evolutek/carte-actionneurs/Carte Stepper V1/Mapping STM32.PNG

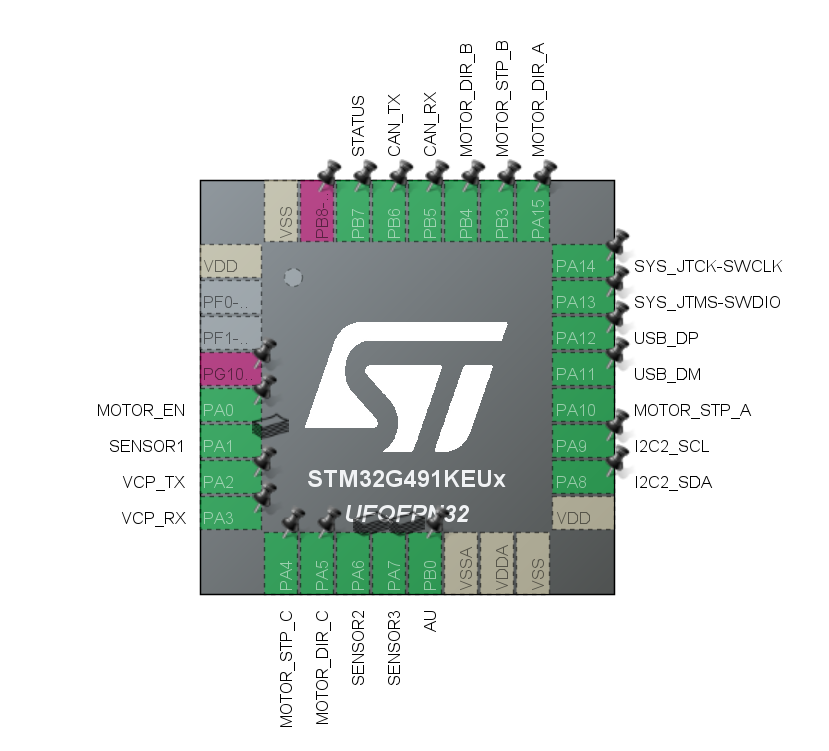
Carte Stepper V1/Mapping STM32.PNG
