evolutek/carte-actionneurs/Carte ADC/Output/carte-adc.step

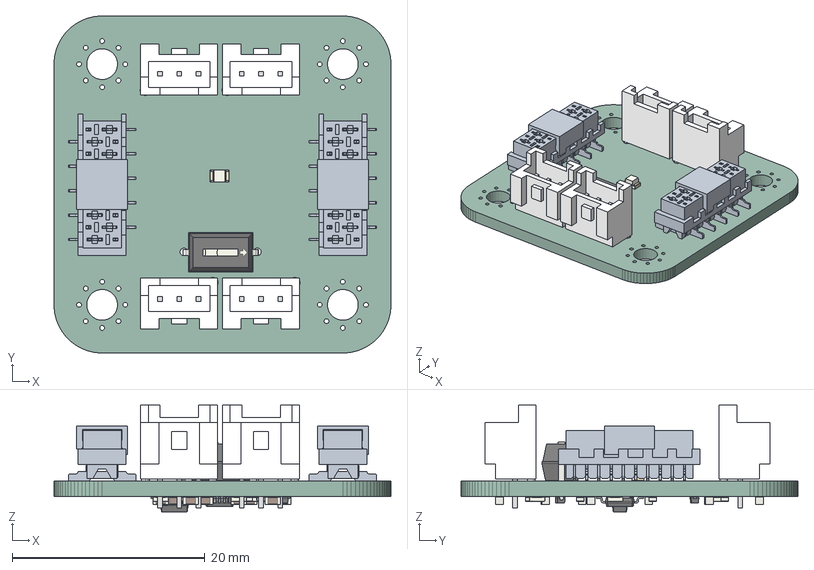
[picture p2: CAD file, 2025-06-11]
Carte ADC/Output/carte-adc.step
35.0 x 35.0 x 11.1 mm
Assem1 x 2
LED_0805_2012Metric
B03B-PASK-1 x 4
SW_DIP_SPSTx01_Slide_67x41mm_W762mm_P254mm_LowProfile
R_0603_1608Metric x 12
TSSOP_10_3x3mm_P05mm
C_0603_1608Metric x 11
D_SOD_523 x 4
SOT_23_5
carte-adc PCB
