evolutek/carte-actionneurs/Cartes PAL 2026/Carte Fixe/Output/carte-fixe V1.0.step

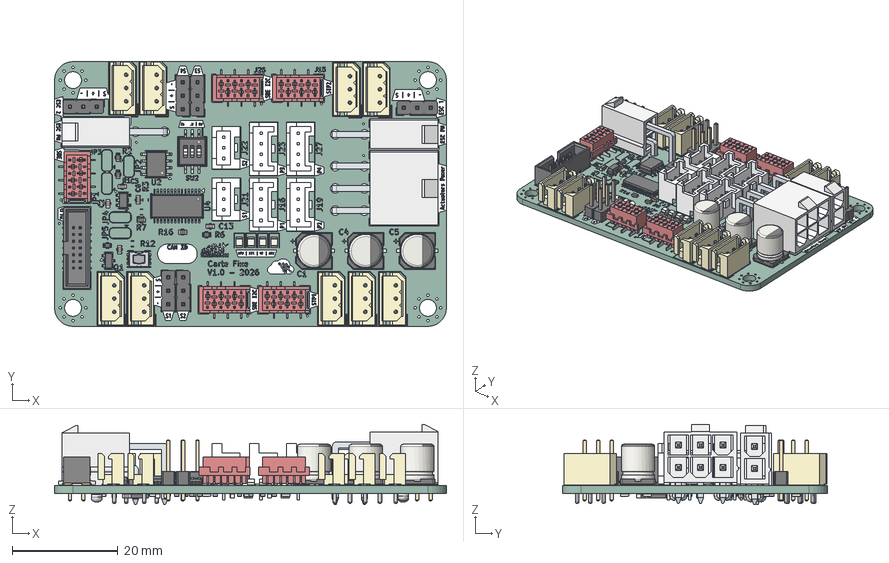
[picture p3: CAD file, 2026-10-21]
Cartes PAL 2026/Carte Fixe/Output/carte-fixe V1.0.step
74.0 x 50.0 x 15.2 mm
R_0603_1608Metric x 30
PinHeader_1x03_P2.54mm_Vertical x 6
SOIC-8_3.9x4.9mm_P1.27mm
B04B-PASK-1 x 4
6490xx227222_PIN x 5
6490xx227222_PIN_BIS x 5
CP_Elec_6.3x7.7 x 3
C_0603_1608Metric x 15
69036728xx76_PIN x 30
B03B-PASK-1 x 2
TSSOP-28_4.4x9.7mm_P0.65mm
QFN-32-1EP_5x5mm_P0.5mm_EP3.45x3.45mm
SOT-23-5
SW_DIP_SPSTx03_Slide_KingTek_DSHP03TS_W7.62mm_P1.27mm
Frame
Cover
Terminal
Button
SOT-23
6270xx20621_PIN x 14
LED_0805_2012Metric x 4
carte-fixe_silkscreen x 2
carte-fixe_PCB
