evolutek/carte-actionneurs/Cartes PAL 2026/Carte Mobile/Output/carte-mobile V1.0.step

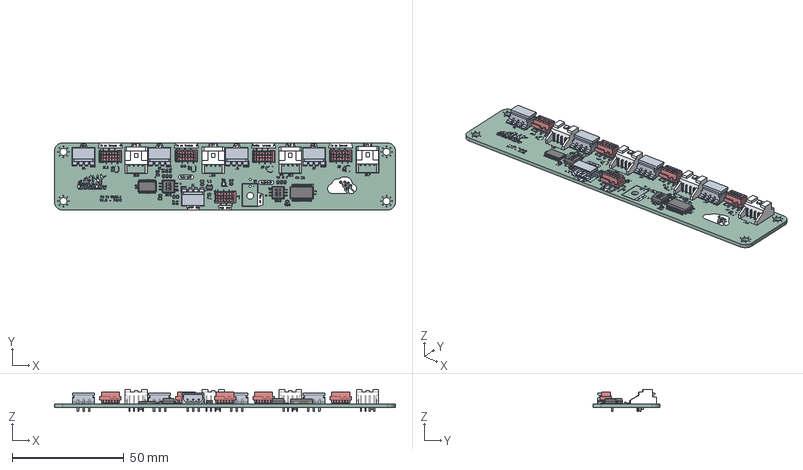
[picture p4: CAD file, 2026-10-21]
Cartes PAL 2026/Carte Mobile/Output/carte-mobile V1.0.step
152.5 x 30.0 x 9.95 mm
R_0603_1608Metric x 11
69036728xx76_PIN x 30
SOT-23-5
C_0603_1608Metric x 8
SSOP-28_5.3x10.2mm_P0.65mm
S04B-PASK-2 x 4
SW_DIP_SPSTx03_Slide_KingTek_DSHP03TS_W7.62mm_P1.27mm x 2
LED_0805_2012Metric
TSSOP-24_4.4x7.8mm_P0.65mm
carte-mobile_silkscreen x 2
carte-mobile_PCB
