evolutek/carte-actionneurs/Constellations actionneurs/Hololutek 2026 - Doigts/Output/Doigts 1.0.step

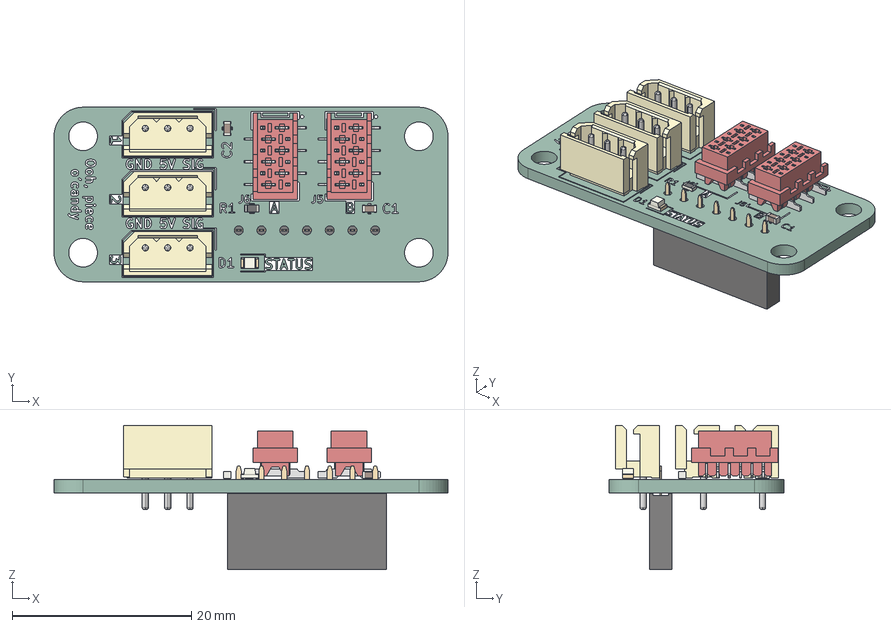
[picture p5: CAD file, 2026-05-03]
Constellations actionneurs/Hololutek 2026 - Doigts/Output/Doigts 1.0.step
44.0 x 19.5 x 16.1 mm
C_0603_1608Metric x 2
LED_0805_2012Metric
69036728xx76_PIN x 12
R_0603_1608Metric
PinSocket_1x07_P2.54mm_Vertical
Doigts_silkscreen x 2
Doigts_PCB
