evolutek/carte-actionneurs/Constellations actionneurs/Hololutek 2026 - Repartiteur/Output/Repartiteur 1.0.step

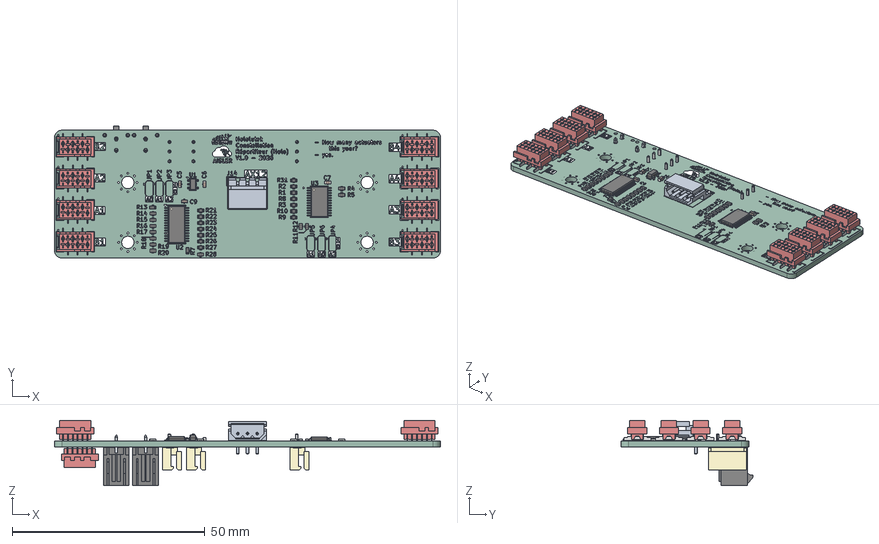
[picture p6: CAD file, 2026-05-03]
Constellations actionneurs/Hololutek 2026 - Repartiteur/Output/Repartiteur 1.0.step
100.0 x 34.2 x 16.9 mm
TSSOP-28_4.4x9.7mm_P0.65mm
R_0603_1608Metric x 28
69036728xx76_PIN x 54
TSSOP-24_4.4x7.8mm_P0.65mm
C_0603_1608Metric x 4
SOT-23-5
6620xx21122_PIN x 4
Repartiteur_silkscreen x 2
Repartiteur_PCB
