evolutek/carte-actionneurs/Cartes PAL 2026/Carte Fixe/Output/carte-fixe.pdf

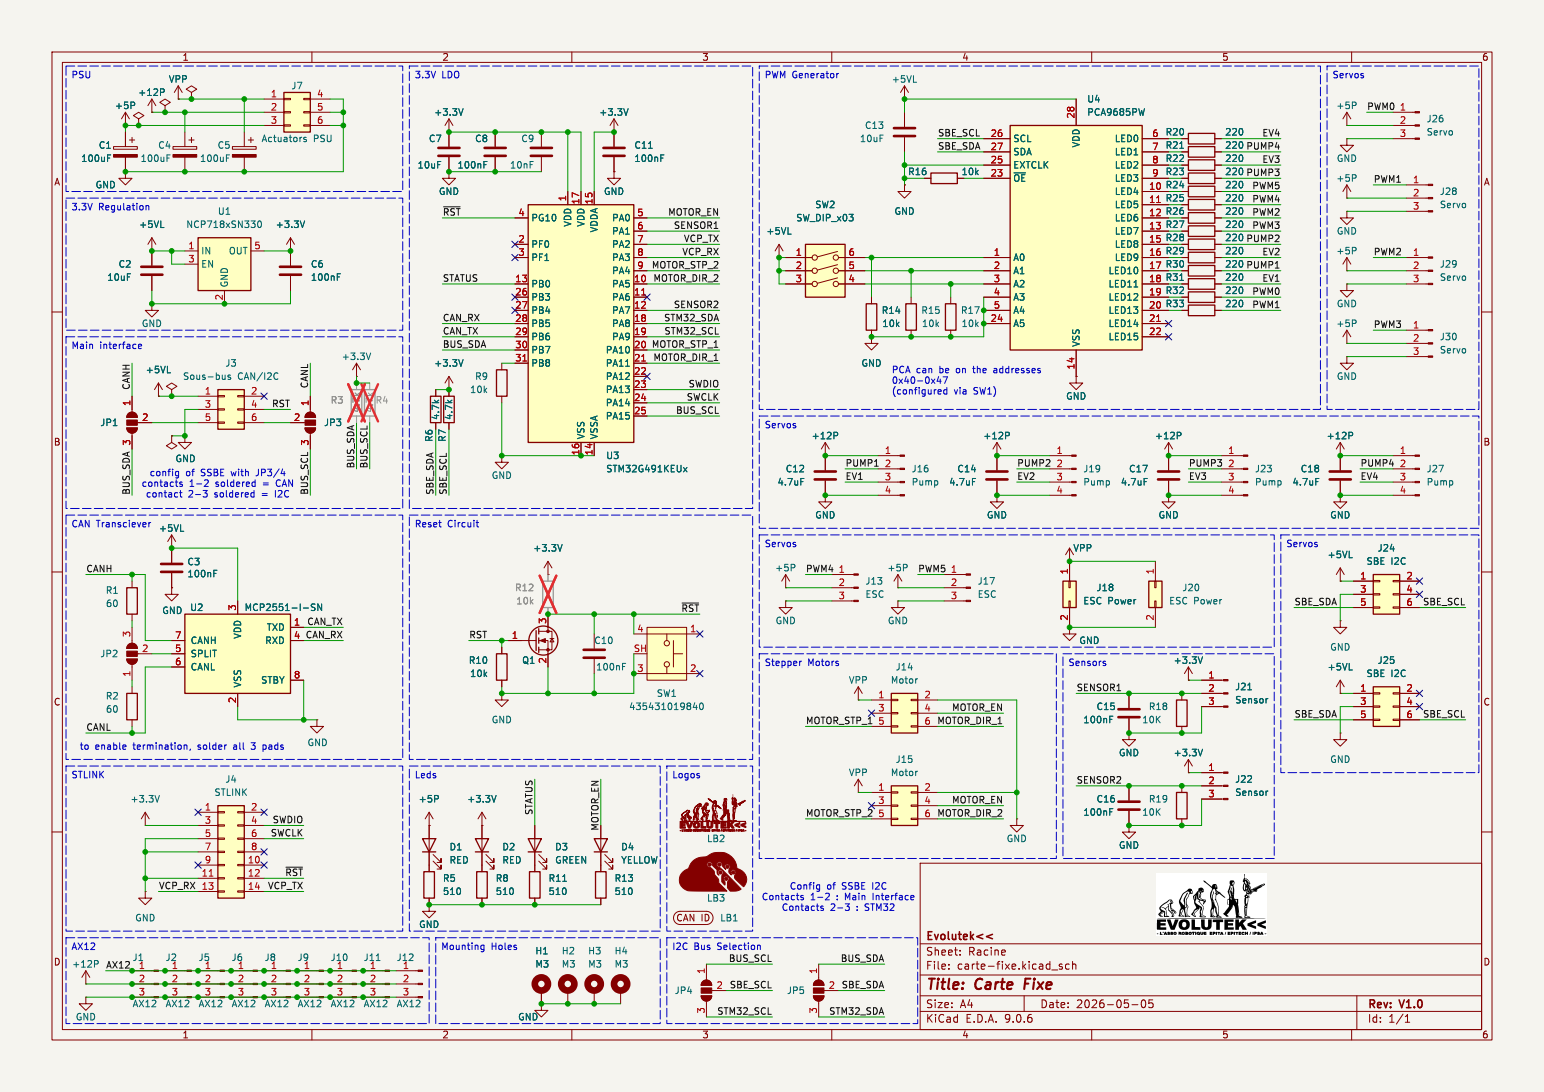
[picture p7: page 1]

1 VDD 17 VSS 16 VDDA 15 VSSA 14 PA0 5 PA1 6 PA2 7 PA3 8 PA4 9 PA5 10 PA6 11 PA7 12 PA8 18 PA9 19 PA10 20 PA11 21 PA12 22 PA13 23 PA14 24 PA15 25 +3.3V GND

1 VDD 17 VSS 16 VDDA 15 VSSA 14 PA0 5 PA1 6 PA2 7 PA3 8 PA4 9 PA5 10 PA6 11 PA7 12 PA8 18 PA9 19 PA10 20 PA11 21 PA12 22 PA13 23 PA14 24 PA15 25 U3STM32G491KEUx +5VL R6 4.7k

GND
PCA can be on the addresses 0x40-0x47

config of SSBE with JP3/4

J18 ESC Power TXD 1 RXD 4 STBY 8 VDD

2 CANH 7 SPLIT 5 CANL 6 U2 MCP2551-I-SN

3 VSS
TXD 1 RXD 4 STBY 8 VDD

File: carte-fixe.kicad_sch Sheet: Racine Evolutek<<

Id: 1/1 Title: Carte Fixe
