evolutek/carte-actionneurs/Cartes PAL 2026/Carte Mobile/Output/carte-mobile.pdf

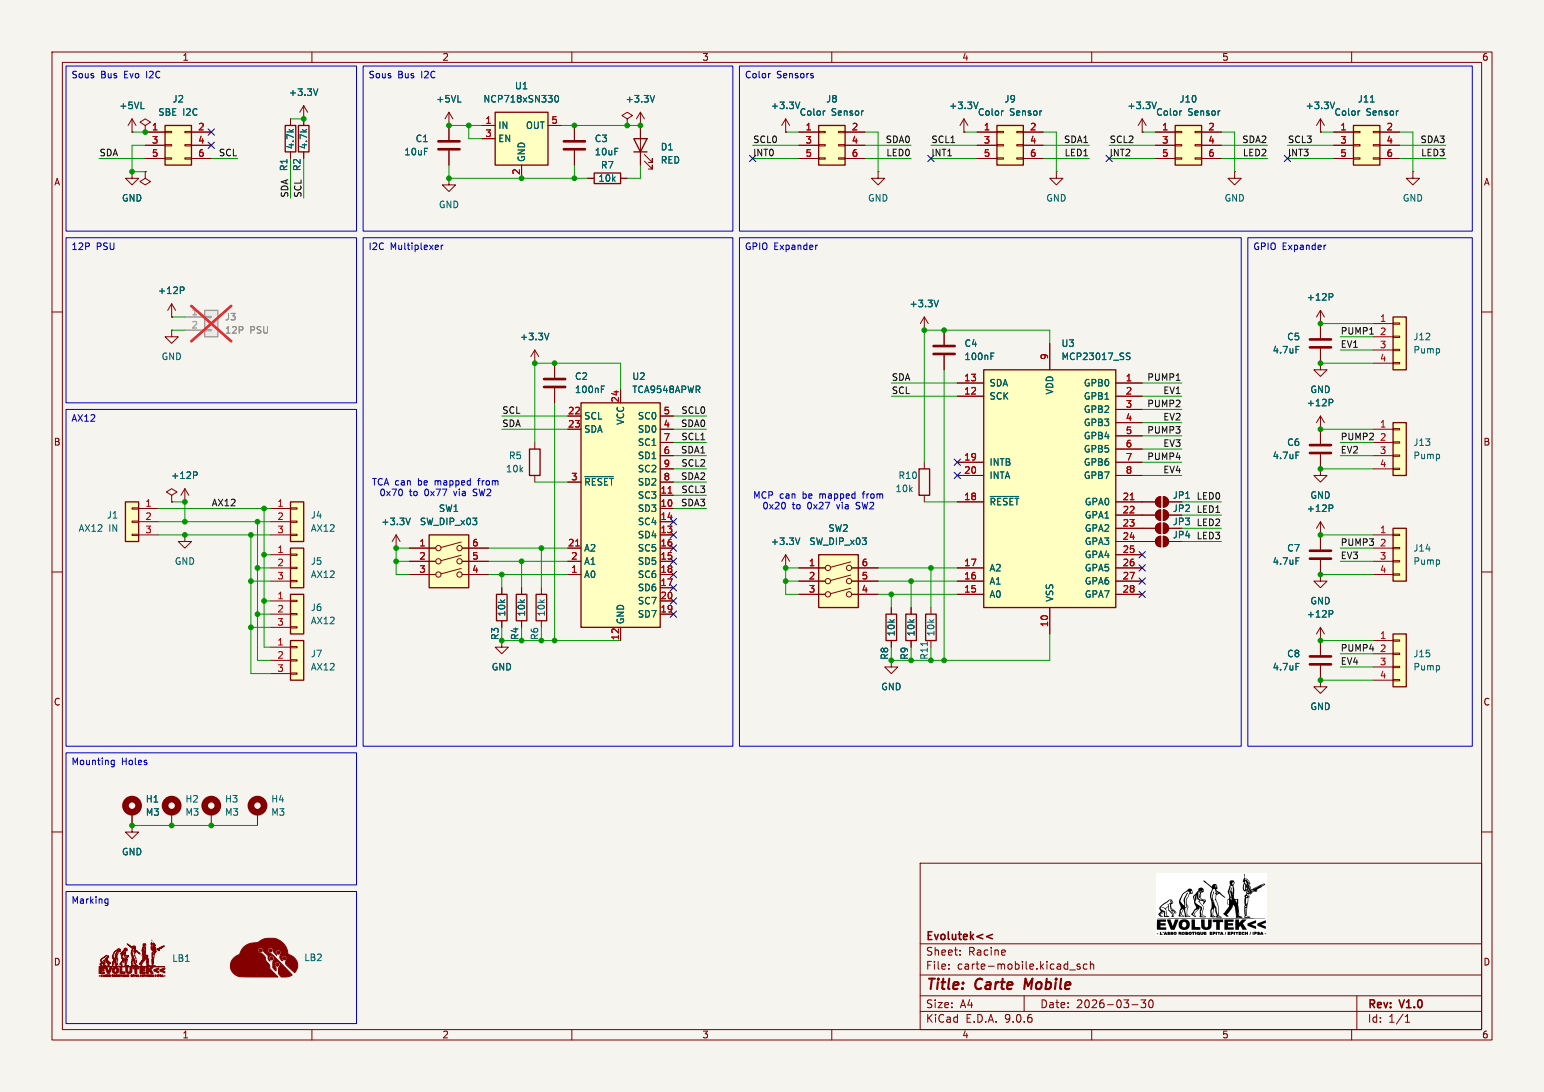
[picture p8: page 1]

Color Sensors Mounting Holes

2 OUT 5 U1 NCP718xSN330 +3.3V +3.3V R7
J11 Color Sensor GND GND

0x20 to 0x27 via SW2 TCA can be mapped from
0x70 to 0x77 via SW2

File: carte-mobile.kicad_sch Sheet: Racine Evolutek<<

Id: 1/1 Title: Carte Mobile
