evolutek/carte-actionneurs/Constellations actionneurs/Hololutek 2026 - Repartiteur/Output/Repartiteur.pdf

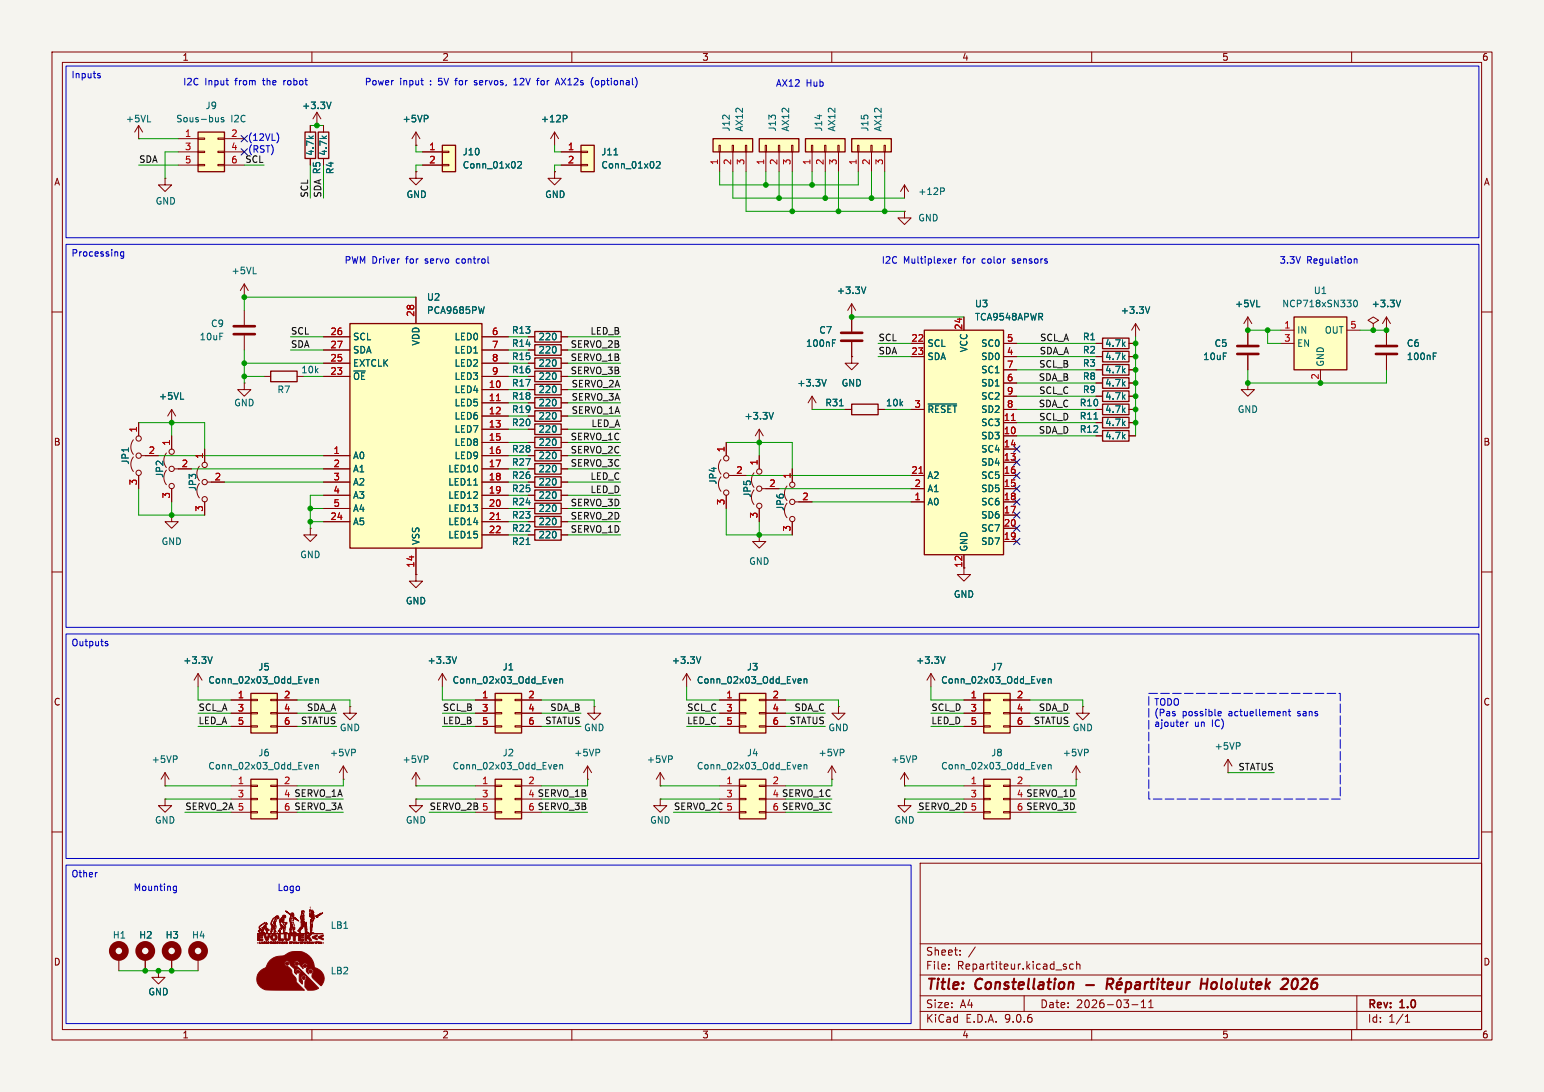
[picture p9: page 1]

3 J14 AX12 SCL 22 SDA 23 ~{RESET} 3 A2 21 A1 2 A0 1 VCC 24 GND 12 SC0 5 SD0 4 SC1 7 SD1 6 SC2 9 SD2 8 SC3 11 SD3 10 SC4 14 SD4 13 SC5 16 SD5 15 SC6 18 SD6 17 SC7 20 SD7 19 U3 TCA9548APWR
