evolutek/carte-actionneurs/Carte ADC/Output/Schematics.pdf

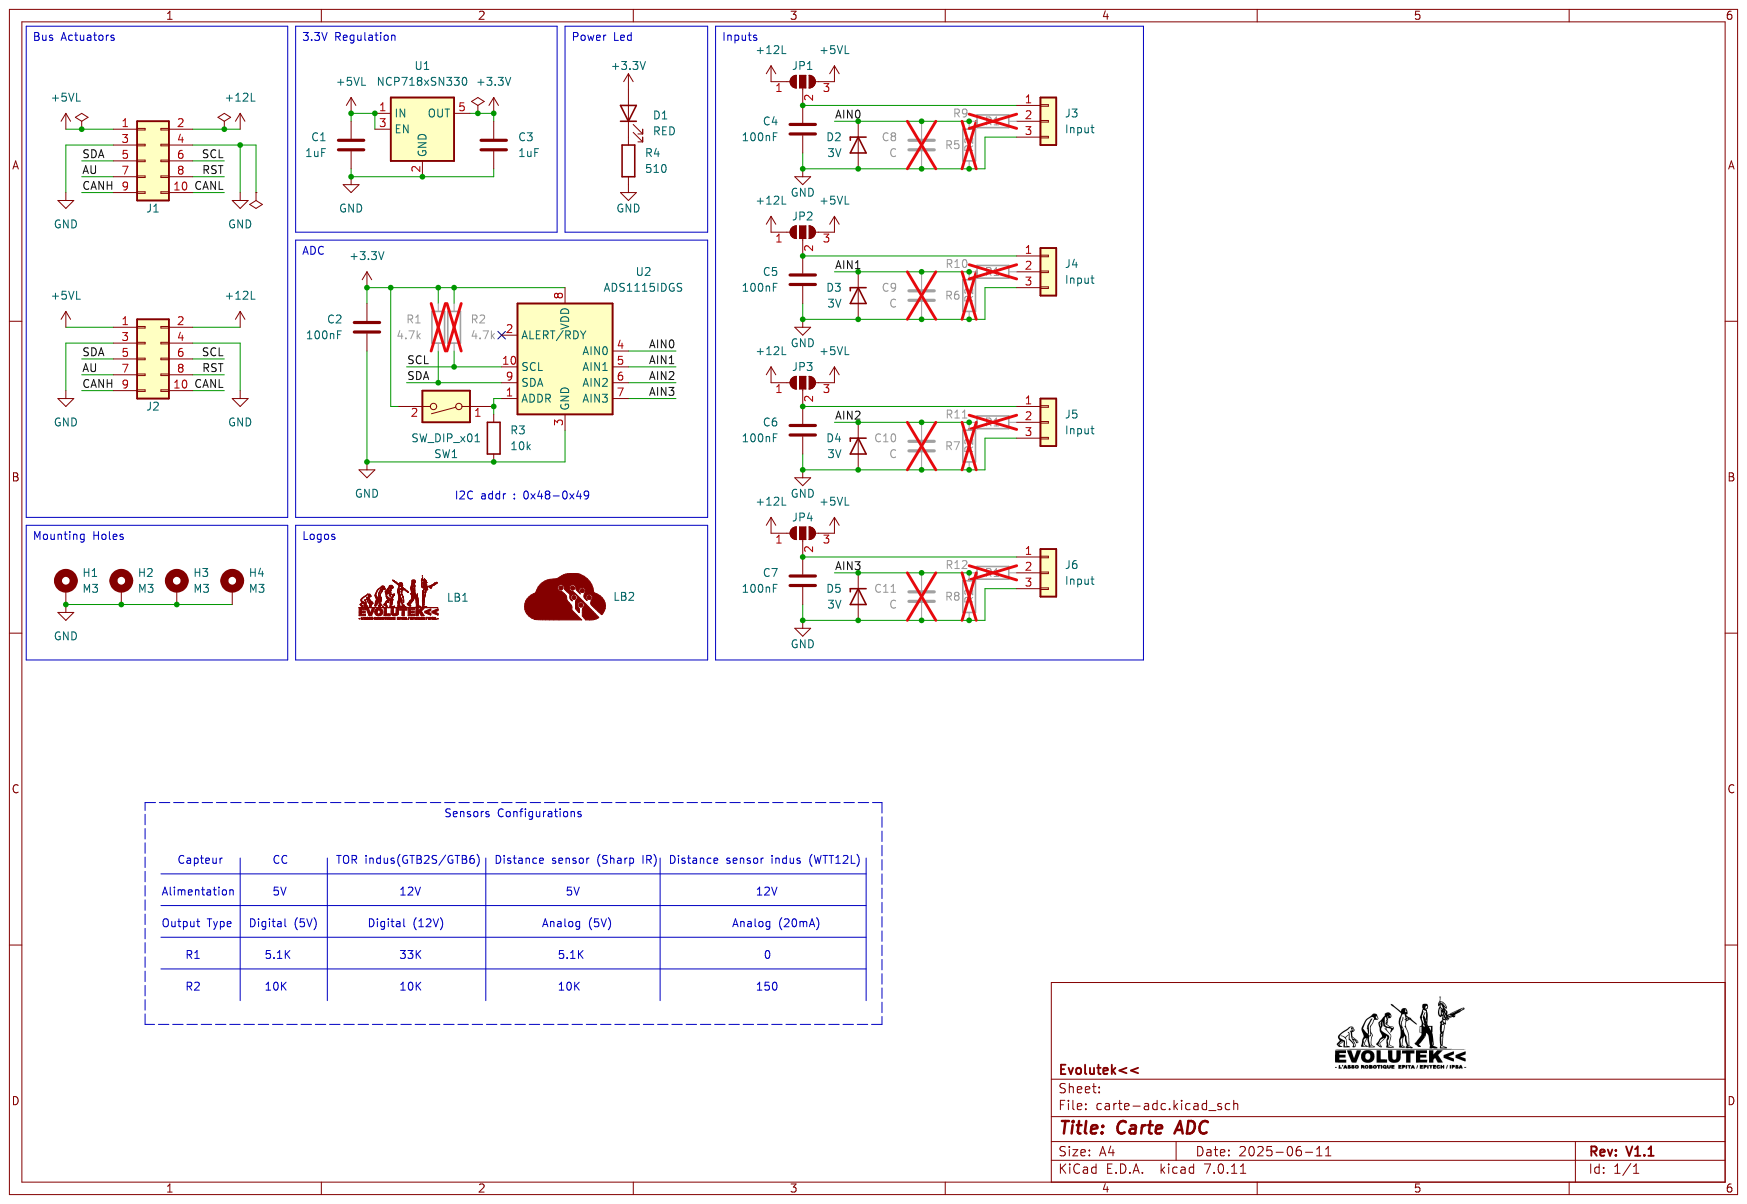
[picture p10: page 1]
