evolutek/carte-actionneurs/Carte Test Pont en H/Output/Schematics.pdf

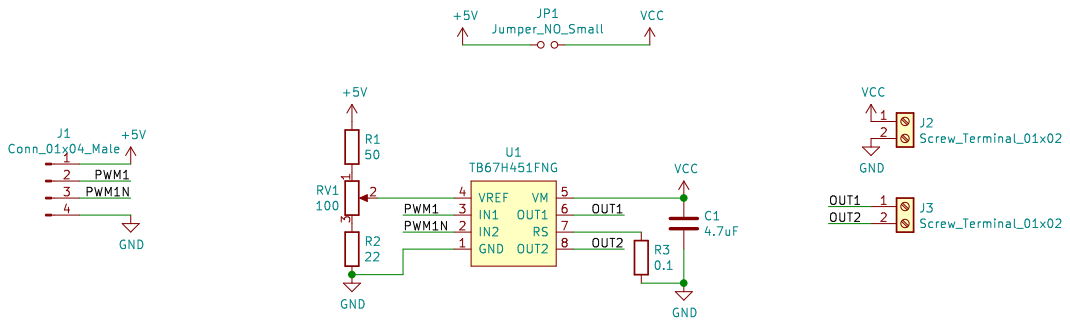
[picture p11: page 1]
