evolutek/carte-actionneurs/Carte ADC/Output/Board-Back.pdf

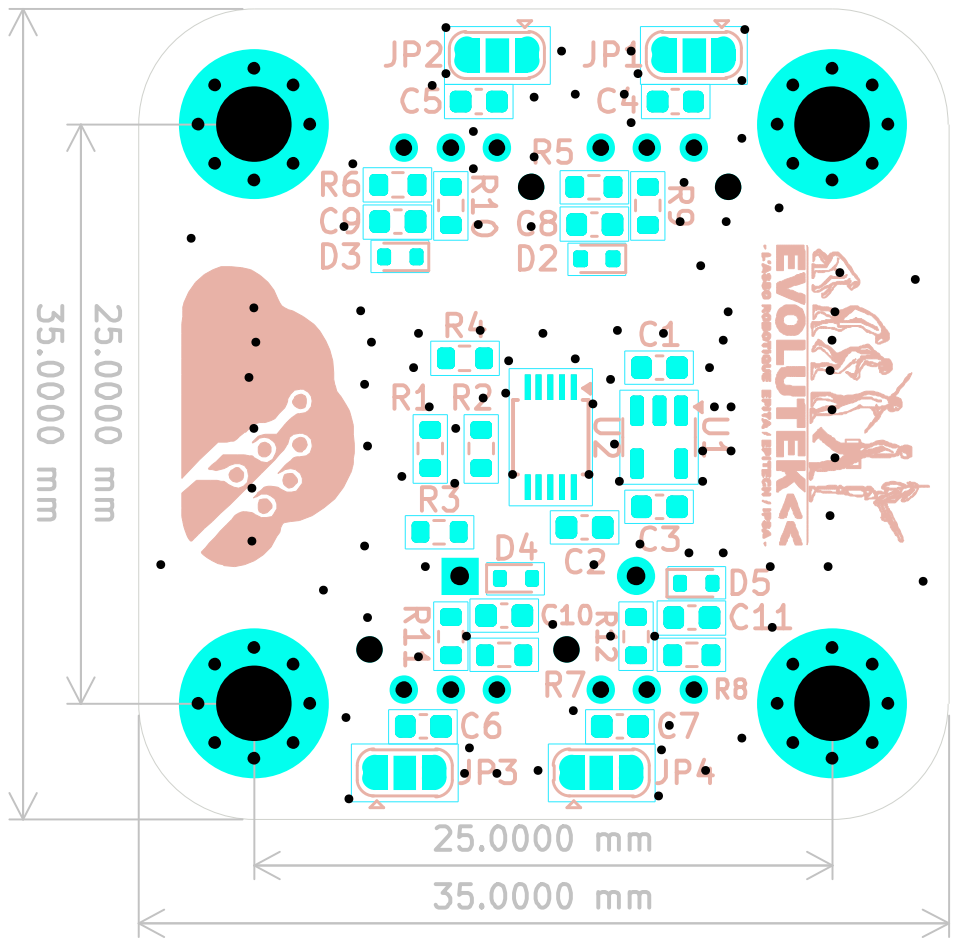
[picture p12: page 1]
