evolutek/carte-actionneurs/Carte ADC/Output/Board-Front.pdf

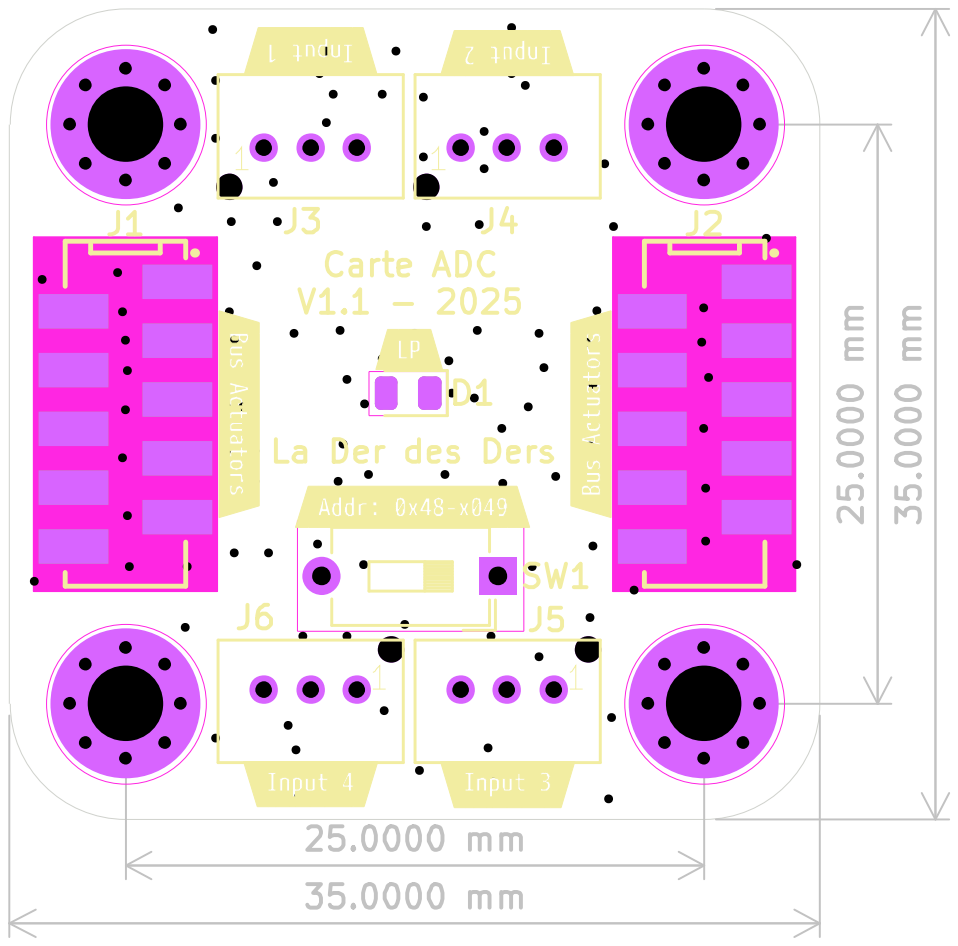
[picture p13: page 1]
