evolutek/carte-actionneurs/Constellations actionneurs/Hololutek 2026 - Doigts/Output/Doigts.pdf

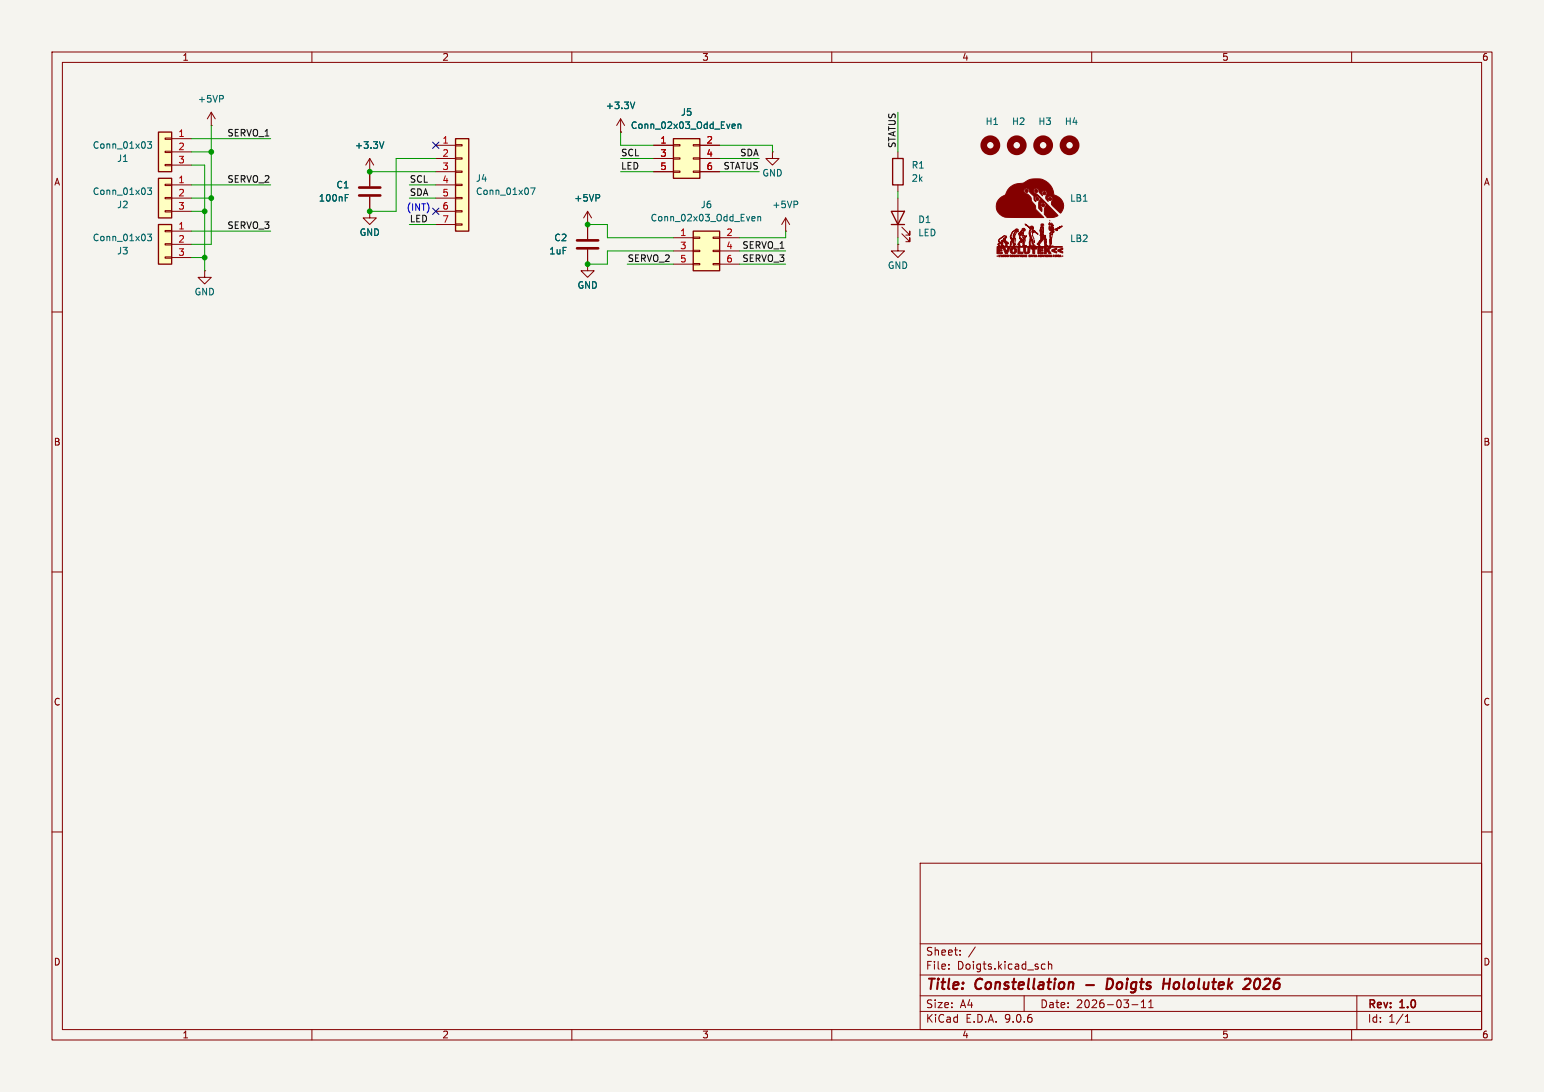
[picture p14: page 1]
