evolutek/carte-actionneurs/Carte Stepper V1/Output/Schematics.pdf

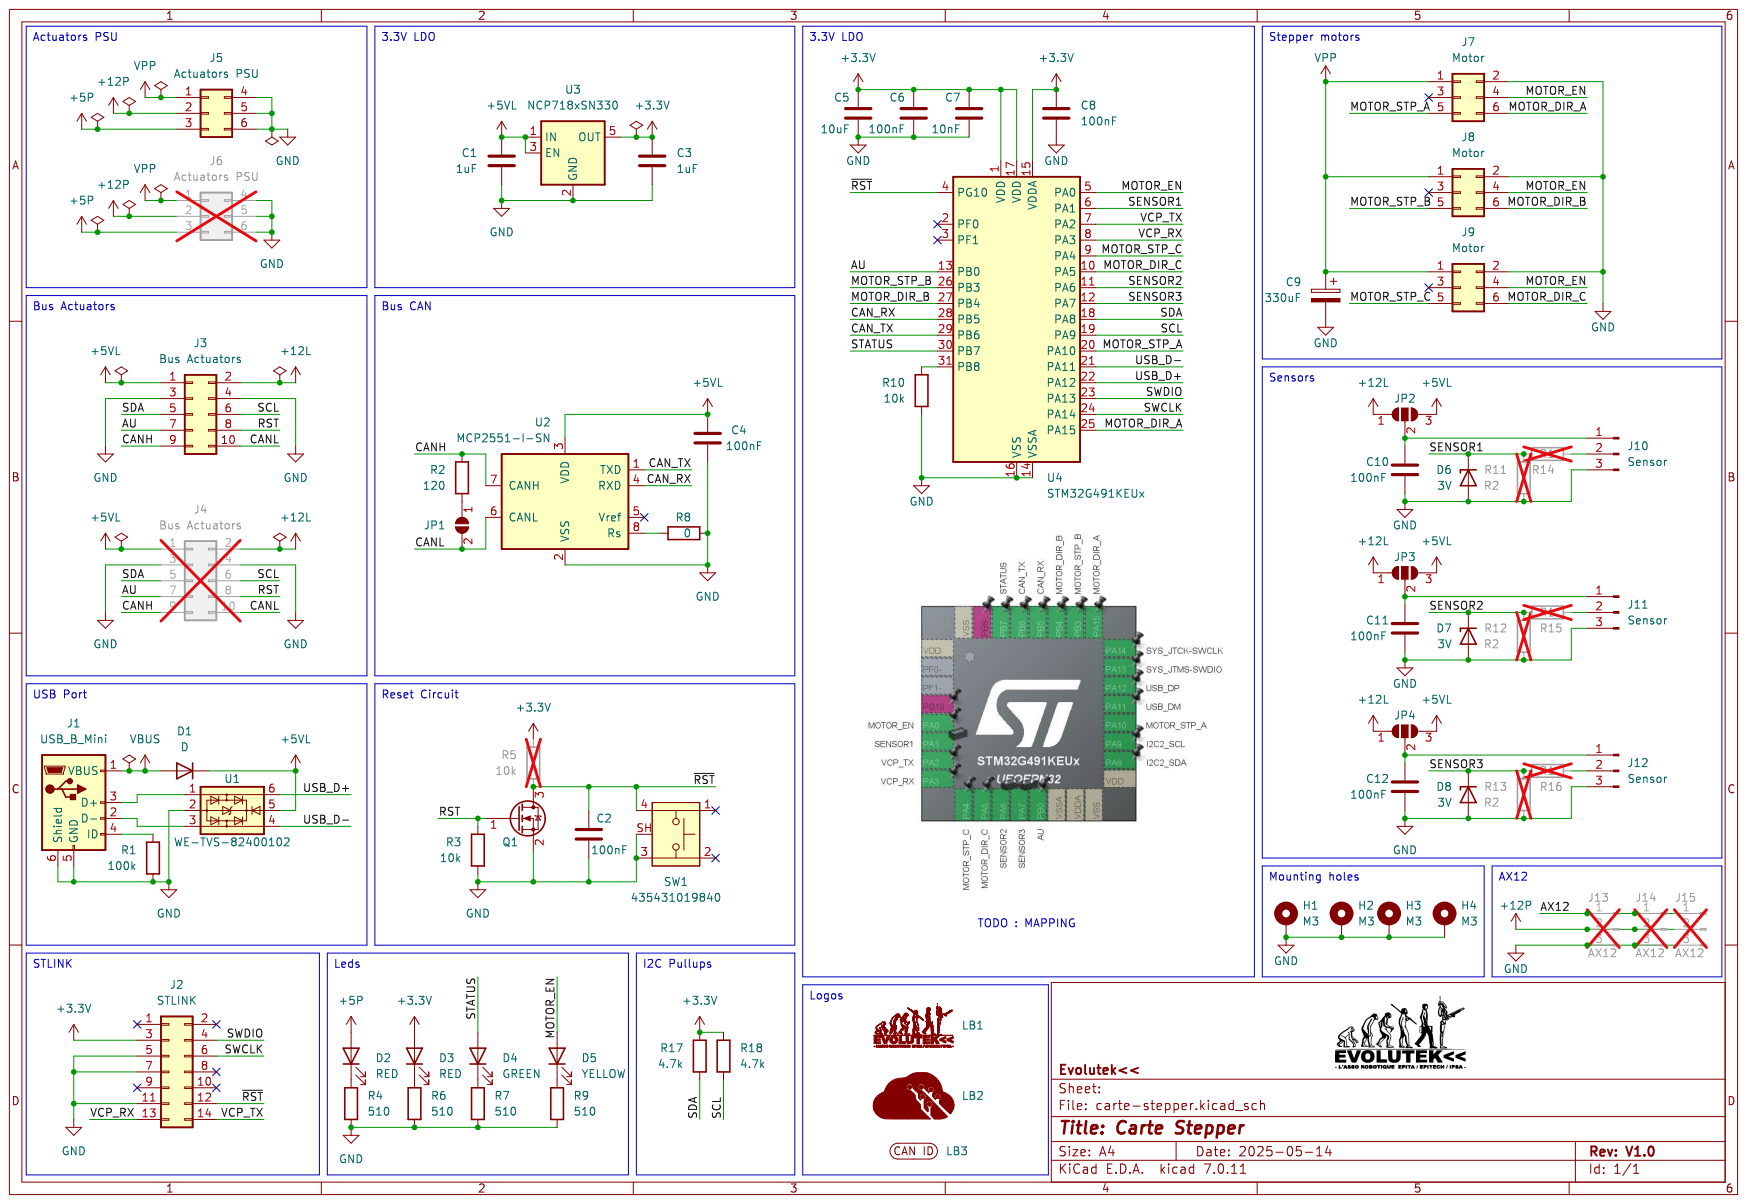
[picture p19: page 1]
