evolutek/carte-actionneurs/Hub Bus Actuators/Output/Schematics.pdf

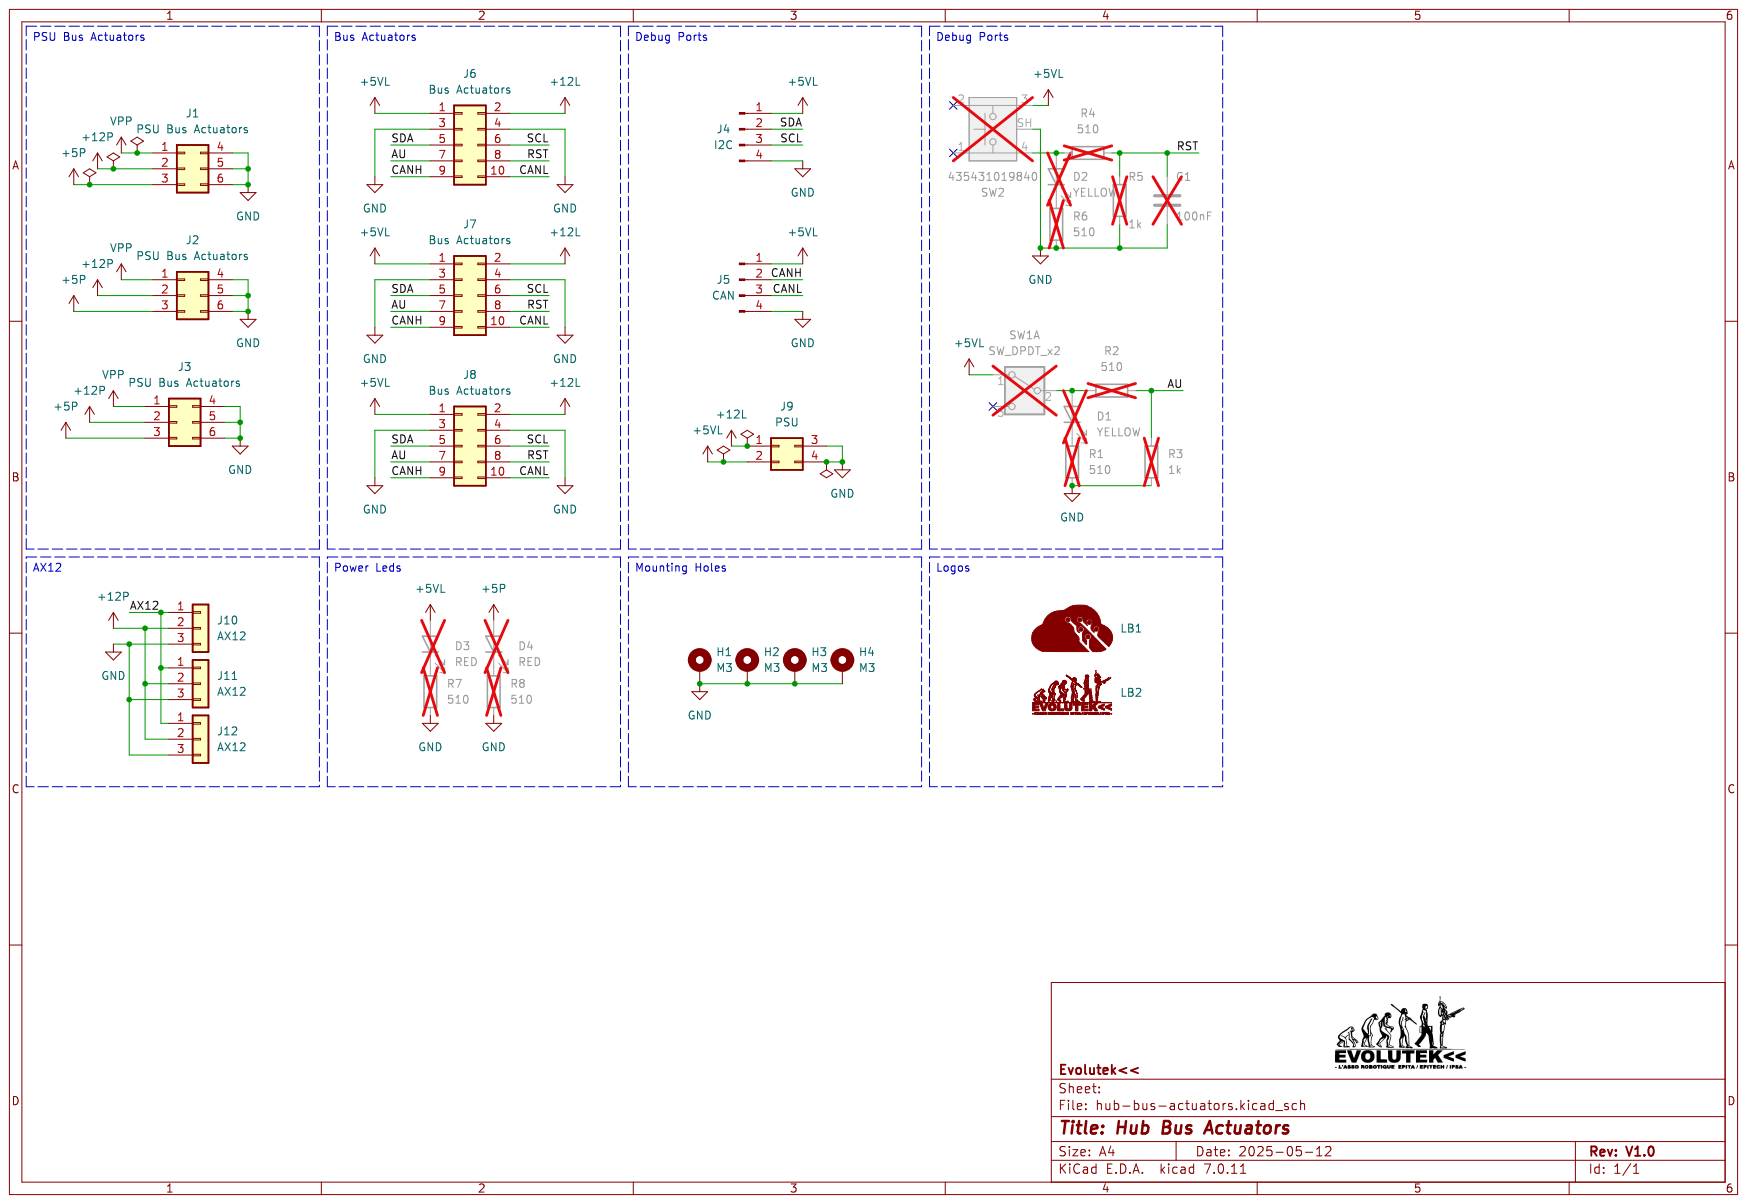
[picture p20: page 1]
