evolutek/carte-actionneurs/V3 - Bis/Output/Schematics.pdf

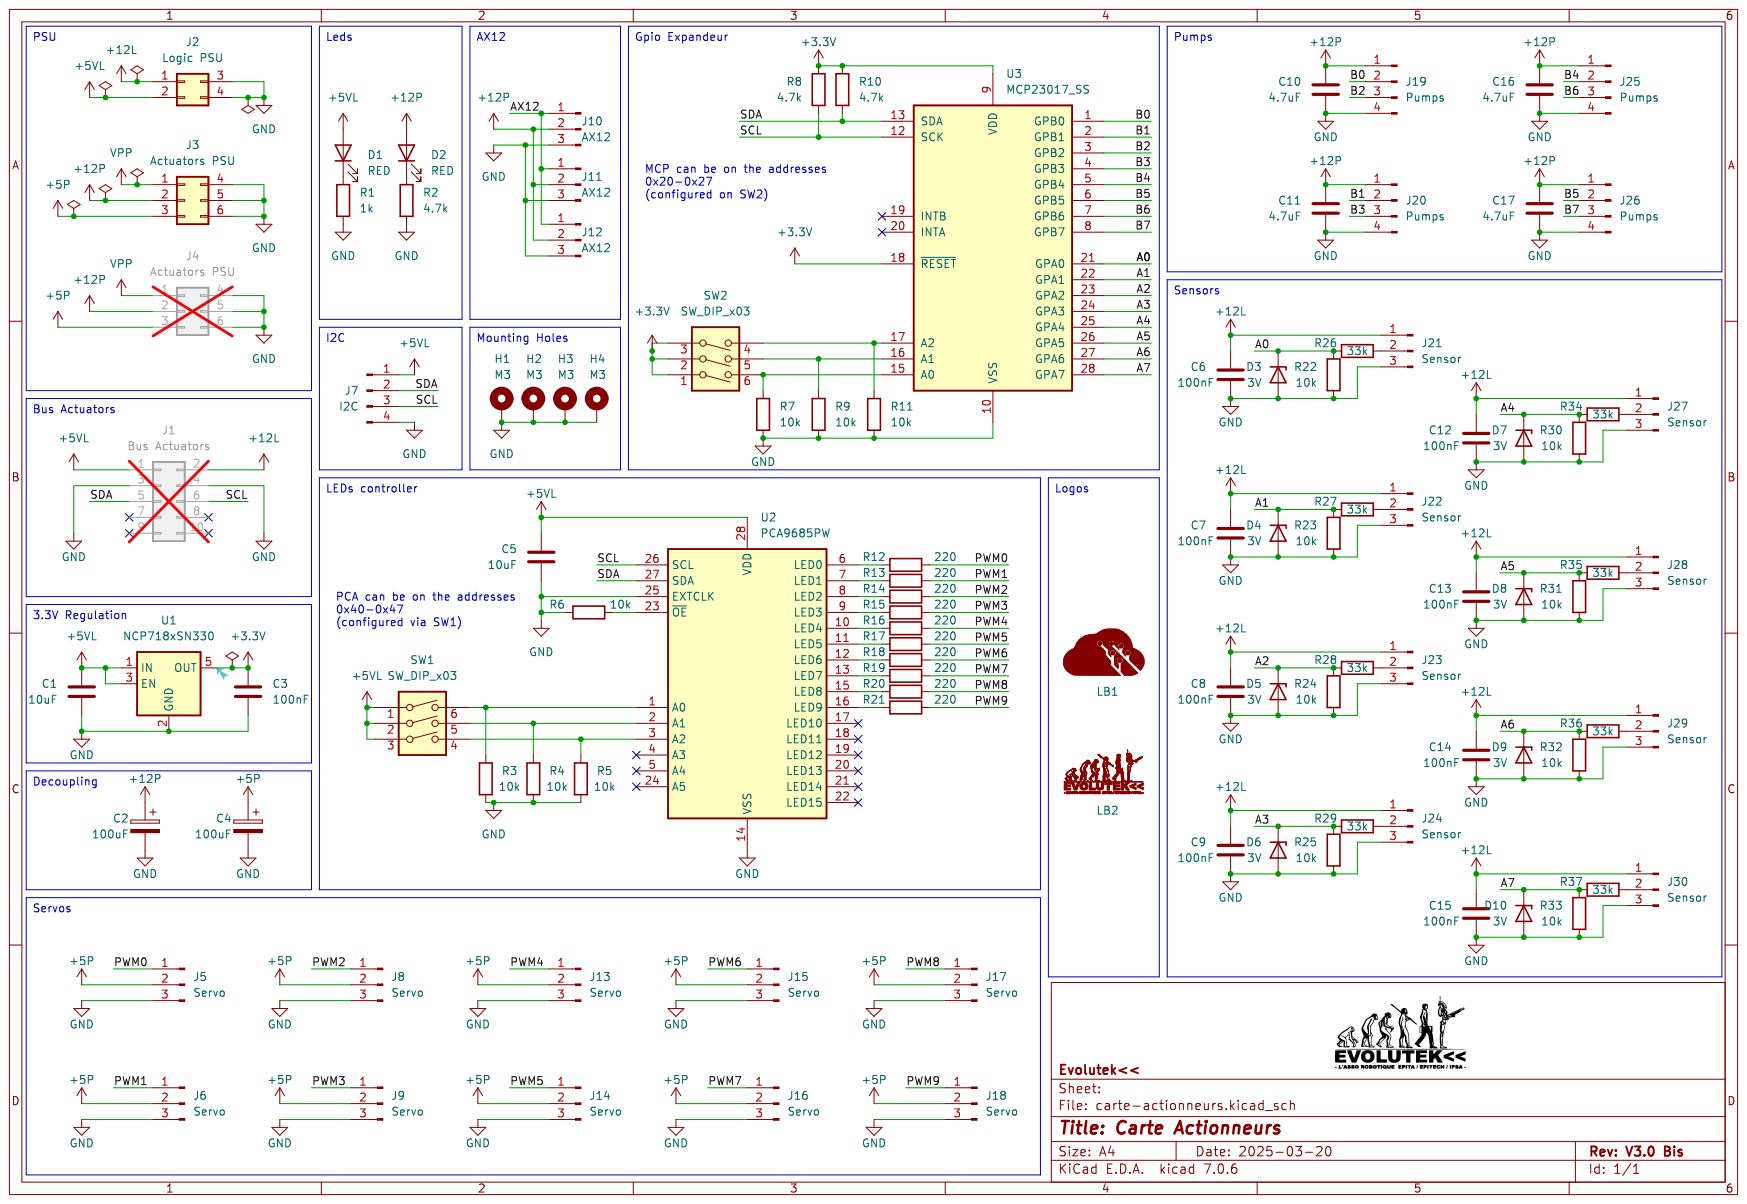
[picture p21: page 1]
