evolutek/carte-actionneurs/V3/Output/Schematics.pdf

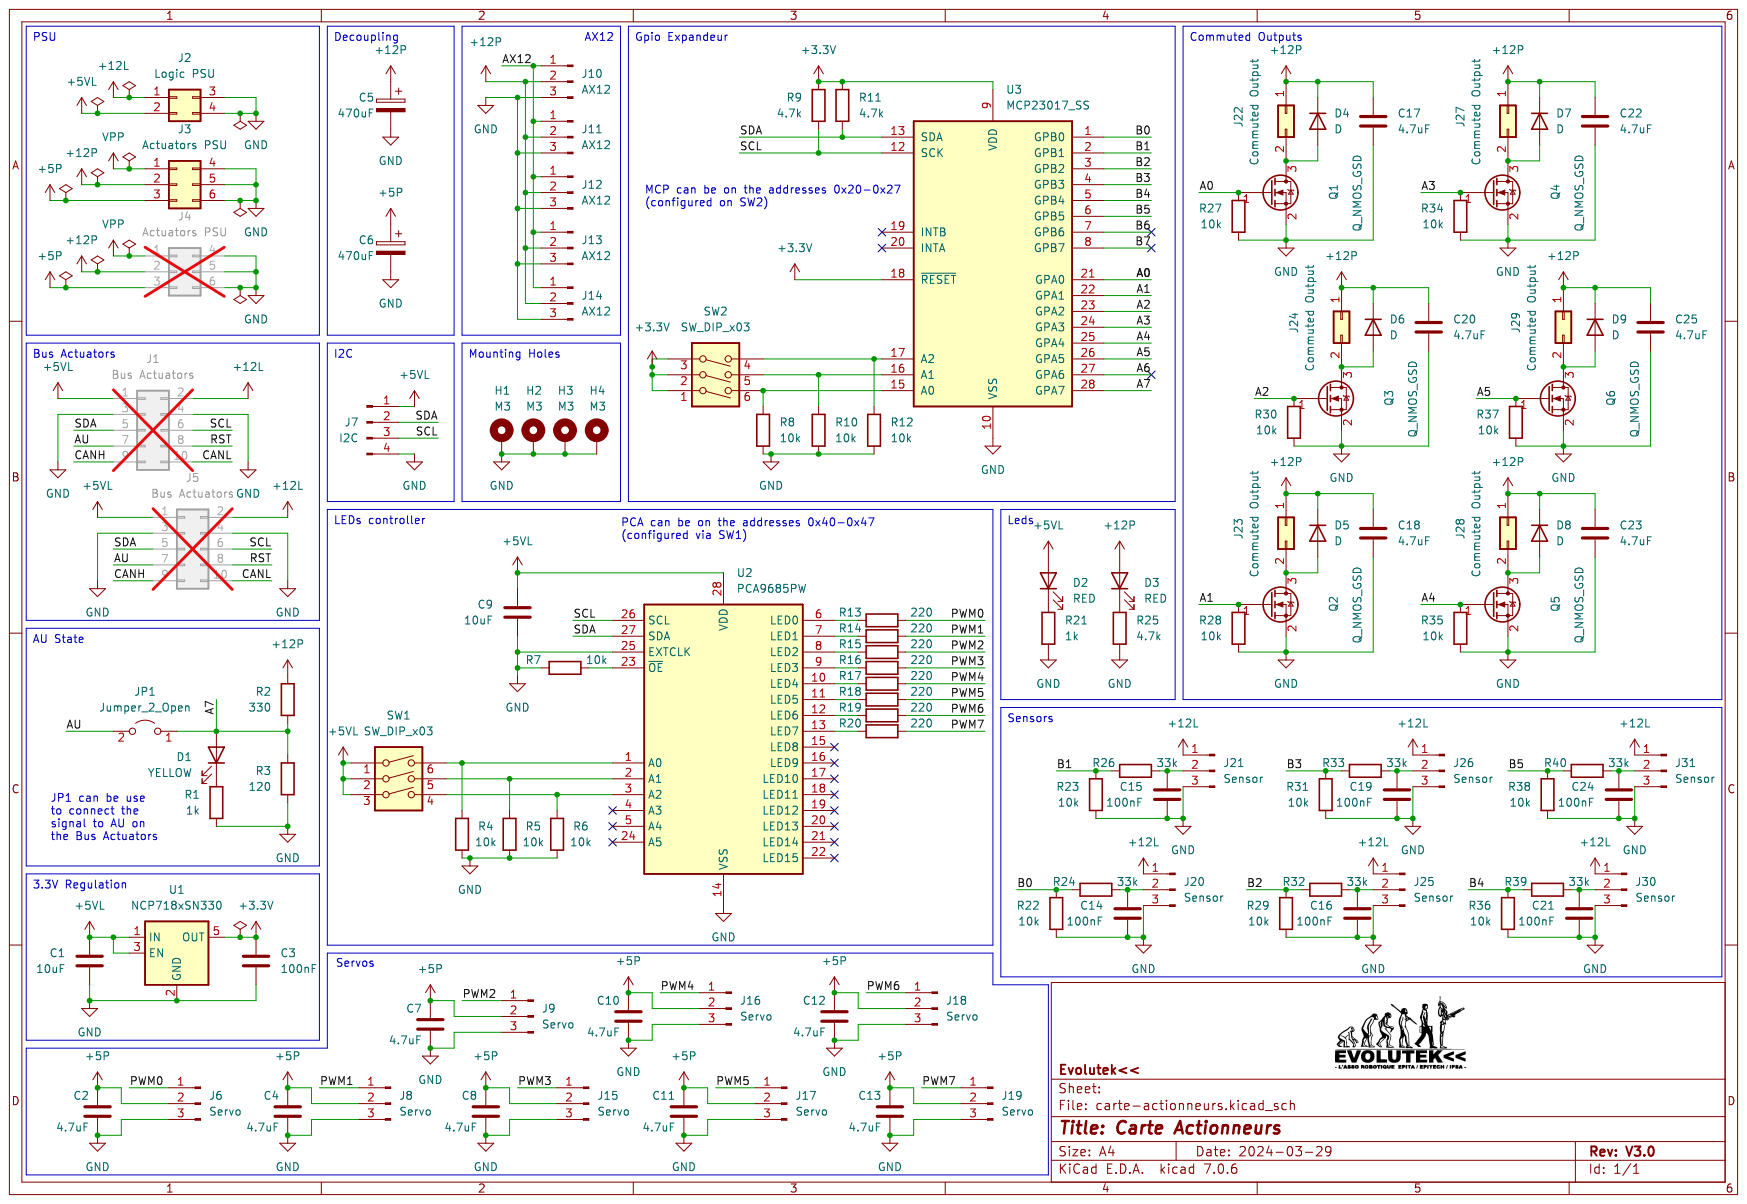
[picture p22: page 1]
