evolutek/carte-actionneurs/V2/Output/Schematics.pdf

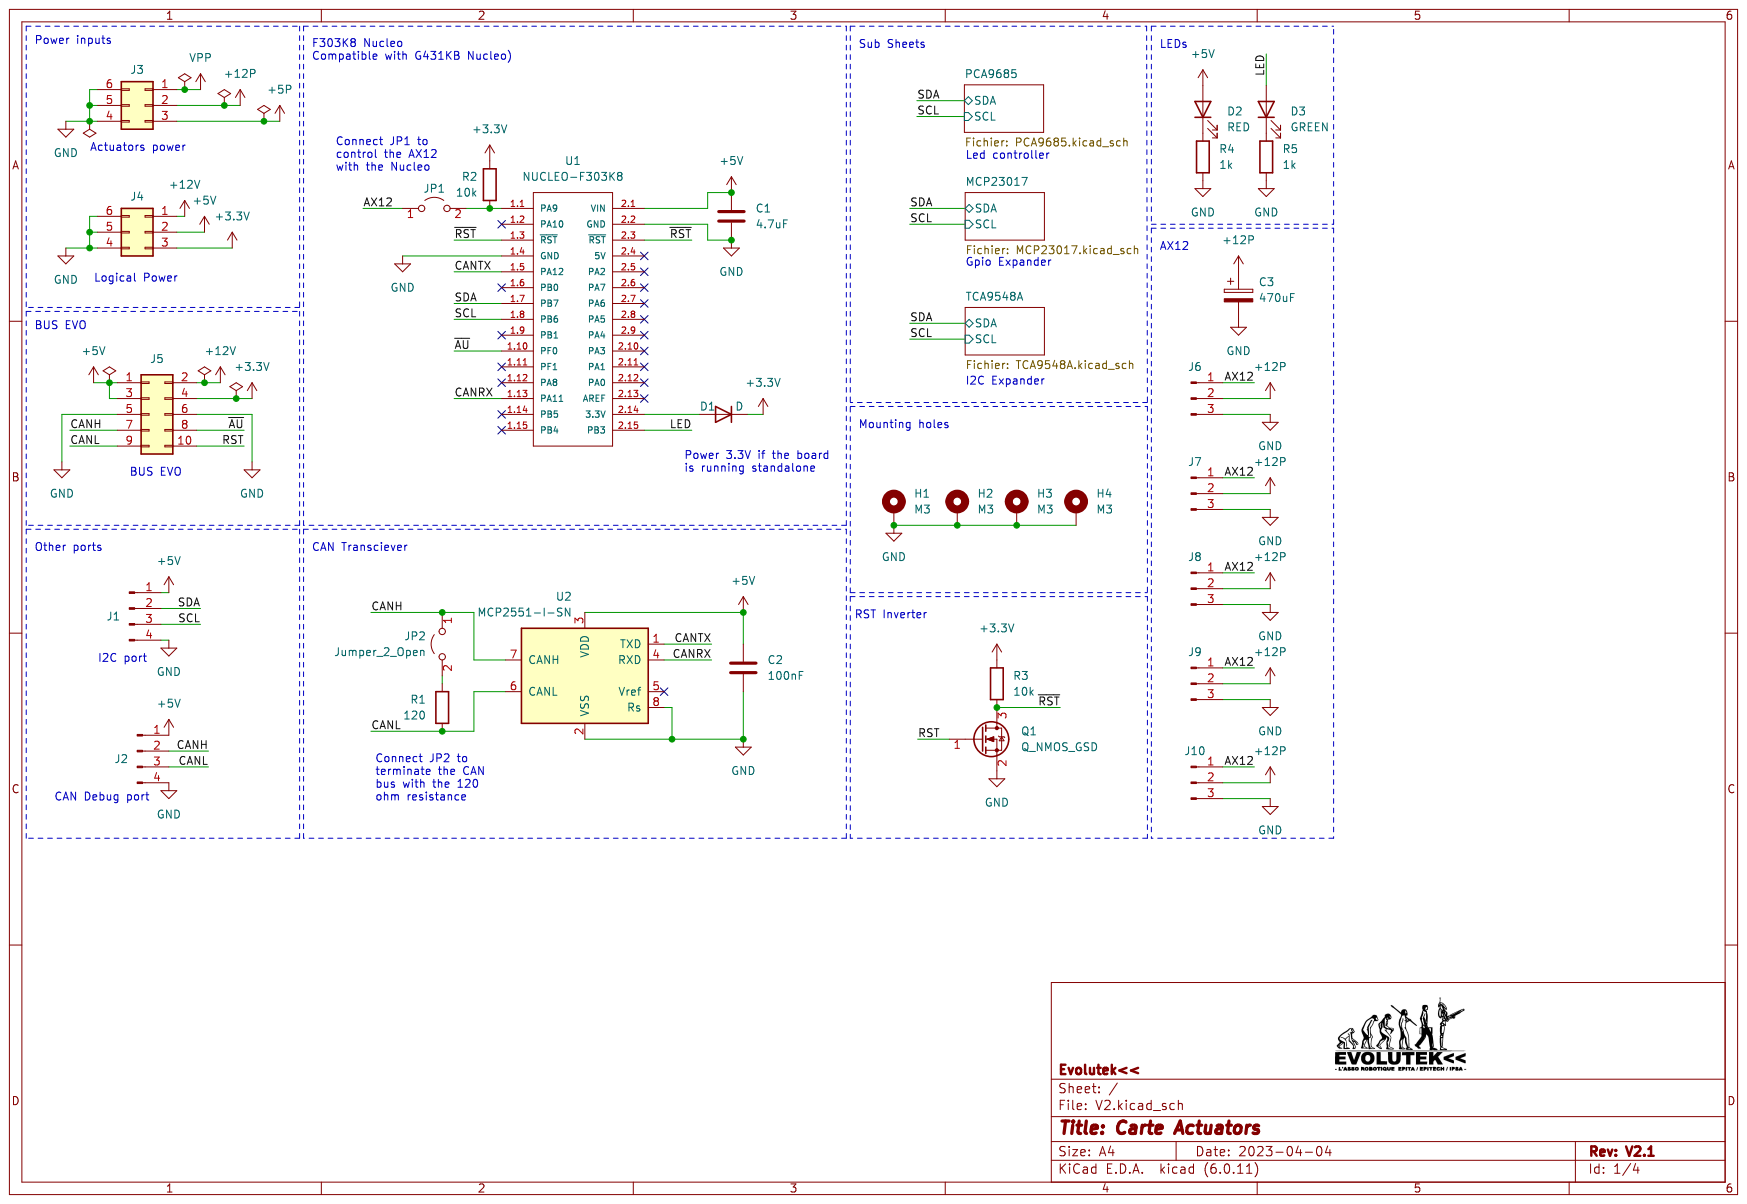
[picture p23: page 1]

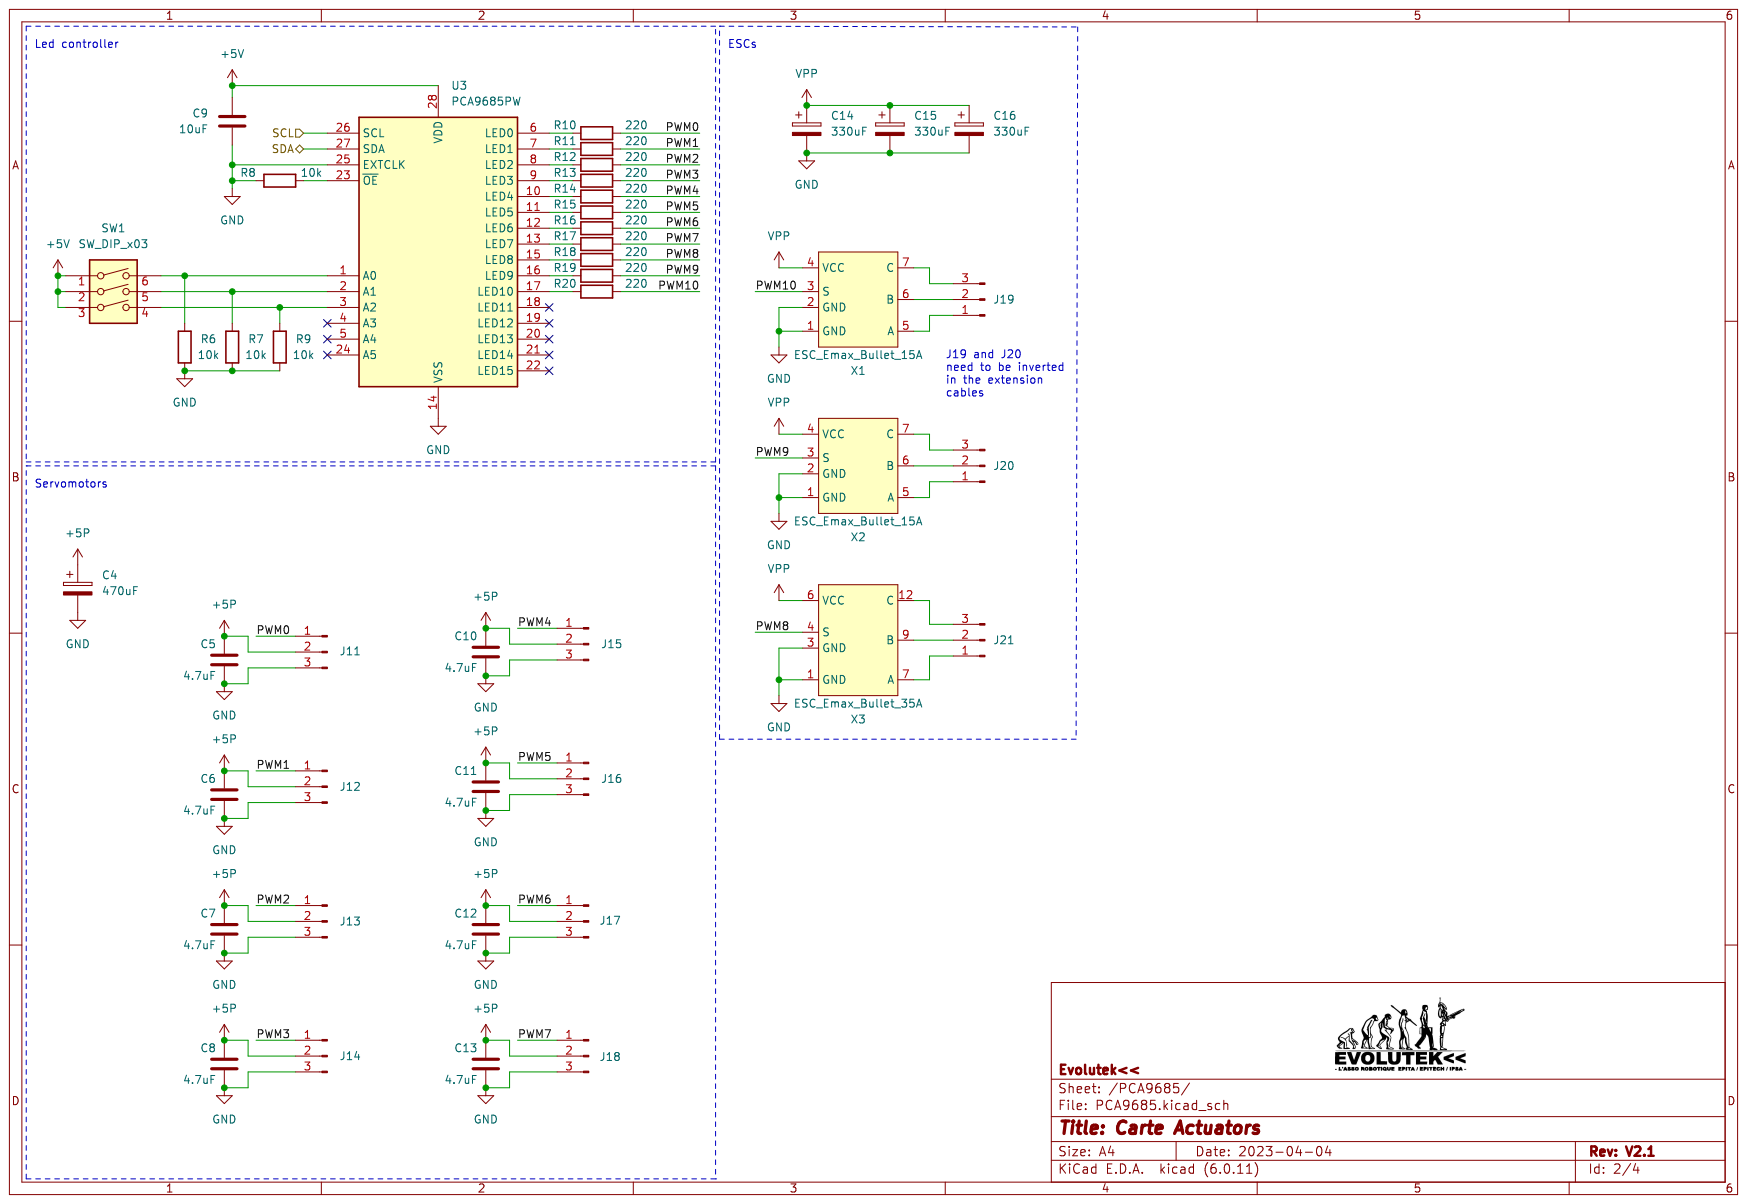
[picture p24: page 2]

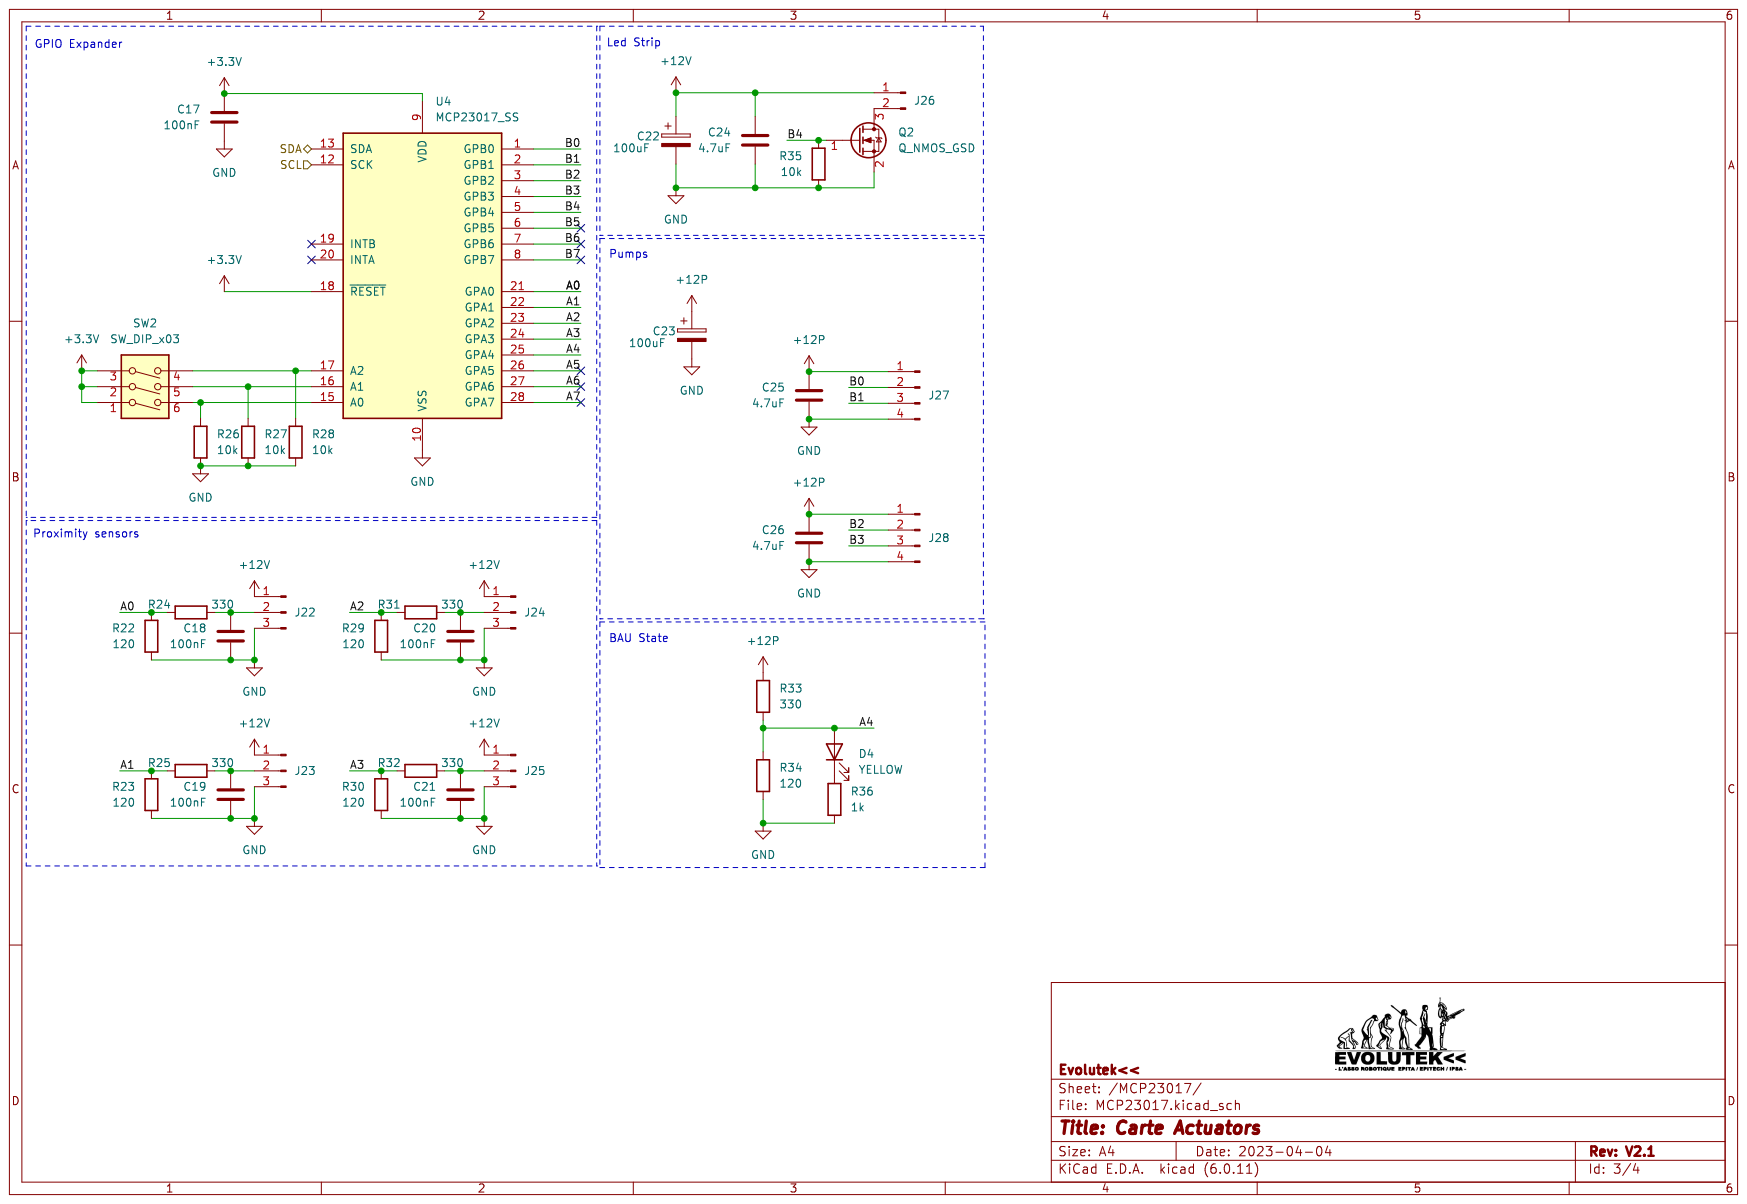
[picture p25: page 3]

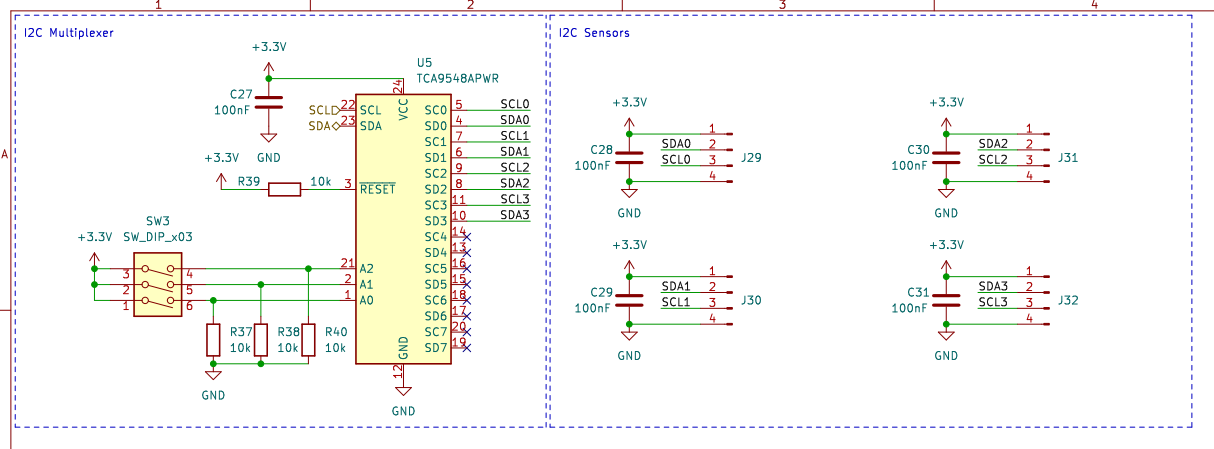
[picture p26: page 4]
