evolutek/carte-actionneurs/CarteRallongeActionneurs2022/Output/Schematics.pdf

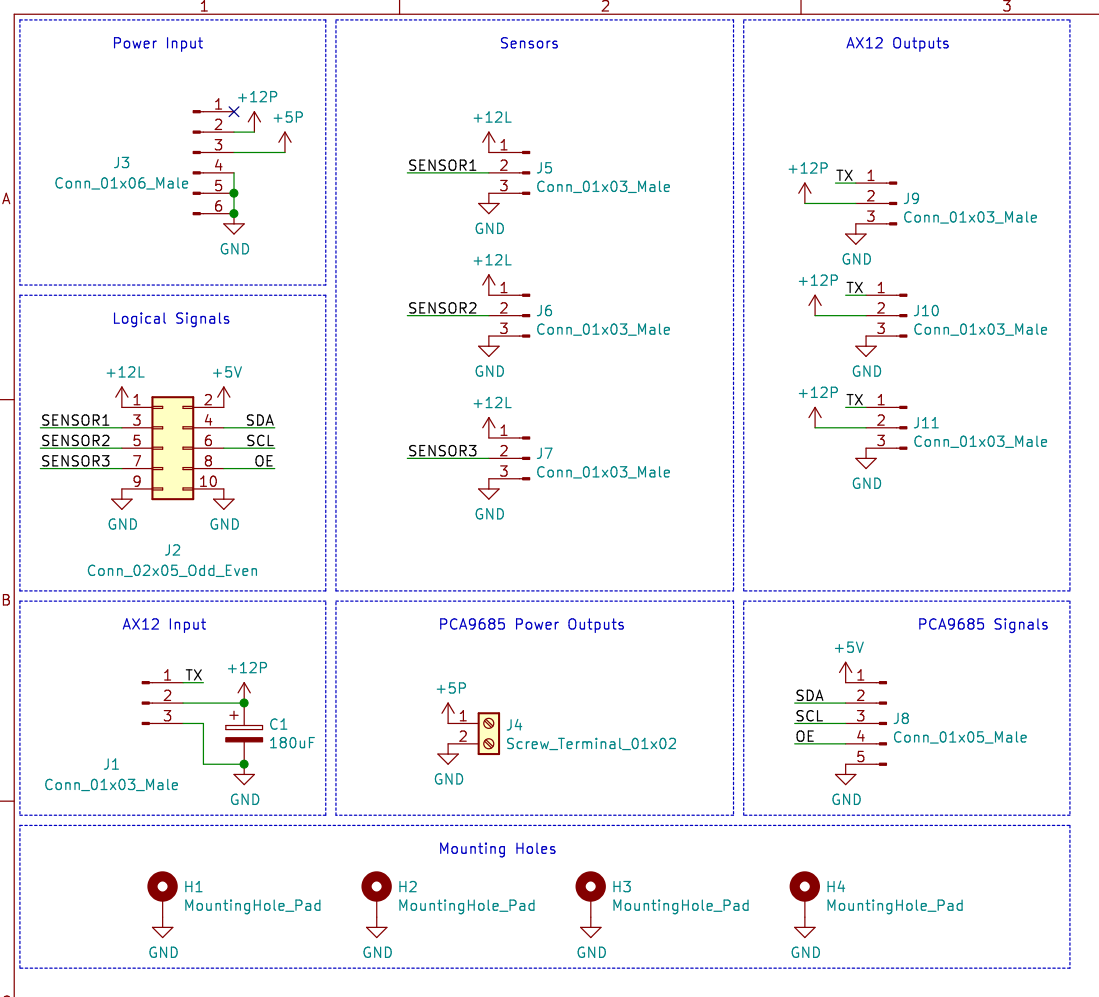
[picture p27: page 1]
