evolutek/carte-actionneurs/Carte Stepper V1/Output/Board-Back.pdf

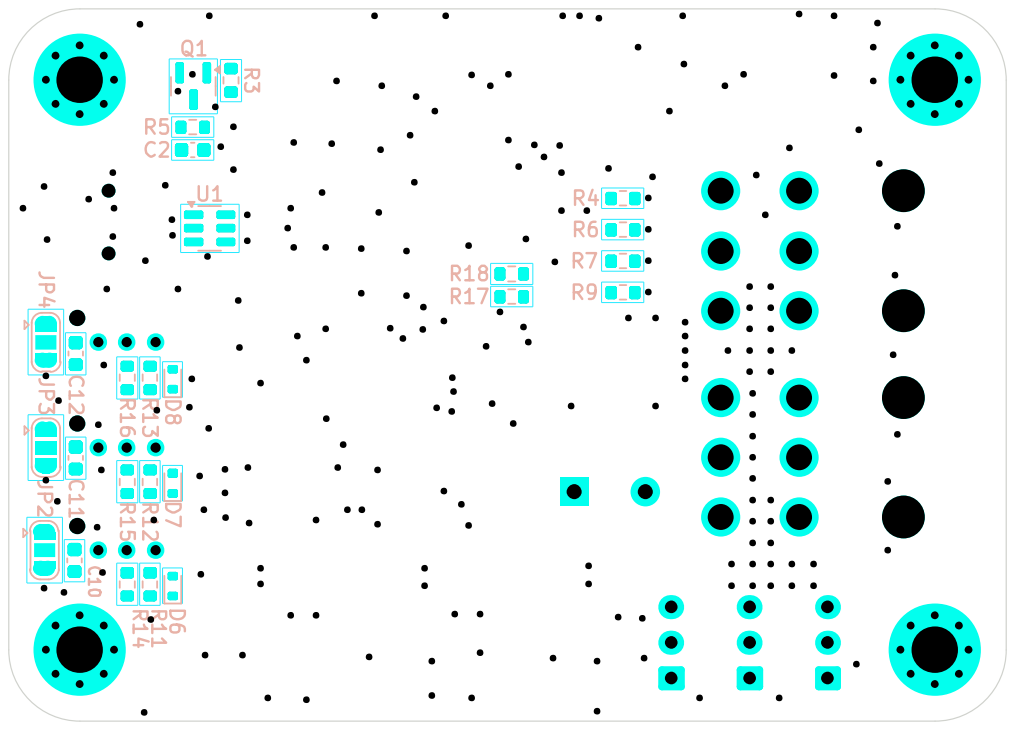
[picture p28: page 1]
