evolutek/carte-actionneurs/Carte Stepper V1/Output/Board-Front.pdf

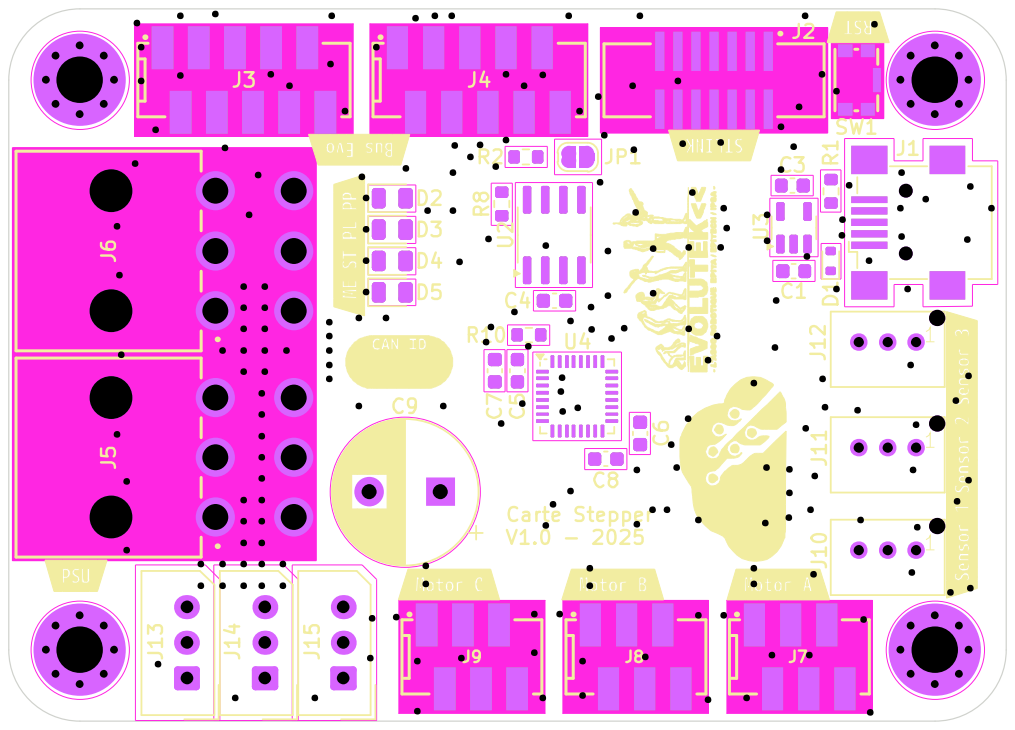
[picture p29: page 1]
