evolutek/carte-actionneurs/Hub Bus Actuators/Output/Board-Back.pdf

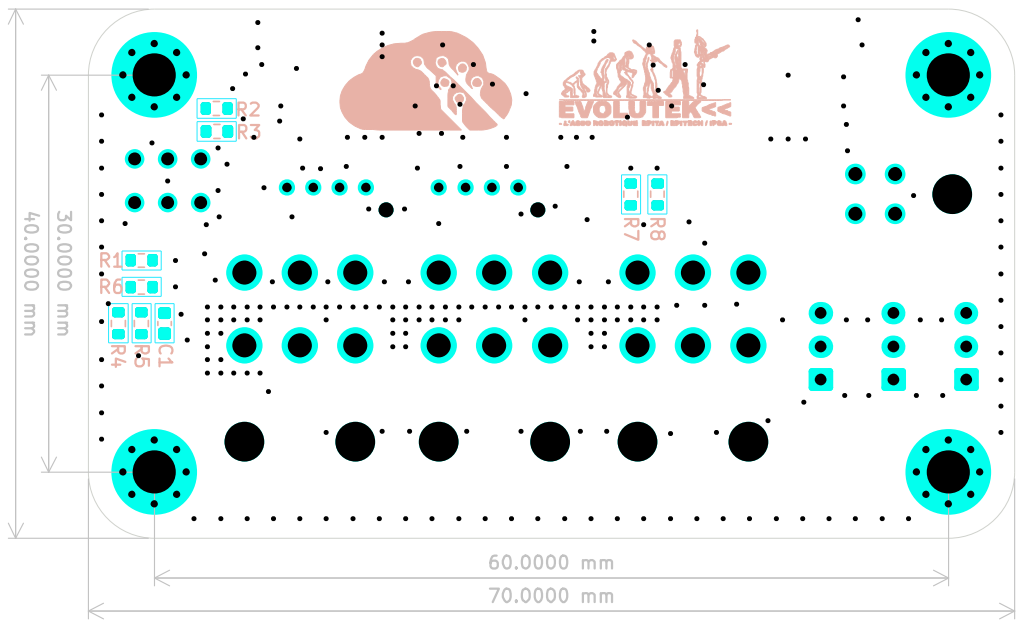
[picture p30: page 1]
