evolutek/carte-actionneurs/Hub Bus Actuators/Output/Board-Front.pdf

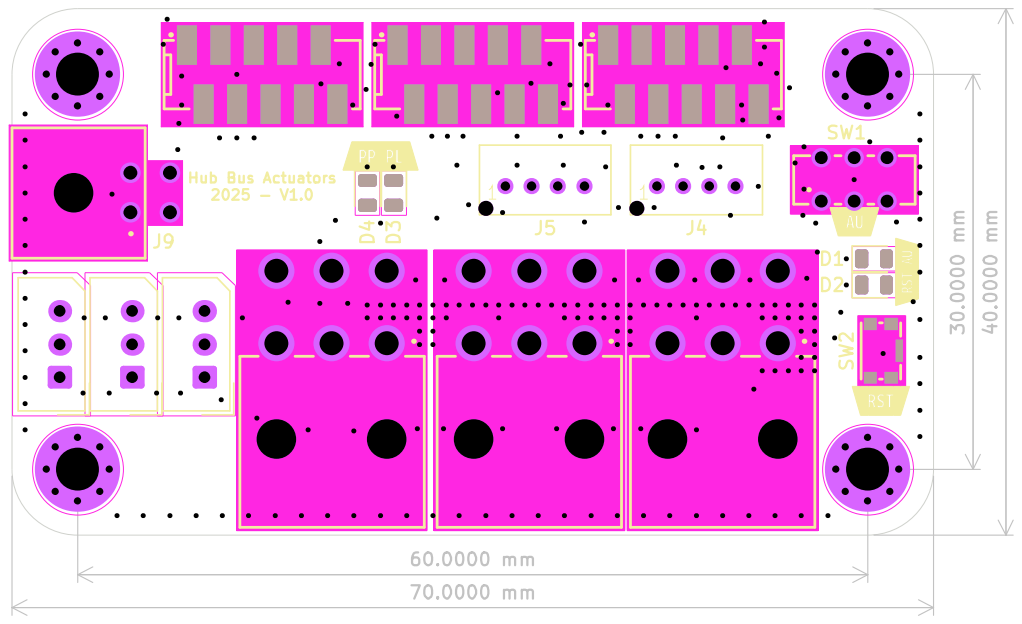
[picture p31: page 1]
