evolutek/carte-actionneurs/V3 - Bis/Output/Board-Back.pdf

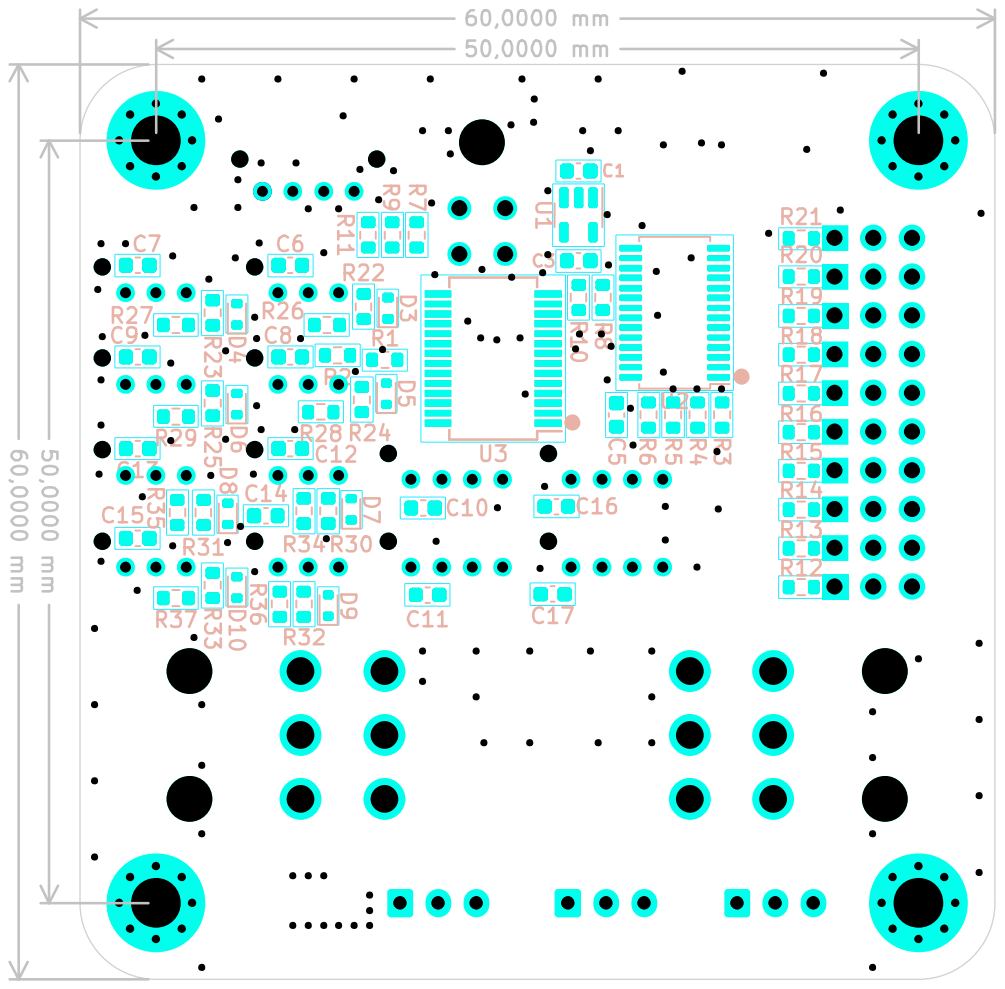
[picture p32: page 1]
