evolutek/carte-actionneurs/V3 - Bis/Output/Board-Front.pdf

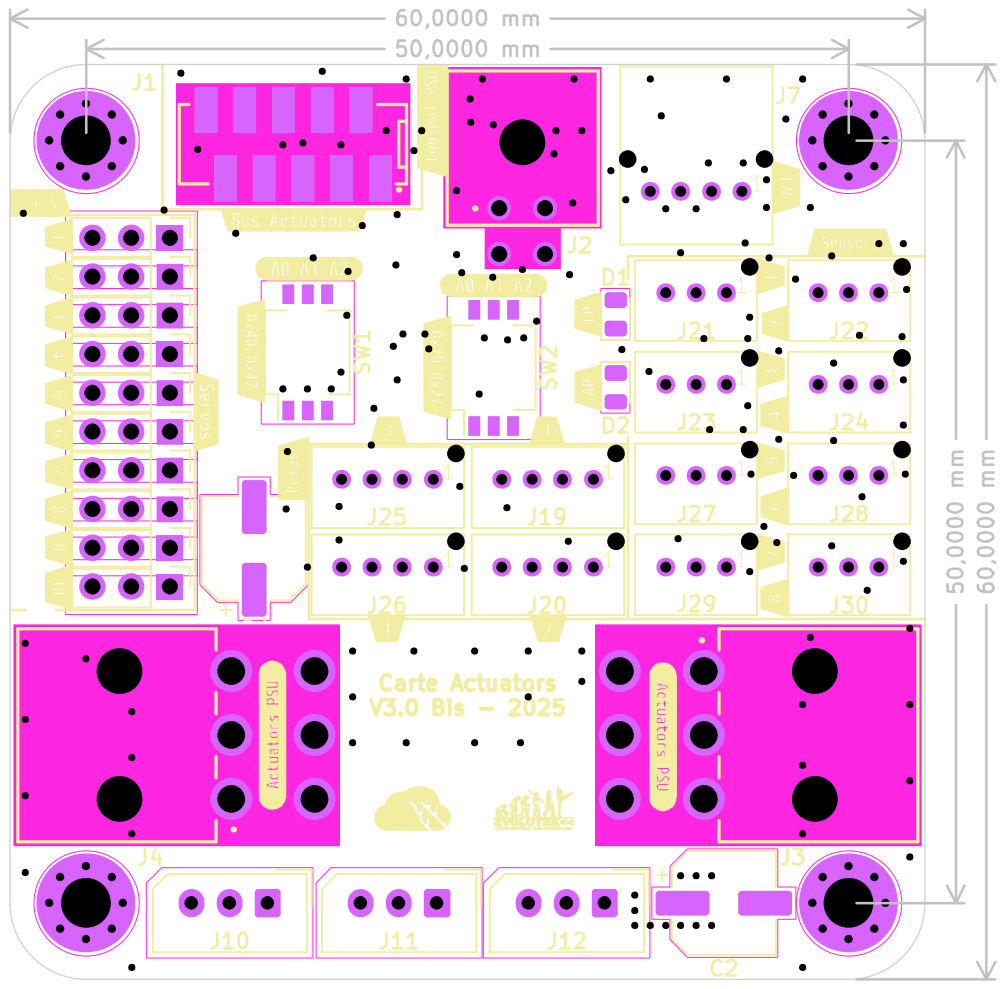
[picture p33: page 1]
