evolutek/carte-actionneurs/V3/Output/Board-Back.pdf

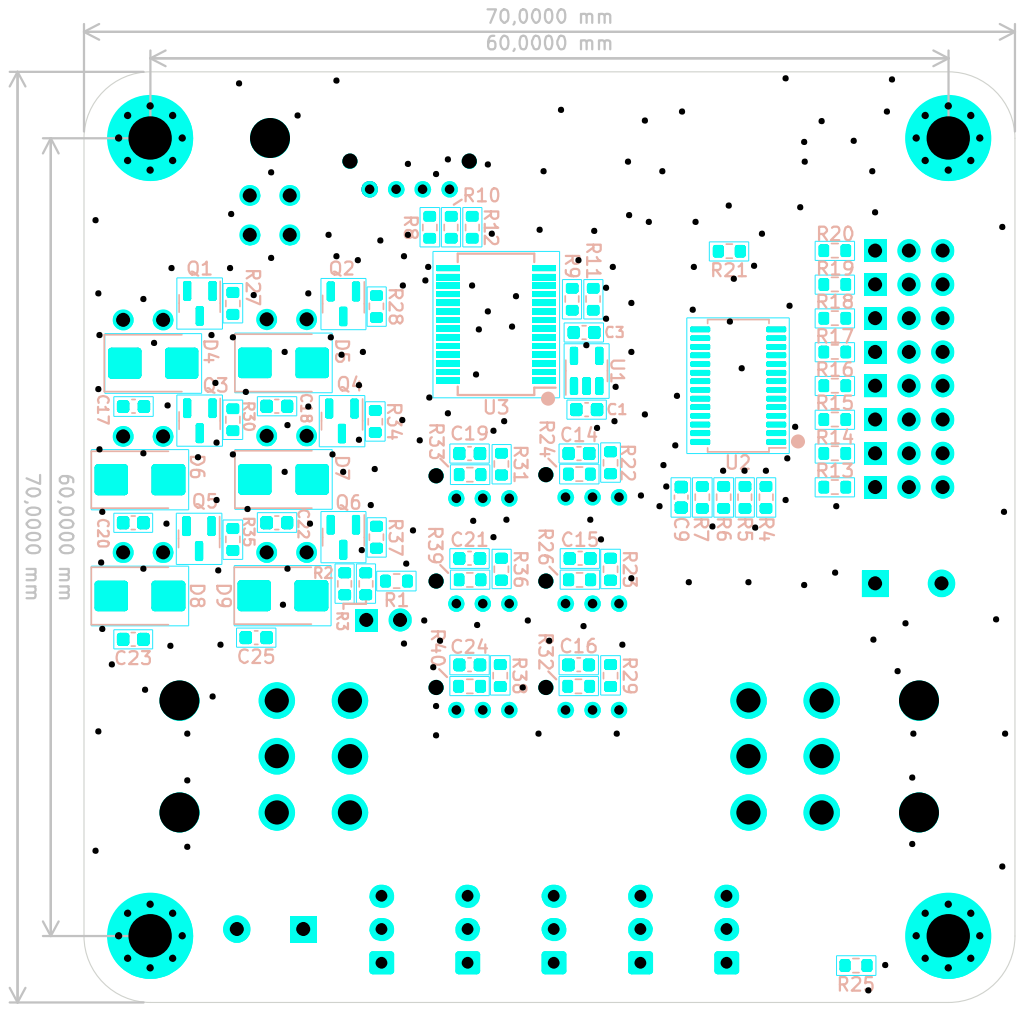
[picture p34: page 1]
