evolutek/carte-actionneurs/V3/Output/Board-Front.pdf

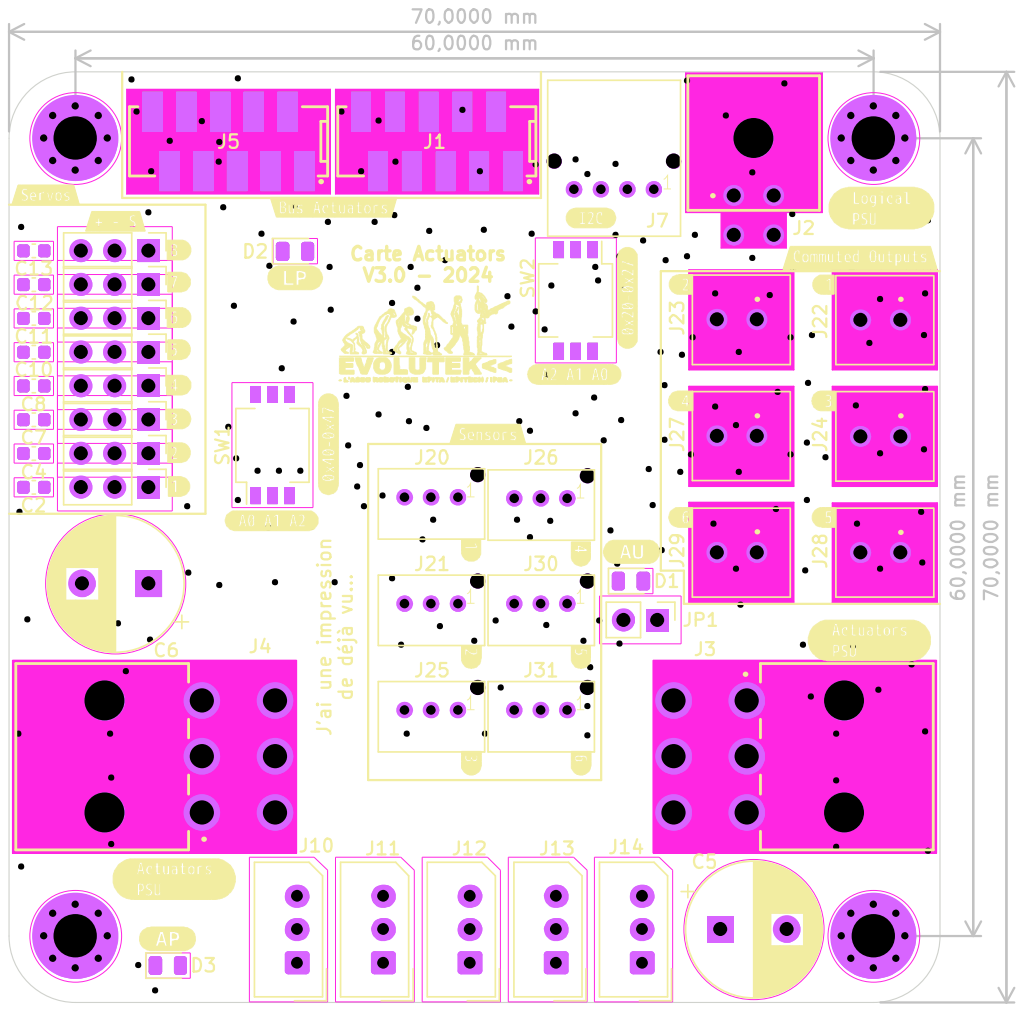
[picture p35: page 1]
