evolutek/carte-actionneurs/V2/Output/Board-Back.pdf

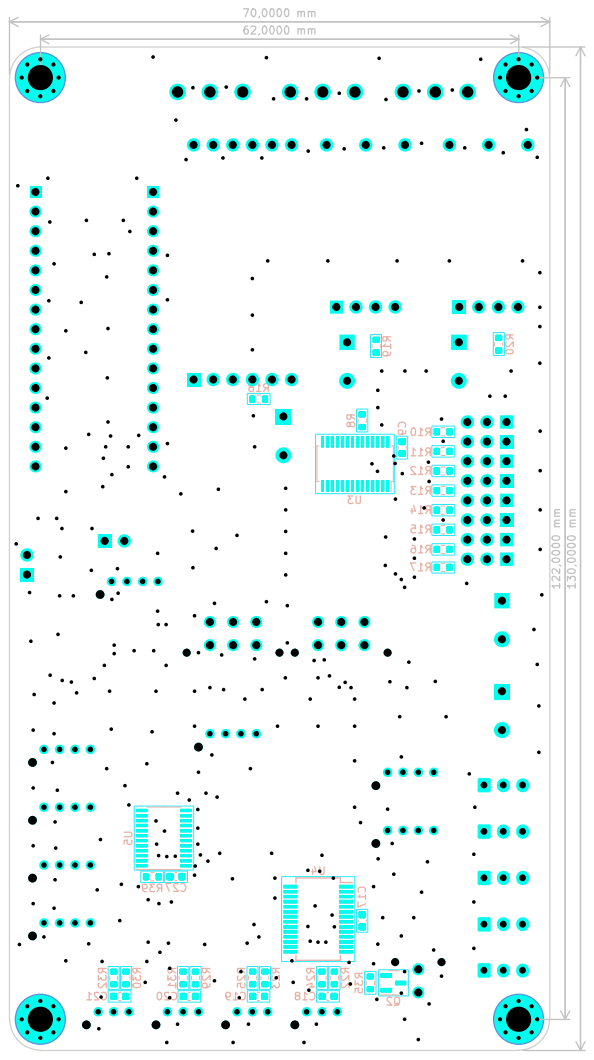
[picture p36: page 1]
