evolutek/carte-actionneurs/V2/Output/Board-Front.pdf

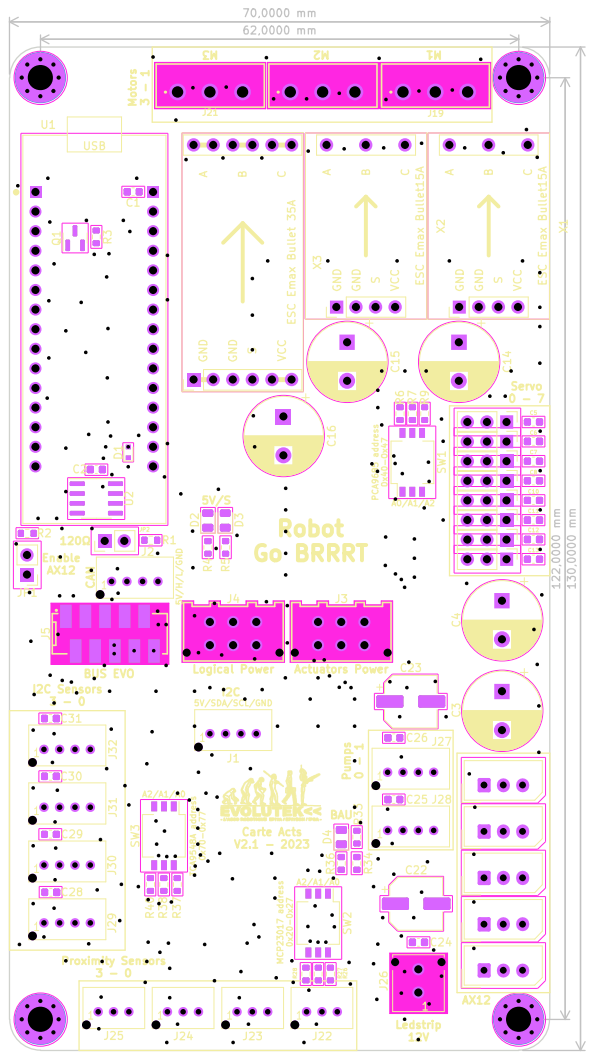
[picture p37: page 1]
