evolutek/carte-actionneurs/CarteRallongeActionneurs2022/Output/Board-Front.pdf

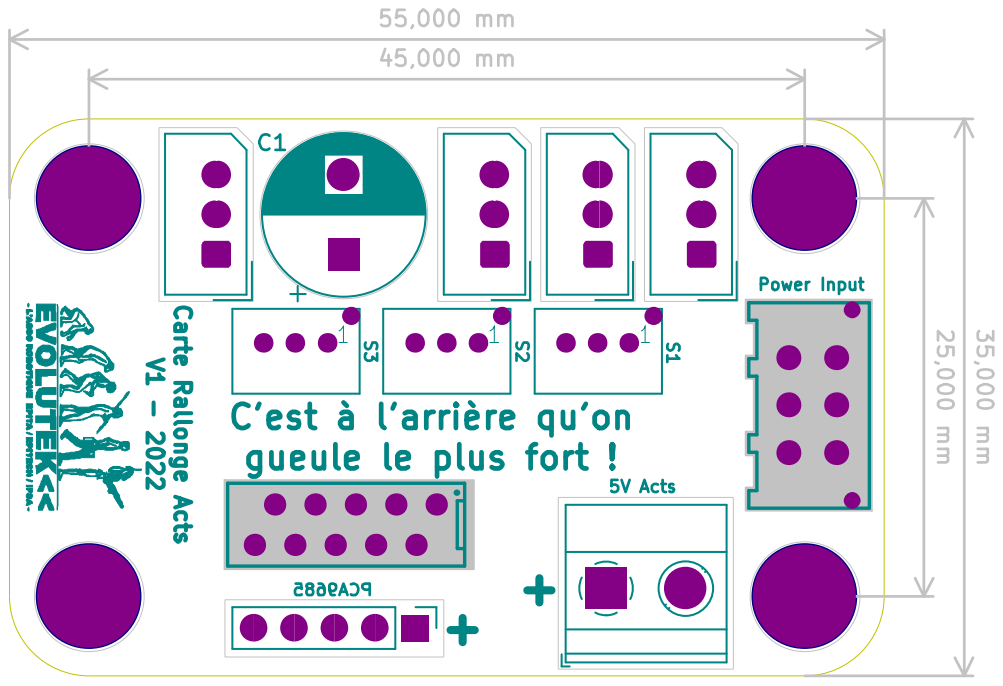
[picture p38: page 1]
