evolutek/carte-actionneurs/Constellations actionneurs/Hololutek 2026 - Repartiteur/Repartiteur.kicad_pcb

## KiCad design Constellations actionneurs/Hololutek 2026 - Repartiteur/Repartiteur.kicad_pcb (2026-05-03)

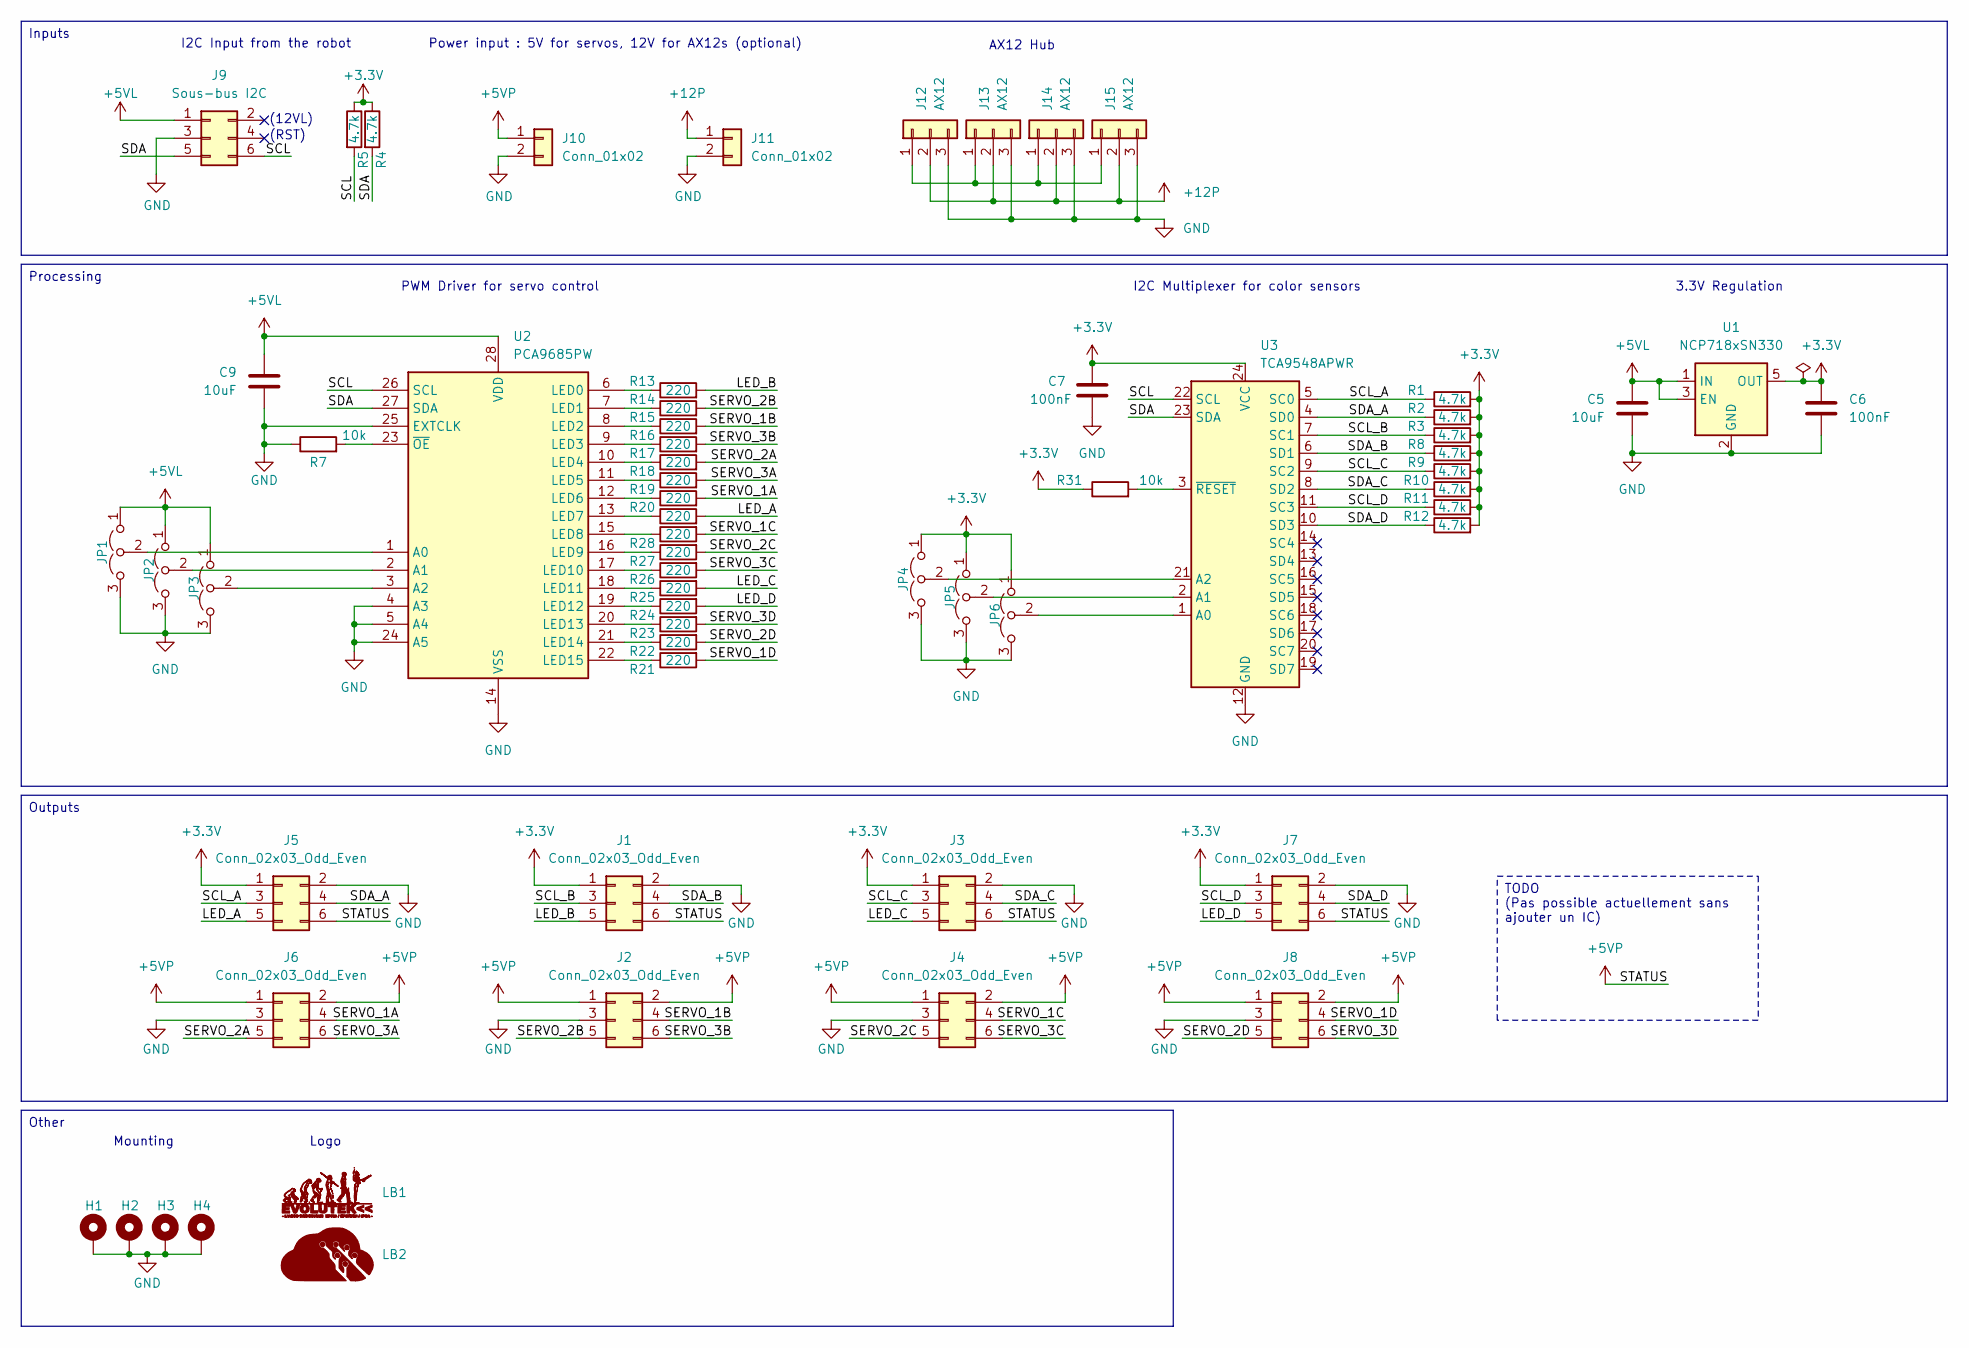
[picture p39: schematic Repartiteur.kicad_sch, Constellation - Répartiteur Hololutek 2026]

Parts:
C5, C9: 10uF; C_0603_1608Metric
C6, C7: 100nF; C_0603_1608Metric
H1, H2, H3, H4: MountingHole_Pad; MountingHole_3.2mm_M3_Pad_Via
J1, J2, J3, J4, J5, J6, J7, J8: Conn_02x03_Odd_Even; 690367280676
J9: Sous-bus I2C; 690367280676
J10, J11: Conn_01x02; 66200221122
J12, J13, J15: AX12; 22-03-5035
J14: AX12; 22-05-7035
JP1, JP2, JP3, JP4, JP5, JP6: Jumper_3_Bridged12; SolderJumper-3_P1.3mm_Open_RoundedPad1.0x1.5mm
LB1: LOGO; logo-evo-micro
LB2: LOGO; Logo Aisler Micro
R1, R2, R3, R4, R5, R8, R9, R10, R11, R12: 4.7k; R_0603_1608Metric
R7, R31: 10k; R_0603_1608Metric
R13, R14, R15, R16, R17, R18, R19, R20, R21, R22, R23, R24, R25, R26, R27, R28: 220; R_0603_1608Metric
U1: NCP718xSN330; SOT-23-5
U2: PCA9685PW; TSSOP-28_4.4x9.7mm_P0.65mm
U3: TCA9548APWR; TSSOP-24_4.4x7.8mm_P0.65mm

Connections:
+3.3V: C6.1, C7.1, J1.1, J3.1, J5.1, J7.1, JP4.1 (A), JP5.1 (A), JP6.1 (A), R1.2, R2.2, R3.2, R4.1, R5.1, R8.2, R9.2, R10.2, R11.2, R12.2, R31.1, U1.5 (OUT), U3.24 (VCC)
+5VL: C5.1, C9.2, J9.1, JP1.1 (A), JP2.1 (A), JP3.1 (A), U1.1 (IN), U1.3 (EN), U2.28 (VDD)
+5VP: J1.6, J2.1, J2.2, J3.6, J4.1, J4.2, J5.6, J6.1, J6.2, J7.6, J8.1, J8.2, J10.1
+12P: J11.1, J12.2, J13.2, J14.2, J15.2
/LED_A: J5.5, R20.2
/LED_B: J1.5, R13.2
/LED_C: J3.5, R25.2
/LED_D: J7.5, R24.2
/SCL: J9.6, R5.2, U2.26 (SCL), U3.22 (SCL)
/SCL_A: J5.3, R1.1, U3.5 (SC0)
/SCL_B: J1.3, R3.1, U3.7 (SC1)
/SCL_C: J3.3, R9.1, U3.9 (SC2)
/SCL_D: J7.3, R11.1, U3.11 (SC3)
/SDA: J9.5, R4.2, U2.27 (SDA), U3.23 (SDA)
/SDA_A: J5.4, R2.1, U3.4 (SD0)
/SDA_B: J1.4, R8.1, U3.6 (SD1)
/SDA_C: J3.4, R10.1, U3.8 (SD2)
/SDA_D: J7.4, R12.1, U3.10 (SD3)
/SERVO_1A: J6.4, R19.2
/SERVO_1B: J2.4, R15.2
/SERVO_1C: J4.4, R28.2
/SERVO_1D: J8.4, R21.2
/SERVO_2A: J6.5, R17.2
/SERVO_2B: J2.5, R14.2
/SERVO_2C: J4.5, R27.2
/SERVO_2D: J8.5, R22.2
/SERVO_3A: J6.6, R18.2
/SERVO_3B: J2.6, R16.2
/SERVO_3C: J4.6, R26.2
/SERVO_3D: J8.6, R23.2
GND: C5.2, C6.2, C7.2, C9.1, H1.1, H2.1, H3.1, H4.1, J1.2, J2.3, J3.2, J4.3, J5.2, J6.3, J7.2, J8.3, J9.3, J10.2, J11.2, J12.3, J13.3, J14.3, J15.3, JP1.3 (B), JP2.3 (B), JP3.3 (B), JP4.3 (B), JP5.3 (B), JP6.3 (B), R7.1, U1.2 (GND), U2.4 (A3), U2.5 (A4), U2.14 (VSS), U2.24 (A5), U2.25 (EXTCLK), U3.12 (GND)
unnamed: J12.1, J13.1, J14.1, J15.1
unnamed: JP1.2 (C), U2.1 (A0)
unnamed: JP2.2 (C), U2.2 (A1)
unnamed: JP3.2 (C), U2.3 (A2)
unnamed: JP4.2 (C), U3.21 (A2)
unnamed: JP5.2 (C), U3.2 (A1)
unnamed: JP6.2 (C), U3.1 (A0)
unnamed: R13.1, U2.6 (LED0)
unnamed: R14.1, U2.7 (LED1)
unnamed: R15.1, U2.8 (LED2)
unnamed: R16.1, U2.9 (LED3)
unnamed: R17.1, U2.10 (LED4)
unnamed: R18.1, U2.11 (LED5)
unnamed: R19.1, U2.12 (LED6)
unnamed: R20.1, U2.13 (LED7)
unnamed: R28.1, U2.15 (LED8)
unnamed: R27.1, U2.16 (LED9)
unnamed: R26.1, U2.17 (LED10)
unnamed: R25.1, U2.18 (LED11)
unnamed: R24.1, U2.19 (LED12)
unnamed: R23.1, U2.20 (LED13)
unnamed: R22.1, U2.21 (LED14)
unnamed: R21.1, U2.22 (LED15)
unnamed: R7.2, U2.23 (~OE)
unnamed: R31.2, U3.3 (~RESET)

Notes on the sheet:
(12VL)
(RST)
Power input : 5V for servos, 12V for AX12s (optional)
PWM Driver for servo control
AX12 Hub
I2C Multiplexer for color sensors
Logo
I2C Input from the robot
Mounting
3.3V Regulation
Other
TODO (Pas possible actuellement sans ajouter un IC)
Outputs
Processing
Inputs

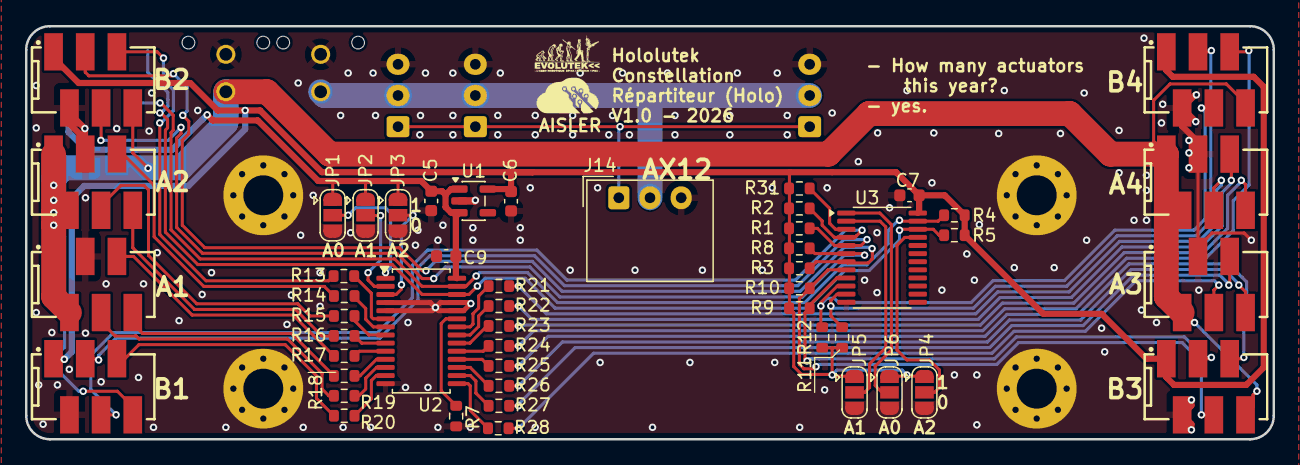
[picture p40: board Repartiteur.kicad_pcb from above]

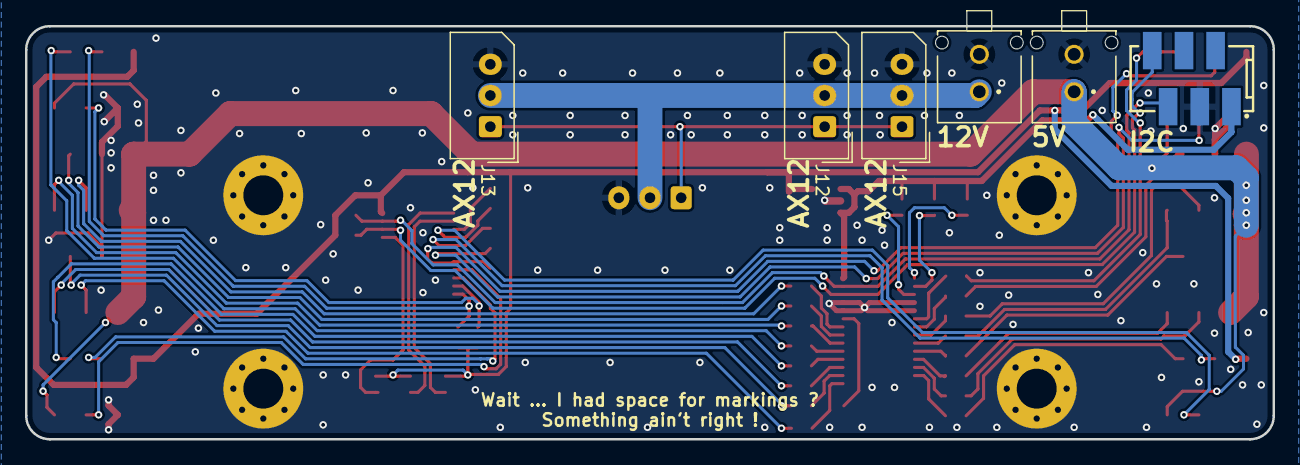
[picture p41: board Repartiteur.kicad_pcb from below]

Board: 2 copper layers, 100.0 x 33.1 mm, 62 parts (6 on the bottom side), 56 nets.
