evolutek/carte-actionneurs/Constellations actionneurs/Hololutek 2026 - Doigts/Doigts.kicad_pcb

## KiCad design Constellations actionneurs/Hololutek 2026 - Doigts/Doigts.kicad_pcb (2026-05-03)

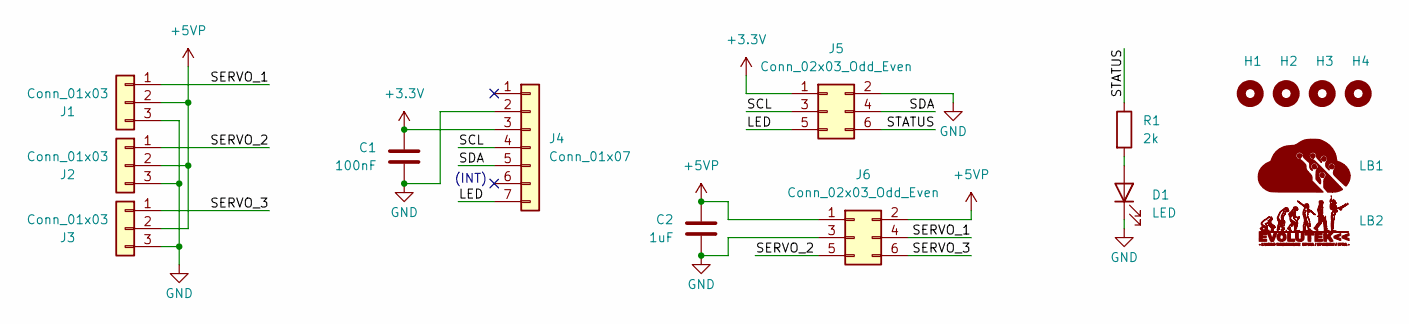
[picture p42: schematic Doigts.kicad_sch, Constellation - Doigts Hololutek 2026]

Parts:
C1: 100nF; C_0603_1608Metric
C2: 1uF; C_0603_1608Metric
D1: LED; LED_0805_2012Metric
H1, H2, H3, H4: MountingHole_Pad; MountingHole_3.2mm_M3
J1, J2, J3: Conn_01x03; 22-03-5035
J4: Conn_01x07; PinSocket_1x07_P2.54mm_Vertical
J5, J6: Conn_02x03_Odd_Even; 690367280676
LB1: LOGO; Logo Aisler Micro
LB2: LOGO; logo-evo-micro
R1: 2k; R_0603_1608Metric

Connections:
+3.3V: C1.1, J4.3, J5.1
+5VP: C2.1, J1.2, J2.2, J3.2, J6.1, J6.2
/LED: J4.7, J5.5
/SCL: J4.4, J5.3
/SDA: J4.5, J5.4
/SERVO_1: J1.1, J6.4
/SERVO_2: J2.1, J6.5
/SERVO_3: J3.1, J6.6
/STATUS: J5.6, R1.1
GND: C1.2, C2.2, D1.1 (K), J1.3, J2.3, J3.3, J4.2, J5.2, J6.3
unnamed: D1.2 (A), R1.2

Notes on the sheet:
(INT)

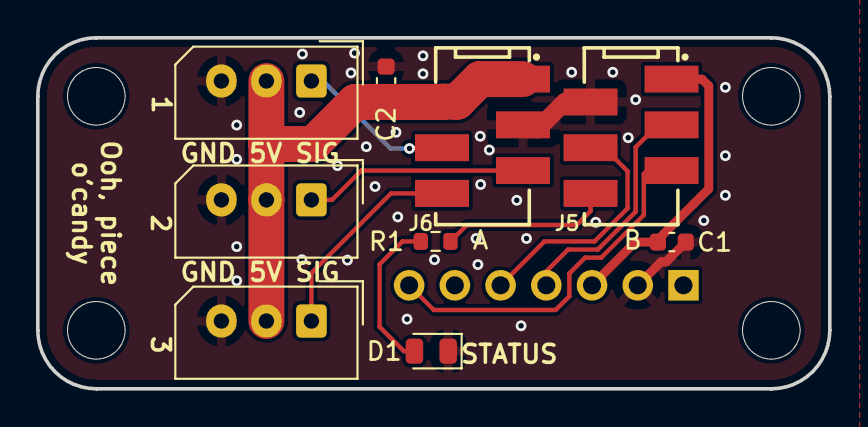
[picture p43: board Doigts.kicad_pcb from above]

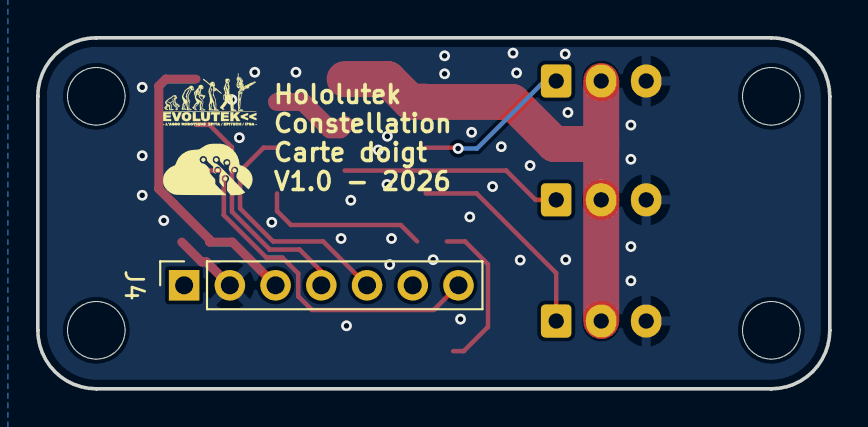
[picture p44: board Doigts.kicad_pcb from below]

Board: 2 copper layers, 44.0 x 19.5 mm, 16 parts (3 on the bottom side), 11 nets.
