evolutek/carte-actionneurs/Carte ADC/carte-adc.kicad_pcb

## KiCad design Carte ADC/carte-adc.kicad_pcb (2025-06-11)

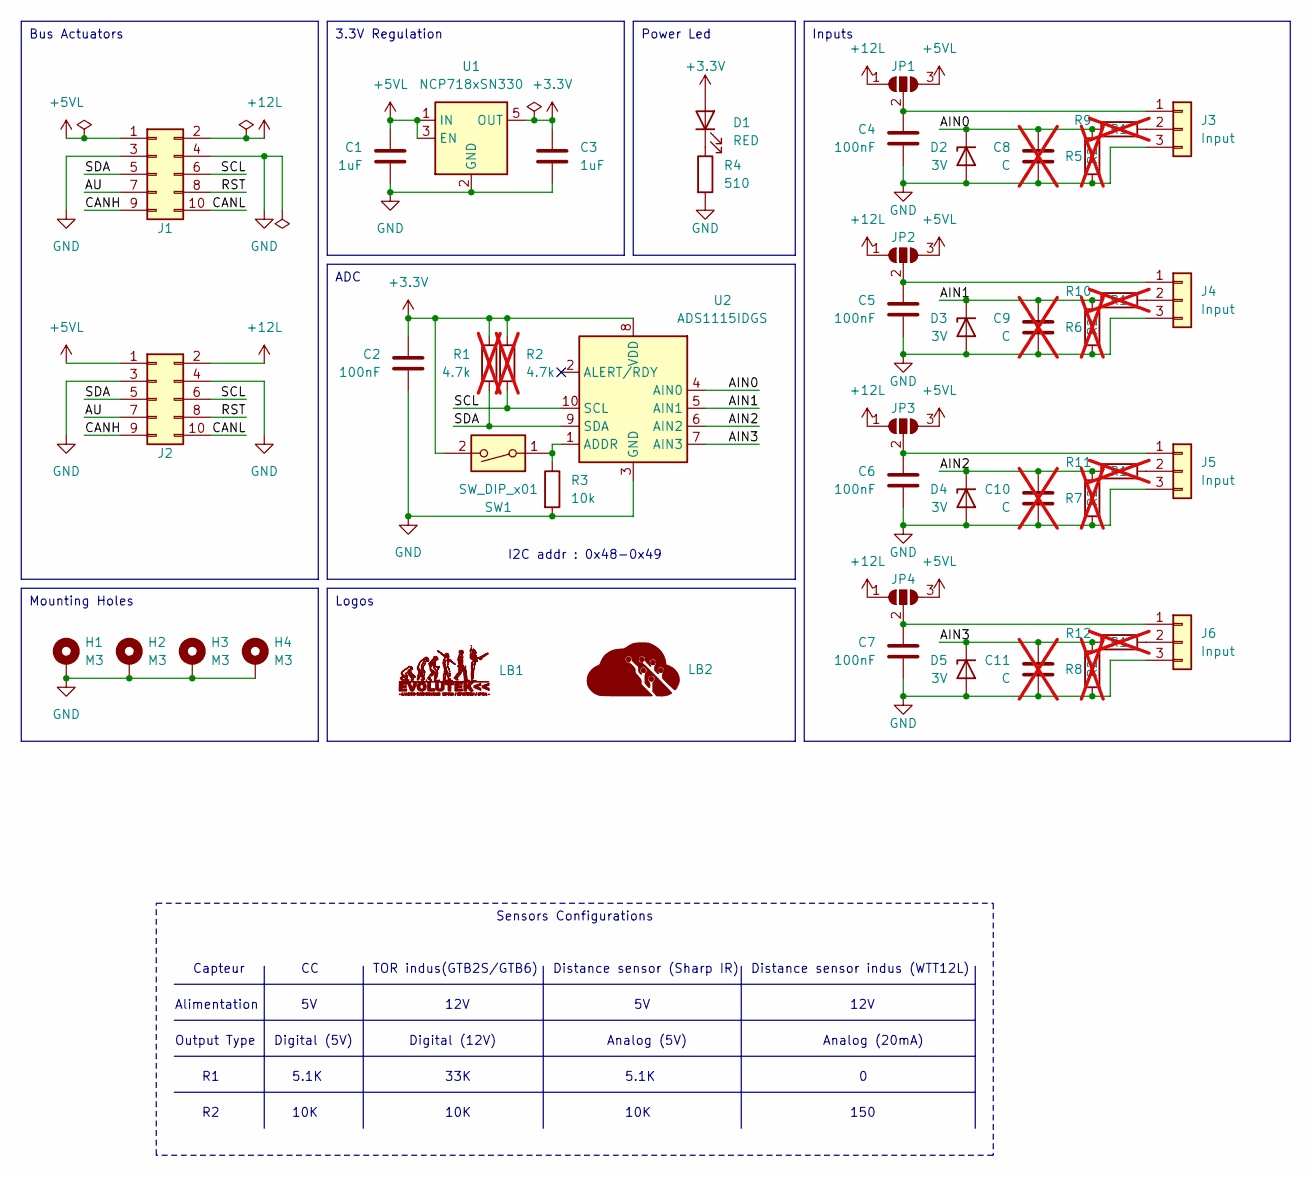
[picture p45: schematic carte-adc.kicad_sch, Carte ADC]

Parts:
C1, C3: 1uF; C_0603_1608Metric
C2, C4, C5, C6, C7: 100nF; C_0603_1608Metric
C8, C9, C10, C11: C; C_0603_1608Metric; not fitted
D1: RED; LED_0805_2012Metric
D2, D3, D4, D5: 3V; D_SOD-523
H1, H2, H3, H4: M3; MountingHole_3.2mm_M3_Pad_Via
J1, J2: Bus Evo; 690367281076
J3, J4, J5, J6: Input; B03B-PASK
JP1, JP2, JP3, JP4: SolderJumper_3_Open; SolderJumper-3_P1.3mm_Open_RoundedPad1.0x1.5mm
LB1: LOGO; logo-evo-min
LB2: LOGO; Logo Aisler Min
R1, R2: 4.7k; R_0603_1608Metric; not fitted
R3: 10k; R_0603_1608Metric
R4: 510; R_0603_1608Metric
R5, R6, R7, R8: R2; R_0603_1608Metric; not fitted
R9, R10, R11, R12: R1; R_0603_1608Metric; not fitted
SW1: SW_DIP_x01; SW_DIP_SPSTx01_Slide_6.7x4.1mm_W7.62mm_P2.54mm_LowProfile
U1: NCP718xSN330; SOT-23-5
U2: ADS1115IDGS; TSSOP-10_3x3mm_P0.5mm

Connections:
+3.3V: C2.1, C3.1, D1.2 (A), R1.1, R2.1, SW1.2, U1.5 (OUT), U2.8 (VDD)
+5VL: C1.1, J1.1, J2.1, JP1.3 (B), JP2.3 (B), JP3.3 (B), JP4.3 (B), U1.1 (IN), U1.3 (EN)
+12L: J1.2, J2.2, JP1.1 (A), JP2.1 (A), JP3.1 (A), JP4.1 (A)
/AIN0: C8.1, D2.1 (K), R5.1, R9.1, U2.4 (AIN0)
/AIN1: C9.1, D3.1 (K), R6.1, R10.1, U2.5 (AIN1)
/AIN2: C10.1, D4.1 (K), R7.1, R11.1, U2.6 (AIN2)
/AIN3: C11.1, D5.1 (K), R8.1, R12.1, U2.7 (AIN3)
/AU: J1.7, J2.7
/CANH: J1.9, J2.9
/CANL: J1.10, J2.10
/RST: J1.8, J2.8
/SCL: J1.6, J2.6, R2.2, U2.10 (SCL)
/SDA: J1.5, J2.5, R1.2, U2.9 (SDA)
GND: C1.2, C2.2, C3.2, C4.2, C5.2, C6.2, C7.2, C8.2, C9.2, C10.2, C11.2, D2.2 (A), D3.2 (A), D4.2 (A), D5.2 (A), H1.1, H2.1, H3.1, H4.1, J1.3, J1.4, J2.3, J2.4, J3.3, J4.3, J5.3, J6.3, R3.2, R4.2, R5.2, R6.2, R7.2, R8.2, U1.2 (GND), U2.3 (GND)
unnamed: D1.1 (K), R4.1
unnamed: C4.1, J3.1, JP1.2 (C)
unnamed: J3.2, R9.2
unnamed: C5.1, J4.1, JP2.2 (C)
unnamed: J4.2, R10.2
unnamed: C6.1, J5.1, JP3.2 (C)
unnamed: J5.2, R11.2
unnamed: C7.1, J6.1, JP4.2 (C)
unnamed: J6.2, R12.2
unnamed: R3.1, SW1.1, U2.1 (ADDR)

Notes on the sheet:
Sensors Configurations
Bus Actuators
ADC
Mounting Holes
Power Led
3.3V Regulation
Logos
Inputs
I2C addr : 0x48-0x49
Analog (20mA)
Alimentation
12V
Analog (5V)
Distance sensor indus (WTT12L)
33K
10K
Digital (5V)
Digital (12V)
TOR indus(GTB2S/GTB6)
5.1K
Capteur
150
Output Type
Distance sensor (Sharp IR)

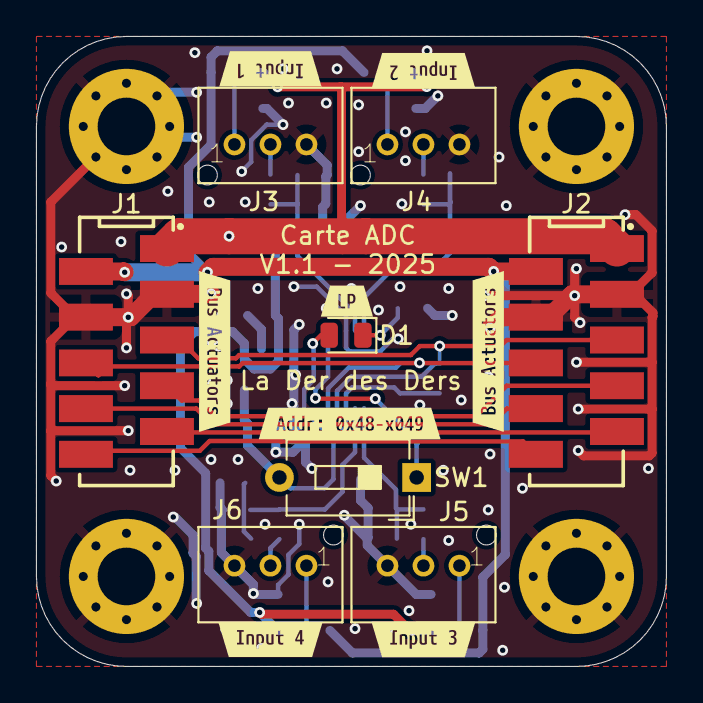
[picture p46: board carte-adc.kicad_pcb from above]

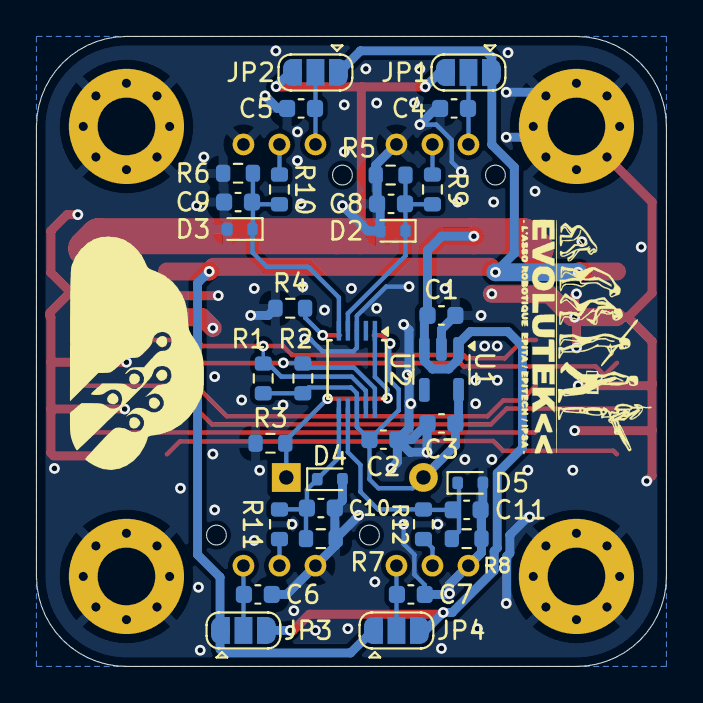
[picture p47: board carte-adc.kicad_pcb from below]

Board: 2 copper layers, 35.0 x 35.0 mm, 55 parts (35 on the bottom side), 24 nets.

Other parts of the board:
kibuzzard-682DD3F9: G***; kibuzzard-682DD3F9
kibuzzard-682DD3FF: G***; kibuzzard-682DD3FF
kibuzzard-682DD415: G***; kibuzzard-682DD415
kibuzzard-682DD421: G***; kibuzzard-682DD421
kibuzzard-682DD448, kibuzzard-682DD448#2: G***; kibuzzard-682DD448
kibuzzard-682DD483: G***; kibuzzard-682DD483
kibuzzard-682DD754: G***; kibuzzard-682DD754
