evolutek/carte-actionneurs/Carte Stepper V1/carte-stepper.kicad_pcb

## KiCad design Carte Stepper V1/carte-stepper.kicad_pcb (2025-05-21)

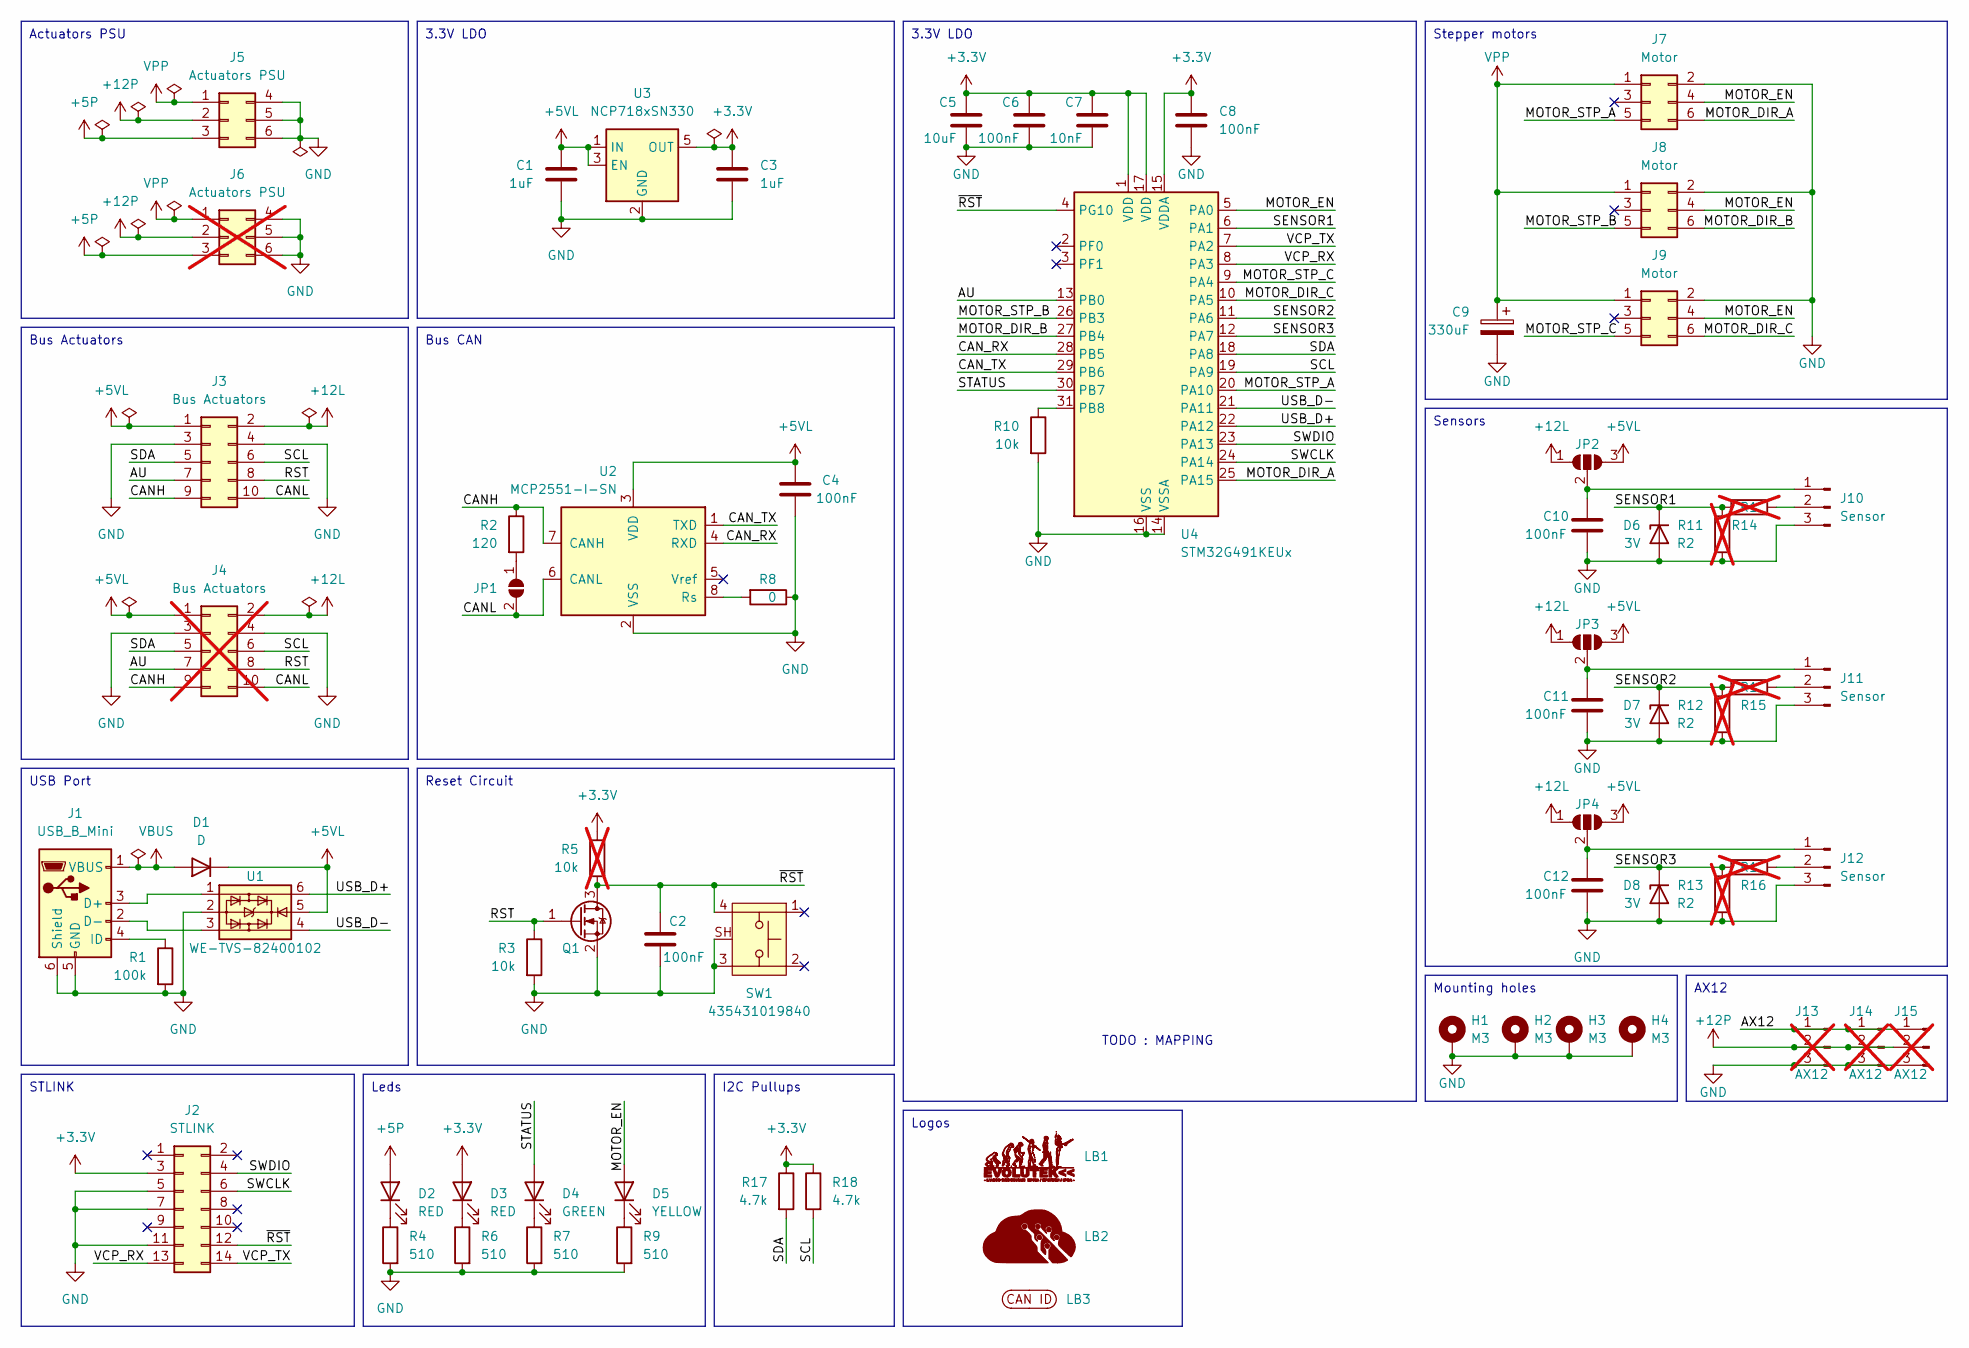
[picture p48: schematic carte-stepper.kicad_sch, Carte Stepper]

Parts:
C1, C3: 1uF; C_0603_1608Metric
C2, C4, C6, C8, C10, C11, C12: 100nF; C_0603_1608Metric
C5: 10uF; C_0603_1608Metric
C7: 10nF; C_0603_1608Metric
C9: 330uF; CP_Radial_D10.0mm_P5.00mm
D1: D; D_SOD-523
D2, D3: RED; LED_0805_2012Metric
D4: GREEN; LED_0805_2012Metric
D5: YELLOW; LED_0805_2012Metric
D6, D7, D8: 3V; D_SOD-523
H1, H2, H3, H4: M3; MountingHole_3.2mm_M3_Pad_Via
J1: USB_B_Mini; USB_Mini-B_Wuerth_65100516121_Horizontal
J2: STLINK; 62701420621
J3: Bus Actuators; 690367281076
J4: Bus Actuators; 690367281076; not fitted
J5: Actuators PSU; 649006227222
J6: Actuators PSU; 649006227222; not fitted
J7, J8, J9: Motor; 690367280676
J10, J11, J12: Sensor; B03B-PASK
J13, J14, J15: AX12; 22-03-5035; not fitted
JP1: SolderJumper_2_Open; SolderJumper-2_P1.3mm_Open_RoundedPad1.0x1.5mm
JP2, JP3, JP4: SolderJumper_3_Open; SolderJumper-3_P1.3mm_Open_RoundedPad1.0x1.5mm
LB1: LOGO; logo-evo-min
LB2: LOGO; Logo Aisler Min
LB3: CAN ID Label 2
Q1: Q_NMOS_GSD; SOT-23
R1: 100k; R_0603_1608Metric
R2: 120; R_0603_1608Metric
R3, R10: 10k; R_0603_1608Metric
R4, R6, R7, R9: 510; R_0603_1608Metric
R5: 10k; R_0603_1608Metric; not fitted
R8: 0; R_0603_1608Metric
R11, R12, R13: R2; R_0603_1608Metric; not fitted
R14, R15, R16: R1; R_0603_1608Metric; not fitted
R17, R18: 4.7k; R_0603_1608Metric
SW1: 435431019840
U1: WE-TVS-82400102; SOT-23-6
U2: MCP2551-I-SN; SOIC-8_3.9x4.9mm_P1.27mm
U3: NCP718xSN330; SOT-23-5
U4: STM32G491KEUx; QFN-32-1EP_5x5mm_P0.5mm_EP3.45x3.45mm-Without thermal pad

Connections:
+3.3V: C3.1, C5.1, C6.1, C7.1, C8.1, D3.2 (A), J2.3, R5.1, R17.1, R18.1, U3.5 (OUT), U4.1 (VDD), U4.15 (VDDA), U4.17 (VDD)
+5P: D2.2 (A), J5.3, J6.3
+5VL: C1.1, C4.1, D1.1 (K), J3.1, J4.1, JP2.3 (B), JP3.3 (B), JP4.3 (B), U1.5, U2.3 (VDD), U3.1 (IN), U3.3 (EN)
+12L: J3.2, J4.2, JP2.1 (A), JP3.1 (A), JP4.1 (A)
+12P: J5.2, J6.2, J13.2, J14.2, J15.2
/AU: J3.7, J4.7, U4.13 (PB0)
/AX12: J13.1, J14.1, J15.1
/CANH: J3.9, J4.9, R2.1, U2.7 (CANH)
/CANL: J3.10, J4.10, JP1.2 (B), U2.6 (CANL)
/CAN_RX: U2.4 (RXD), U4.28 (PB5)
/CAN_TX: U2.1 (TXD), U4.29 (PB6)
/MOTOR_DIR_A: J7.6, U4.25 (PA15)
/MOTOR_DIR_B: J8.6, U4.27 (PB4)
/MOTOR_DIR_C: J9.6, U4.10 (PA5)
/MOTOR_EN: D5.2 (A), J7.4, J8.4, J9.4, U4.5 (PA0)
/MOTOR_STP_A: J7.5, U4.20 (PA10)
/MOTOR_STP_B: J8.5, U4.26 (PB3)
/MOTOR_STP_C: J9.5, U4.9 (PA4)
/RST: J3.8, J4.8, Q1.1 (G), R3.1
/SCL: J3.6, J4.6, R18.2, U4.19 (PA9)
/SDA: J3.5, J4.5, R17.2, U4.18 (PA8)
/SENSOR1: D6.1 (K), R11.1, R14.2, U4.6 (PA1)
/SENSOR2: D7.1 (K), R12.1, R15.2, U4.11 (PA6)
/SENSOR3: D8.1 (K), R13.1, R16.2, U4.12 (PA7)
/STATUS: D4.2 (A), U4.30 (PB7)
/SWCLK: J2.6, U4.24 (PA14)
/SWDIO: J2.4, U4.23 (PA13)
/USB_D+: U1.6, U4.22 (PA12)
/USB_D-: U1.4, U4.21 (PA11)
/VCP_RX: J2.13, U4.8 (PA3)
/VCP_TX: J2.14, U4.7 (PA2)
/~RST: C2.1, J2.12, Q1.3 (D), R5.2, SW1.4, U4.4 (PG10)
GND: C1.2, C2.2, C3.2, C4.2, C5.2, C6.2, C7.2, C8.2, C9.2, C10.2, C11.2, C12.2, D6.2 (A), D7.2 (A), D8.2 (A), H1.1, H2.1, H3.1, H4.1, J1.5 (GND), J1.6 (Shield), J2.5, J2.7, J2.11, J3.3, J3.4, J4.3, J4.4, J5.4, J5.5, J5.6, J6.4, J6.5, J6.6, J7.2, J8.2, J9.2, J10.3, J11.3, J12.3, J13.3, J14.3, J15.3, Q1.2 (S), R1.2, R3.2, R4.2, R6.2, R7.2, R8.1, R9.2, R10.2, R11.2, R12.2, R13.2, SW1.3, SW1.SH, U1.2, U2.2 (VSS), U3.2 (GND), U4.14 (VSSA), U4.16 (VSS), U4.32 (VSS)
unnamed: D2.1 (K), R4.1
unnamed: D3.1 (K), R6.1
unnamed: D4.1 (K), R7.1
unnamed: D5.1 (K), R9.1
unnamed: J1.3 (D+), U1.1
unnamed: J1.2 (D-), U1.3
unnamed: J1.4 (ID), R1.1
unnamed: C10.1, J10.1, JP2.2 (C)
unnamed: J10.2, R14.1
unnamed: C11.1, J11.1, JP3.2 (C)
unnamed: J11.2, R15.1
unnamed: C12.1, J12.1, JP4.2 (C)
unnamed: J12.2, R16.1
unnamed: JP1.1 (A), R2.2
unnamed: R8.2, U2.8 (Rs)
unnamed: R10.1, U4.31 (PB8)
VBUS: D1.2 (A), J1.1 (VBUS)
VPP: C9.1, J5.1, J6.1, J7.1, J8.1, J9.1

Notes on the sheet:
USB Port
Leds
Reset Circuit
Logos
Sensors
I2C Pullups
AX12
3.3V LDO
Bus CAN
STLINK
Mounting holes
Stepper motors
Actuators PSU
Bus Actuators
TODO : MAPPING

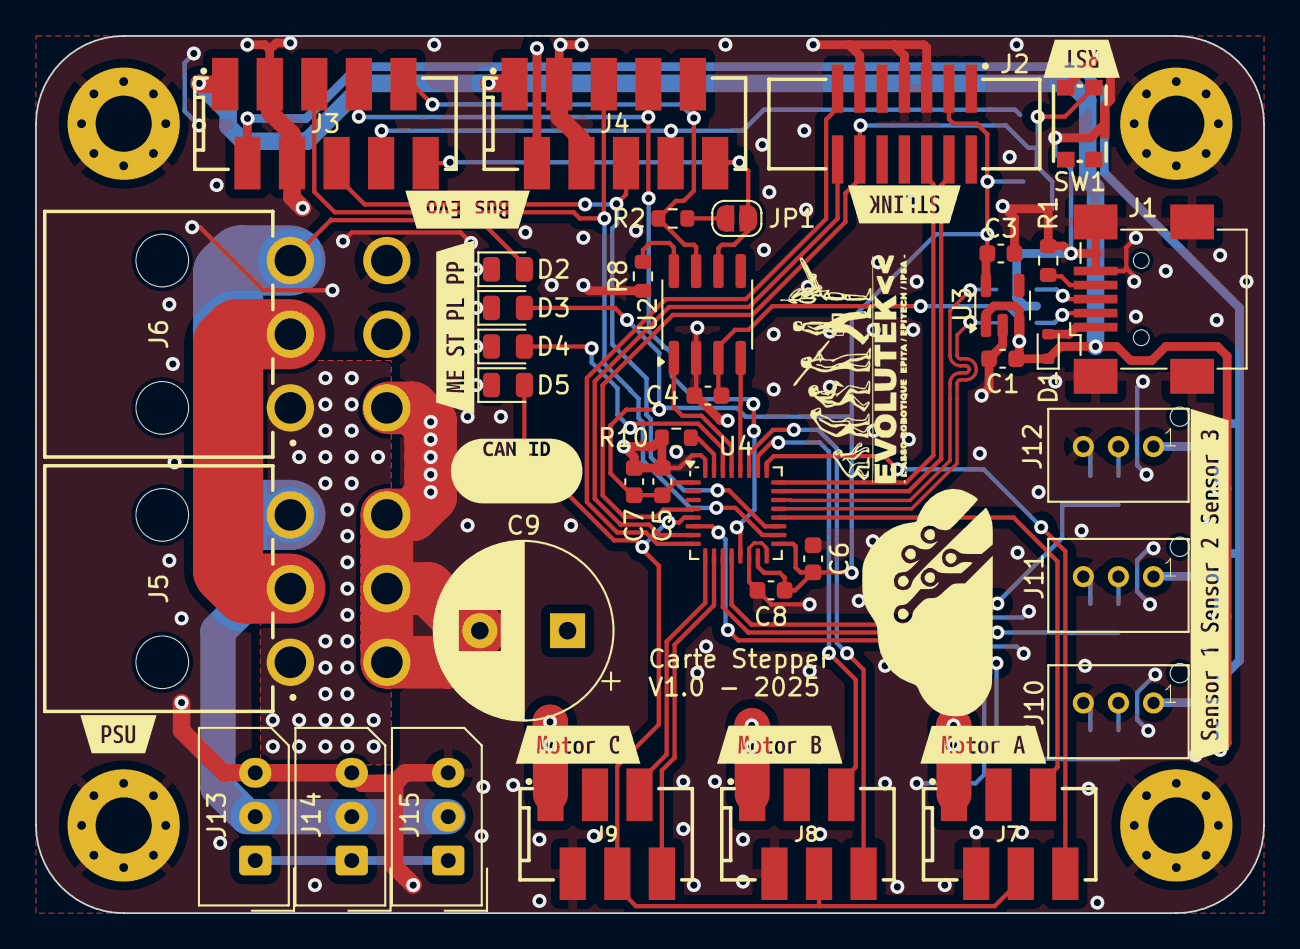
[picture p49: board carte-stepper.kicad_pcb from above]

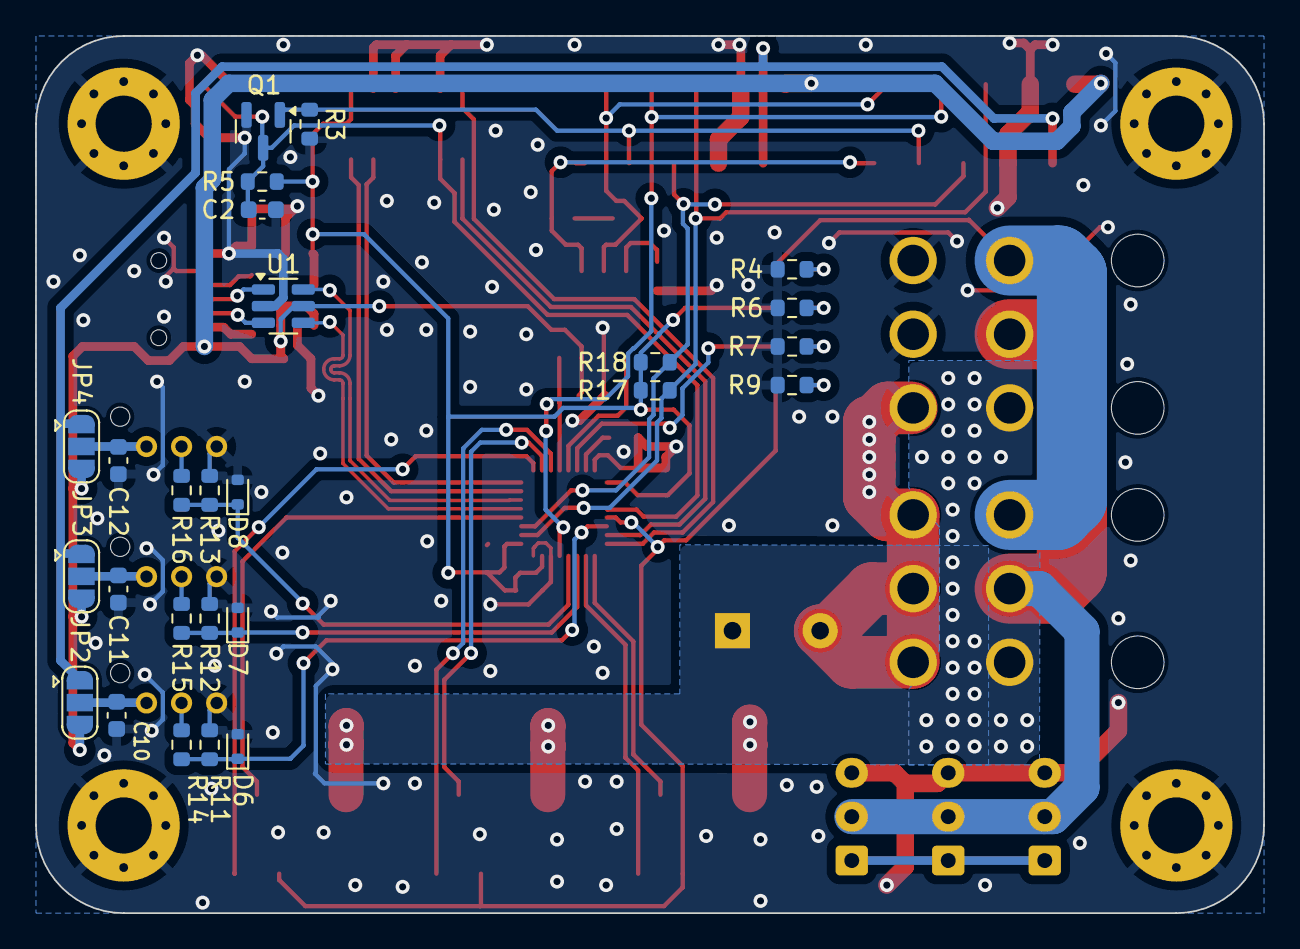
[picture p50: board carte-stepper.kicad_pcb from below]

Board: 2 copper layers, 70.0 x 50.0 mm, 79 parts (26 on the bottom side), 51 nets.

Other parts of the board:
kibuzzard-6823F4BA: G***; kibuzzard-6823F4BA
kibuzzard-6823F4E3: G***; kibuzzard-6823F4E3
kibuzzard-6823F4F6: G***; kibuzzard-6823F4F6
kibuzzard-6823F54E: G***; kibuzzard-6823F54E
kibuzzard-6823F58E: G***; kibuzzard-6823F58E
kibuzzard-6823F460: G***; kibuzzard-6823F460
kibuzzard-6823F506: G***; kibuzzard-6823F506
kibuzzard-6823F533: G***; kibuzzard-6823F533
kibuzzard-6823F573: G***; kibuzzard-6823F573
