evolutek/carte-actionneurs/Hub Bus Actuators/hub-bus-actuators.kicad_pcb

## KiCad design Hub Bus Actuators/hub-bus-actuators.kicad_pcb (2025-05-21)

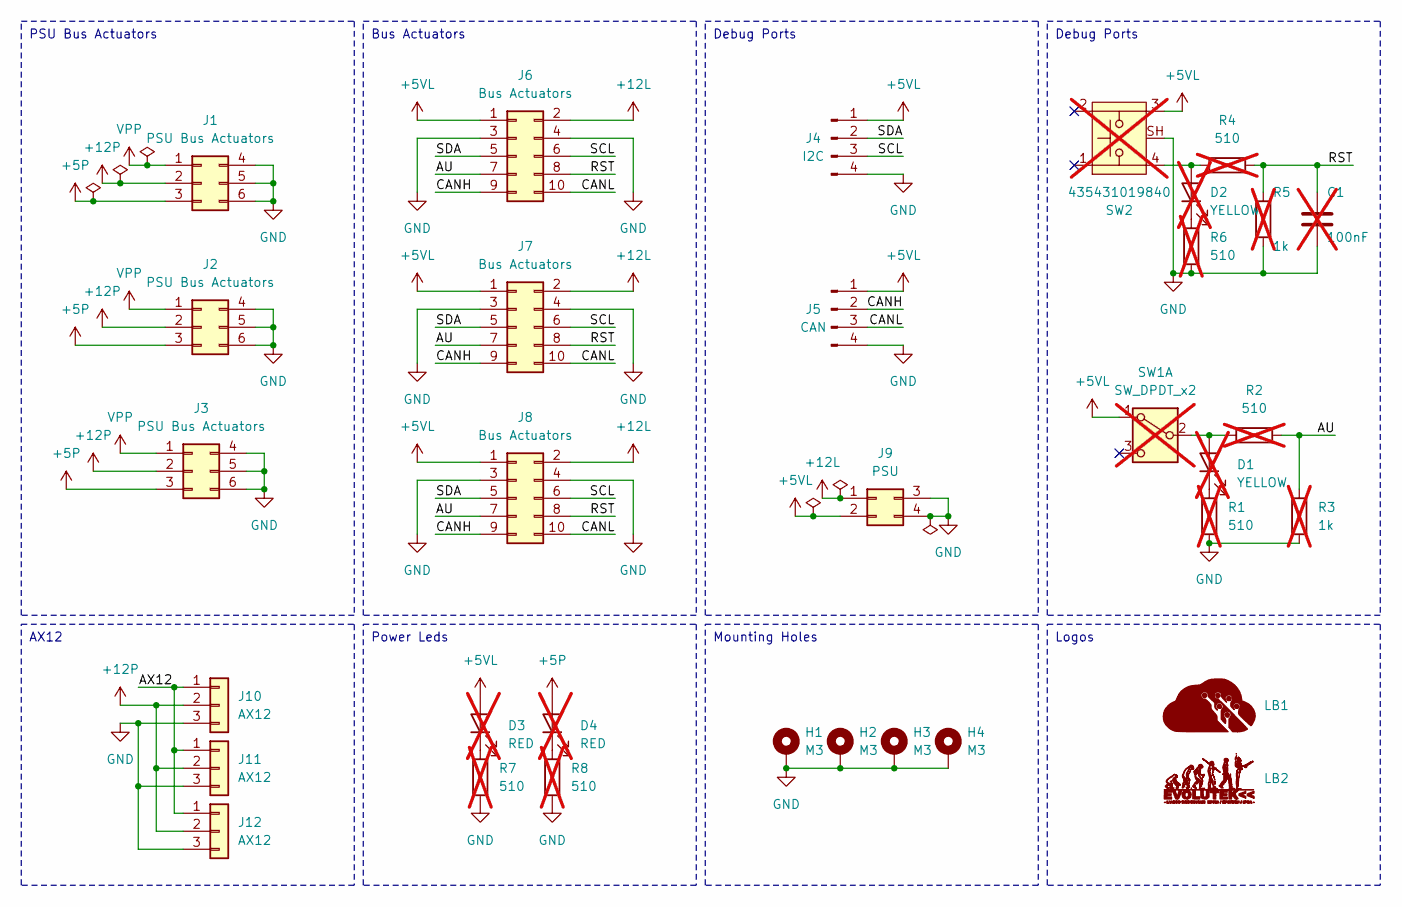
[picture p51: schematic hub-bus-actuators.kicad_sch, Hub Bus Actuators]

Parts:
C1: 100nF; C_0603_1608Metric; not fitted
D1, D2: YELLOW; LED_0805_2012Metric; not fitted
D3, D4: RED; LED_0805_2012Metric; not fitted
H1, H2, H3, H4: M3; MountingHole_3.2mm_M3_Pad_Via
J1, J2, J3: PSU Bus Actuators; 649006227222
J4: I2C; B04B-PASK
J5: CAN; B04B-PASK
J6, J7, J8: Bus Actuators; 690367281076
J9: PSU; 66200421022
J10, J11, J12: AX12; 22-03-5035
LB1: LOGO; Logo Aisler Min
LB2: LOGO; logo-evo-min
R1, R2, R4, R6, R7, R8: 510; R_0603_1608Metric; not fitted
R3, R5: 1k; R_0603_1608Metric; not fitted
SW1: SW_DPDT_x2; 452404020202; not fitted
SW2: 435431019840; not fitted

Connections:
+5P: D4.2 (A), J1.3, J2.3, J3.3
+5VL: D3.2 (A), J4.1, J5.1, J6.1, J7.1, J8.1, J9.2, SW1.1 (A), SW2.3
+12L: J6.2, J7.2, J8.2, J9.1
+12P: J1.2, J2.2, J3.2, J10.2, J11.2, J12.2
/AU: J6.7, J7.7, J8.7, R2.2, R3.1
/AX12: J10.1, J11.1, J12.1
/CANH: J5.2, J6.9, J7.9, J8.9
/CANL: J5.3, J6.10, J7.10, J8.10
/RST: C1.1, J6.8, J7.8, J8.8, R4.2, R5.1
/SCL: J4.3, J6.6, J7.6, J8.6
/SDA: J4.2, J6.5, J7.5, J8.5
GND: C1.2, H1.1, H2.1, H3.1, H4.1, J1.4, J1.5, J1.6, J2.4, J2.5, J2.6, J3.4, J3.5, J3.6, J4.4, J5.4, J6.3, J6.4, J7.3, J7.4, J8.3, J8.4, J9.3, J9.4, J10.3, J11.3, J12.3, R1.2, R3.2, R5.2, R6.2, R7.2, R8.2, SW2.SH
unnamed: D1.2 (A), R2.1, SW1.2 (B)
unnamed: D1.1 (K), R1.1
unnamed: D2.2 (A), R4.1, SW2.4
unnamed: D2.1 (K), R6.1
unnamed: D3.1 (K), R7.1
unnamed: D4.1 (K), R8.1
VPP: J1.1, J2.1, J3.1

Notes on the sheet:
Debug Ports
PSU Bus Actuators
Bus Actuators
AX12
Power Leds
Logos
Mounting Holes
