evolutek/carte-actionneurs/Hub Bus Actuators/hub-bus-actuators.kicad_pcb

## KiCad design Hub Bus Actuators/hub-bus-actuators.kicad_pcb (continued)

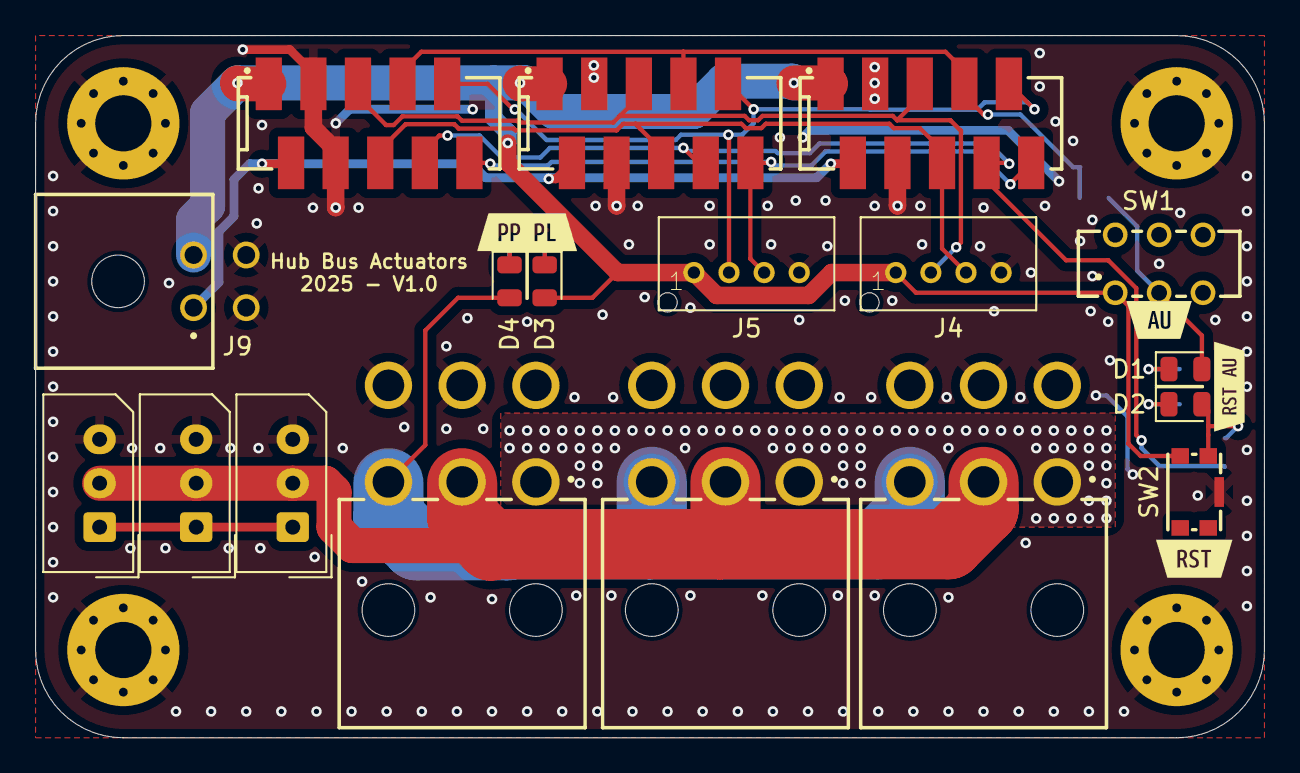
[picture p52: board hub-bus-actuators.kicad_pcb from above]

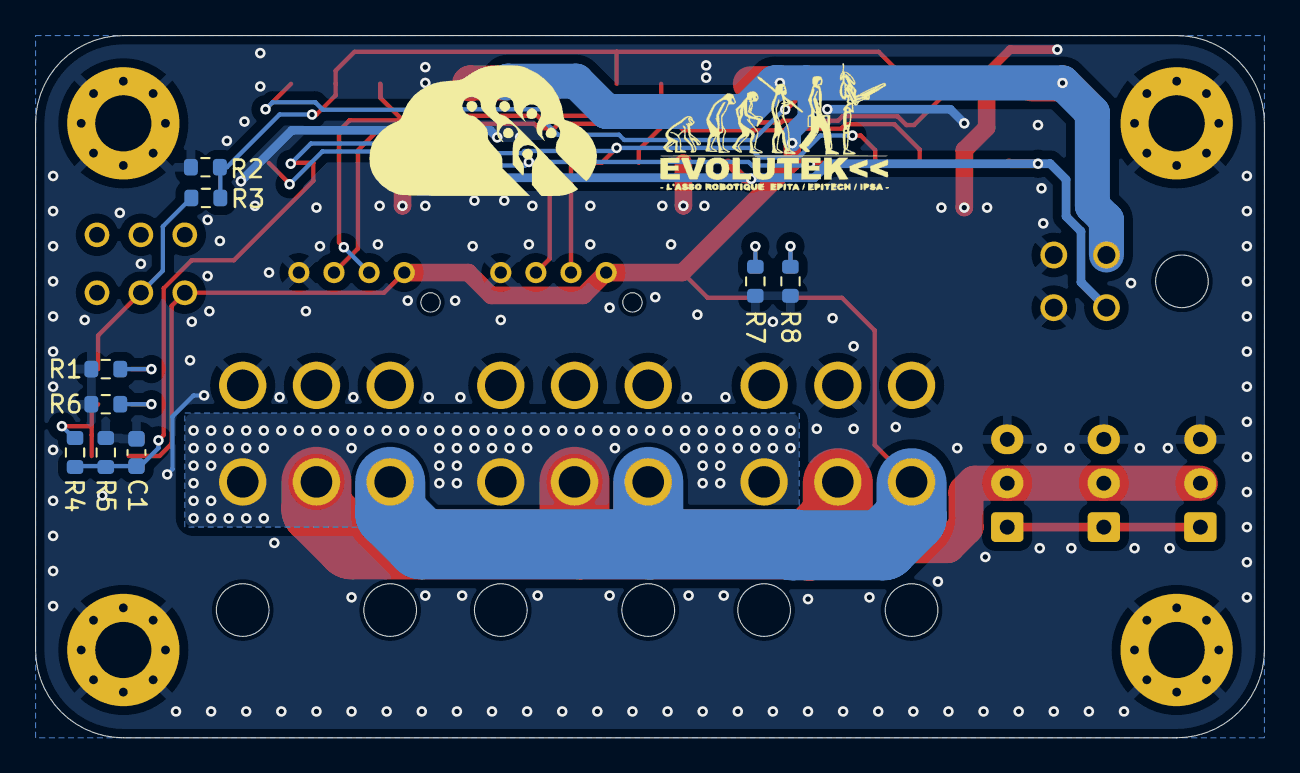
[picture p53: board hub-bus-actuators.kicad_pcb from below]

Board: 2 copper layers, 70.0 x 40.0 mm, 37 parts (11 on the bottom side), 19 nets.

Other parts of the board:
kibuzzard-68224E62: G***; kibuzzard-68224E62
kibuzzard-68224EAF: G***; kibuzzard-68224EAF
kibuzzard-68224EC2: G***; kibuzzard-68224EC2
kibuzzard-68224FF3: G***; kibuzzard-68224FF3
