evolutek/carte-actionneurs/V3 - Bis/carte-actionneurs.kicad_pcb

## KiCad design V3 - Bis/carte-actionneurs.kicad_pcb (2025-04-24)

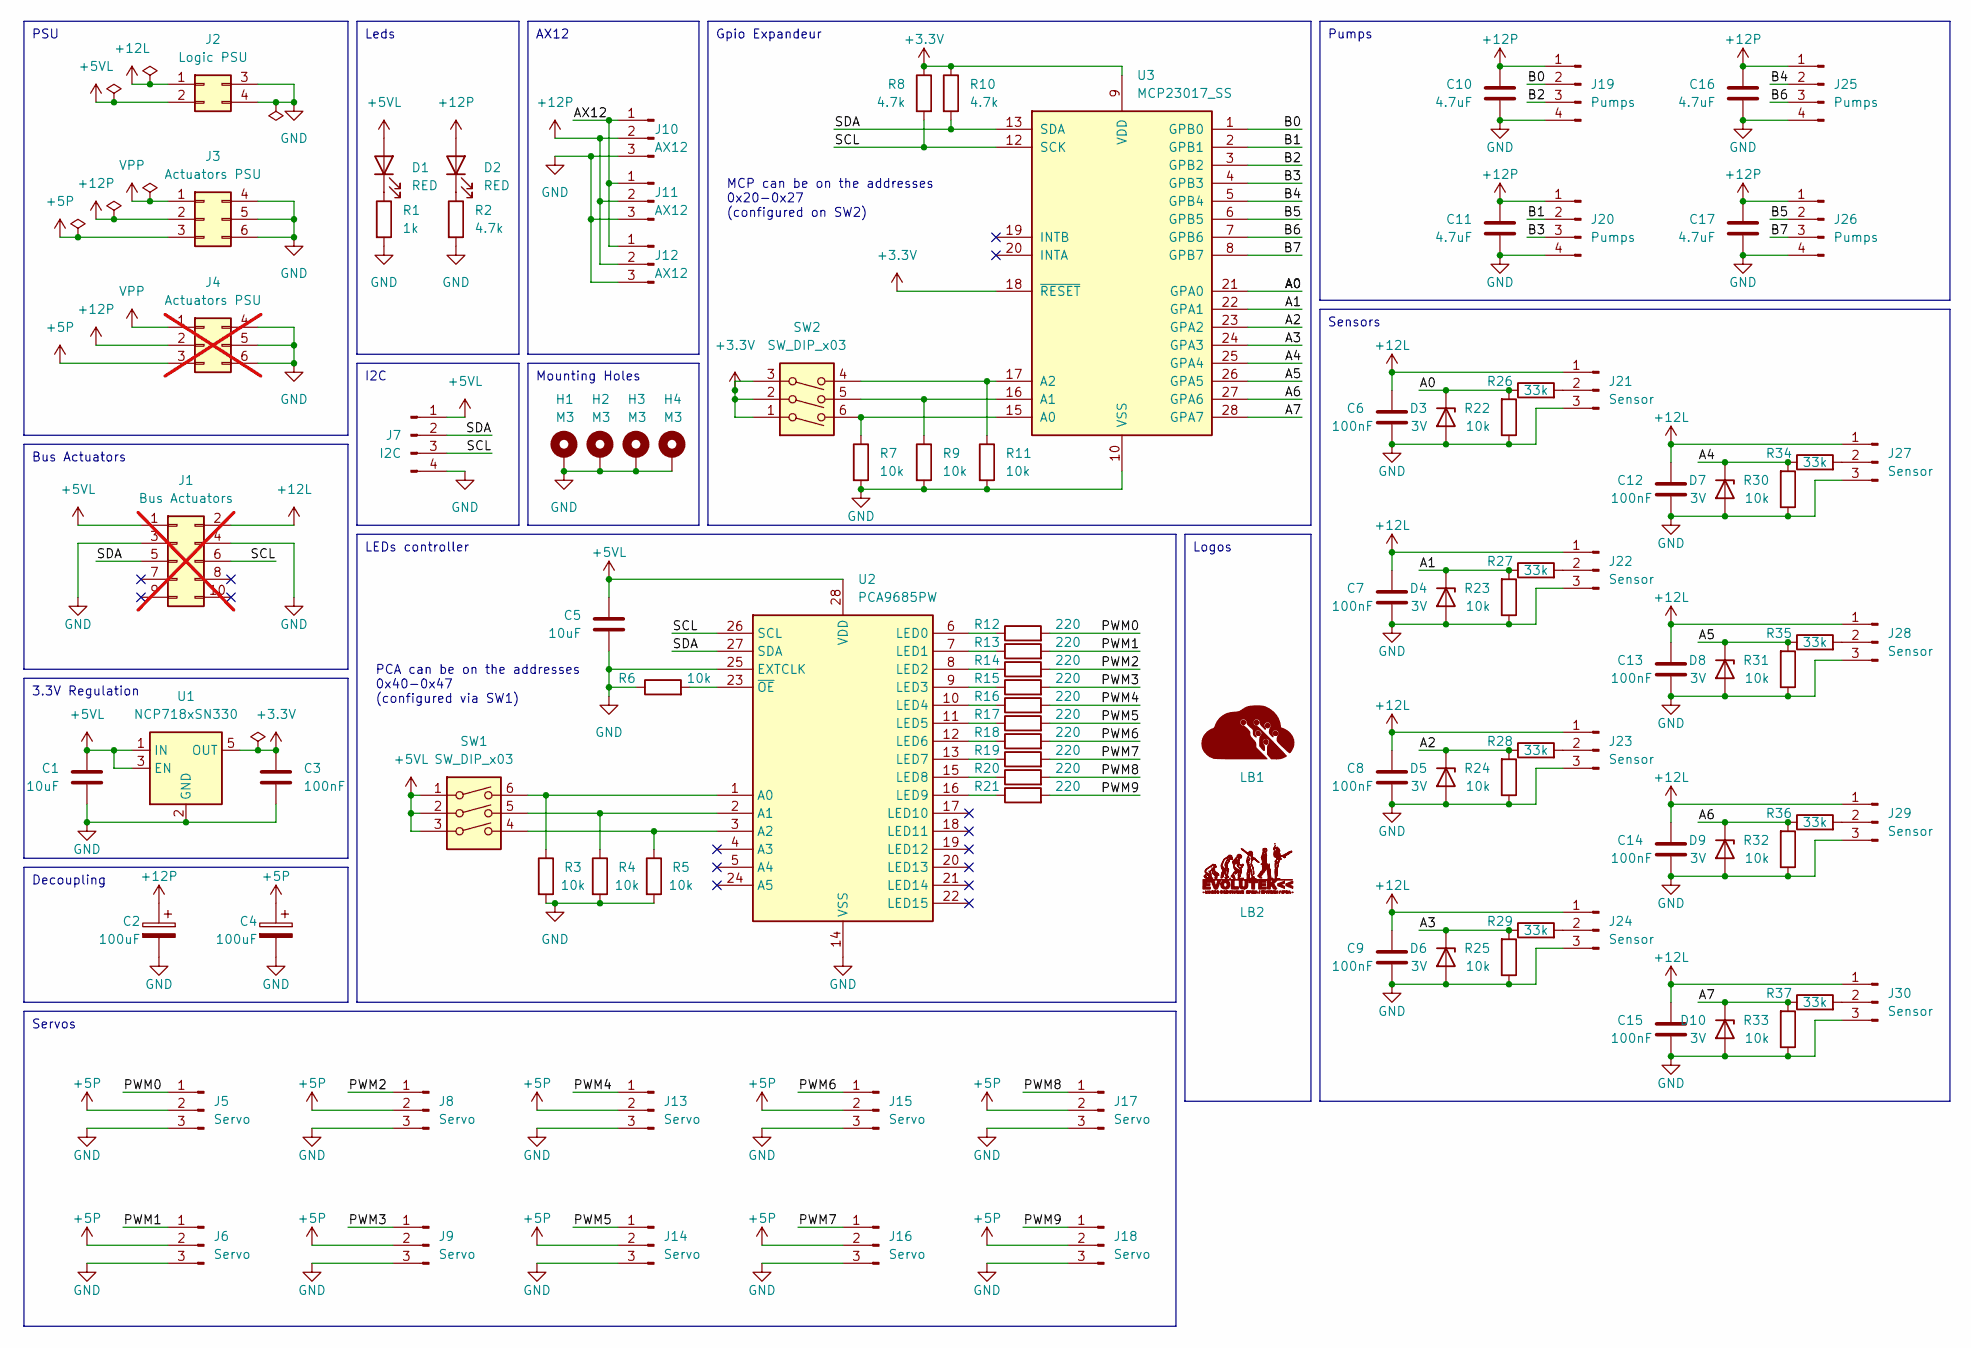
[picture p54: schematic carte-actionneurs.kicad_sch, Carte Actionneurs]

Parts:
C1, C5: 10uF; C_0603_1608Metric
C2, C4: 100uF; CP_Elec_6.3x7.7
C3, C6, C7, C8, C9, C12, C13, C14, C15: 100nF; C_0603_1608Metric
C10, C11, C16, C17: 4.7uF; C_0603_1608Metric
D1, D2: RED; LED_0805_2012Metric
D3, D4, D5, D6, D7, D8, D9, D10: 3V; D_SOD-523
H1, H2, H3, H4: M3; MountingHole_3.2mm_M3_Pad_Via
J1: Bus Actuators; 690367281076; not fitted
J2: Logic PSU; 66200421022
J3: Actuators PSU; 649006227222
J4: Actuators PSU; 649006227222; not fitted
J5, J6, J8, J9, J13, J14, J15, J16, J17, J18: Servo; PinHeader_1x03_P2.54mm_Vertical
J7: I2C; S04B-PASK
J10, J11, J12: AX12; 22-03-5035
J19, J20, J25, J26: Pumps; B04B-PASK
J21, J22, J23, J24, J27, J28, J29, J30: Sensor; B03B-PASK
LB1: LOGO; Logo Aisler Micro
LB2: LOGO; logo-evo-micro
R1: 1k; R_0603_1608Metric
R2, R8, R10: 4.7k; R_0603_1608Metric
R3, R4, R5, R6, R7, R9, R11, R22, R23, R24, R25, R30, R31, R32, R33: 10k; R_0603_1608Metric
R12, R13, R14, R15, R16, R17, R18, R19, R20, R21: 220; R_0603_1608Metric
R26, R27, R28, R29, R34, R35, R36, R37: 33k; R_0603_1608Metric
SW1, SW2: SW_DIP_x03; SW_DIP_SPSTx03_Slide_KingTek_DSHP03TS_W7.62mm_P1.27mm
U1: NCP718xSN330; SOT-23-5
U2: PCA9685PW; TSSOP-28_4.4x9.7mm_P0.65mm
U3: MCP23017_SS; SSOP-28_5.3x10.2mm_P0.65mm

Connections:
+3.3V: C3.1, R8.1, R10.1, SW2.1, SW2.2, SW2.3, U1.5 (OUT), U3.9 (VDD), U3.18 (~RESET)
+5P: C4.1, J3.3, J4.3, J5.2, J6.2, J8.2, J9.2, J13.2, J14.2, J15.2, J16.2, J17.2, J18.2
+5VL: C1.1, C5.2, D1.2 (A), J1.1, J2.2, J7.1, SW1.1, SW1.2, SW1.3, U1.1 (IN), U1.3 (EN), U2.28 (VDD)
+12L: C6.2, C7.2, C8.2, C9.2, C12.2, C13.2, C14.2, C15.2, J1.2, J2.1, J21.1, J22.1, J23.1, J24.1, J27.1, J28.1, J29.1, J30.1
+12P: C2.1, C10.1, C11.1, C16.1, C17.1, D2.2 (A), J3.2, J4.2, J10.2, J11.2, J12.2, J19.1, J20.1, J25.1, J26.1
/A0: D3.1 (K), R22.2, R26.1, U3.21 (GPA0)
/A1: D4.1 (K), R23.2, R27.1, U3.22 (GPA1)
/A2: D5.1 (K), R24.2, R28.1, U3.23 (GPA2)
/A3: D6.1 (K), R25.2, R29.1, U3.24 (GPA3)
/A4: D7.1 (K), R30.2, R34.1, U3.25 (GPA4)
/A5: D8.1 (K), R31.2, R35.1, U3.26 (GPA5)
/A6: D9.1 (K), R32.2, R36.1, U3.27 (GPA6)
/A7: D10.1 (K), R33.2, R37.1, U3.28 (GPA7)
/AX12: J10.1, J11.1, J12.1
/B0: J19.2, U3.1 (GPB0)
/B1: J20.2, U3.2 (GPB1)
/B2: J19.3, U3.3 (GPB2)
/B3: J20.3, U3.4 (GPB3)
/B4: J25.2, U3.5 (GPB4)
/B5: J26.2, U3.6 (GPB5)
/B6: J25.3, U3.7 (GPB6)
/B7: J26.3, U3.8 (GPB7)
/PWM0: J5.1, R12.2
/PWM1: J6.1, R13.2
/PWM2: J8.1, R14.2
/PWM3: J9.1, R15.2
/PWM4: J13.1, R16.2
/PWM5: J14.1, R17.2
/PWM6: J15.1, R18.2
/PWM7: J16.1, R19.2
/PWM8: J17.1, R20.2
/PWM9: J18.1, R21.2
/SCL: J1.6, J7.3, R8.2, U2.26 (SCL), U3.12 (SCK)
/SDA: J1.5, J7.2, R10.2, U2.27 (SDA), U3.13 (SDA)
GND: C1.2, C2.2, C3.2, C4.2, C5.1, C6.1, C7.1, C8.1, C9.1, C10.2, C11.2, C12.1, C13.1, C14.1, C15.1, C16.2, C17.2, D3.2 (A), D4.2 (A), D5.2 (A), D6.2 (A), D7.2 (A), D8.2 (A), D9.2 (A), D10.2 (A), H1.1, H2.1, H3.1, H4.1, J1.3, J1.4, J2.3, J2.4, J3.4, J3.5, J3.6, J4.4, J4.5, J4.6, J5.3, J6.3, J7.4, J8.3, J9.3, J10.3, J11.3, J12.3, J13.3, J14.3, J15.3, J16.3, J17.3, J18.3, J19.4, J20.4, J21.3, J22.3, J23.3, J24.3, J25.4, J26.4, J27.3, J28.3, J29.3, J30.3, R1.2, R2.2, R3.2, R4.2, R5.2, R6.1, R7.2, R9.2, R11.2, R22.1, R23.1, R24.1, R25.1, R30.1, R31.1, R32.1, R33.1, U1.2 (GND), U2.14 (VSS), U2.25 (EXTCLK), U3.10 (VSS)
unnamed: D1.1 (K), R1.1
unnamed: D2.1 (K), R2.1
unnamed: J21.2, R26.2
unnamed: J22.2, R27.2
unnamed: J23.2, R28.2
unnamed: J24.2, R29.2
unnamed: J27.2, R34.2
unnamed: J28.2, R35.2
unnamed: J29.2, R36.2
unnamed: J30.2, R37.2
unnamed: R3.1, SW1.6, U2.1 (A0)
unnamed: R4.1, SW1.5, U2.2 (A1)
unnamed: R5.1, SW1.4, U2.3 (A2)
unnamed: R12.1, U2.6 (LED0)
unnamed: R13.1, U2.7 (LED1)
unnamed: R14.1, U2.8 (LED2)
unnamed: R15.1, U2.9 (LED3)
unnamed: R16.1, U2.10 (LED4)
unnamed: R17.1, U2.11 (LED5)
unnamed: R18.1, U2.12 (LED6)
unnamed: R19.1, U2.13 (LED7)
unnamed: R20.1, U2.15 (LED8)
unnamed: R21.1, U2.16 (LED9)
unnamed: R6.2, U2.23 (~OE)
unnamed: R7.1, SW2.6, U3.15 (A0)
unnamed: R9.1, SW2.5, U3.16 (A1)
unnamed: R11.1, SW2.4, U3.17 (A2)
VPP: J3.1, J4.1

Notes on the sheet:
Decoupling
LEDs controller
Pumps
3.3V Regulation
AX12
Gpio Expandeur
Bus Actuators
PSU
Sensors
I2C
Leds
Servos
Logos
Mounting Holes
MCP can be on the addresses 0x20-0x27 (configured on SW2)
PCA can be on the addresses 0x40-0x47 (configured via SW1)

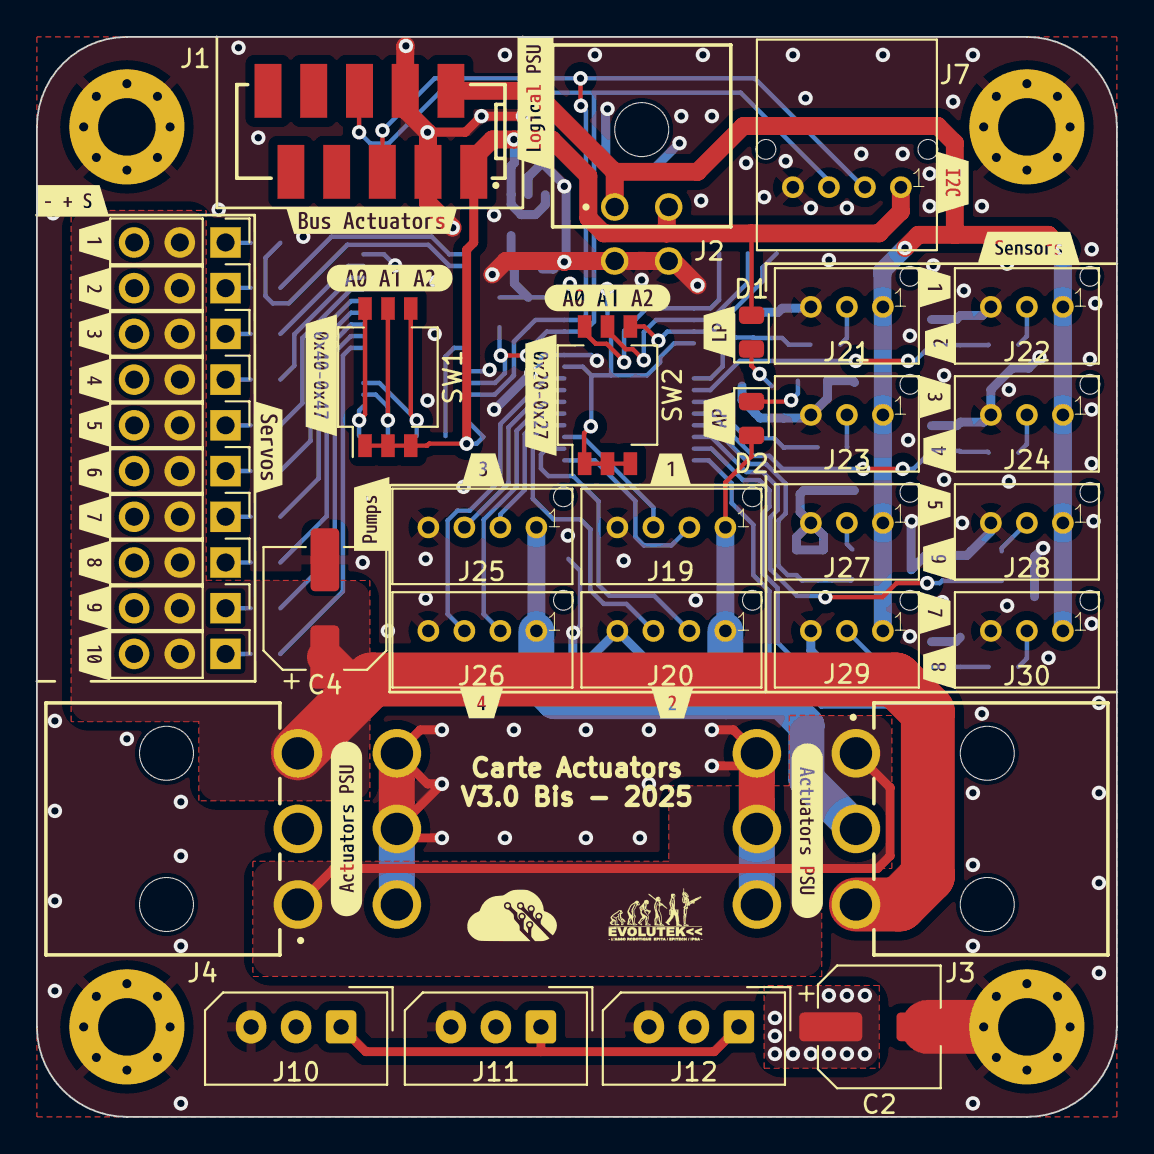
[picture p55: board V3 - Bis/carte-actionneurs.kicad_pcb from above]

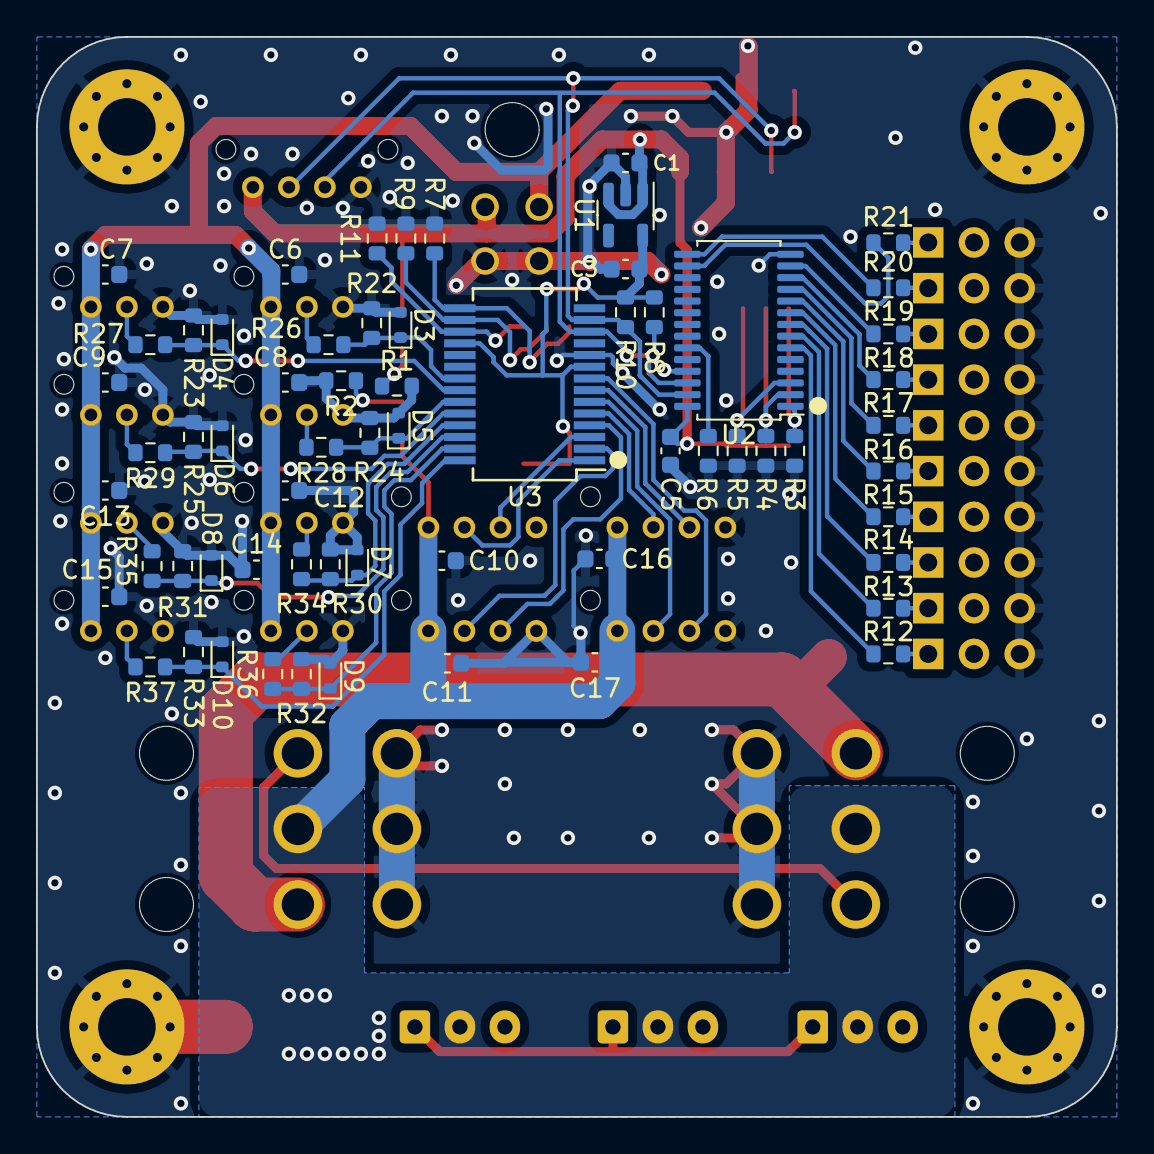
[picture p56: board V3 - Bis/carte-actionneurs.kicad_pcb from below]

Board: 2 copper layers, 60.0 x 60.0 mm, 142 parts (63 on the bottom side), 63 nets.

Other parts of the board:
kibuzzard-67DB1DCF: G***; kibuzzard-67DB1DCF
kibuzzard-67DB1EBA: G***; kibuzzard-67DB1EBA
kibuzzard-67DB1F5A: G***; kibuzzard-67DB1F5A
kibuzzard-67DB1F7E: G***; kibuzzard-67DB1F7E
kibuzzard-67DB20D4: G***; kibuzzard-67DB20D4
kibuzzard-67DB21C8: G***; kibuzzard-67DB21C8
kibuzzard-67DB21E7: G***; kibuzzard-67DB21E7
kibuzzard-67DB24C4: G***; kibuzzard-67DB24C4
kibuzzard-67DB24DA: G***; kibuzzard-67DB24DA
kibuzzard-67DB24FC: G***; kibuzzard-67DB24FC
kibuzzard-67DB25A1: G***; kibuzzard-67DB25A1
kibuzzard-67DB25A9: G***; kibuzzard-67DB25A9
kibuzzard-67DB249C, kibuzzard-67DB249C#2: G***; kibuzzard-67DB249C
kibuzzard-67DB250F: G***; kibuzzard-67DB250F
kibuzzard-67DB254D: G***; kibuzzard-67DB254D
kibuzzard-67DB255B: G***; kibuzzard-67DB255B
kibuzzard-67DB255E: G***; kibuzzard-67DB255E
kibuzzard-67DB258B: G***; kibuzzard-67DB258B
kibuzzard-67DB2328: G***; kibuzzard-67DB2328
kibuzzard-67DB2592: G***; kibuzzard-67DB2592
kibuzzard-67DC45A0: G***; kibuzzard-67DC45A0
kibuzzard-67DC45A4: G***; kibuzzard-67DC45A4
kibuzzard-67DC45A8: G***; kibuzzard-67DC45A8
kibuzzard-67DC45AC: G***; kibuzzard-67DC45AC
kibuzzard-67DC45B0: G***; kibuzzard-67DC45B0
kibuzzard-67DC45B3: G***; kibuzzard-67DC45B3
kibuzzard-67DC45B7: G***; kibuzzard-67DC45B7
kibuzzard-67DC45BB: G***; kibuzzard-67DC45BB
kibuzzard-67DC45E2, kibuzzard-67DC45E2#2: G***; kibuzzard-67DC45E2
kibuzzard-67DC459C: G***; kibuzzard-67DC459C
kibuzzard-67DC4572: G***; kibuzzard-67DC4572
kibuzzard-660644DA, kibuzzard-660644DA#2: G***; kibuzzard-660644DA
kibuzzard-6606460E: G***; kibuzzard-6606460E
kibuzzard-66064268: G***; kibuzzard-66064268
