evolutek/carte-actionneurs/V3/carte-actionneurs.kicad_pcb

## KiCad design V3/carte-actionneurs.kicad_pcb (2024-08-19, an earlier design)

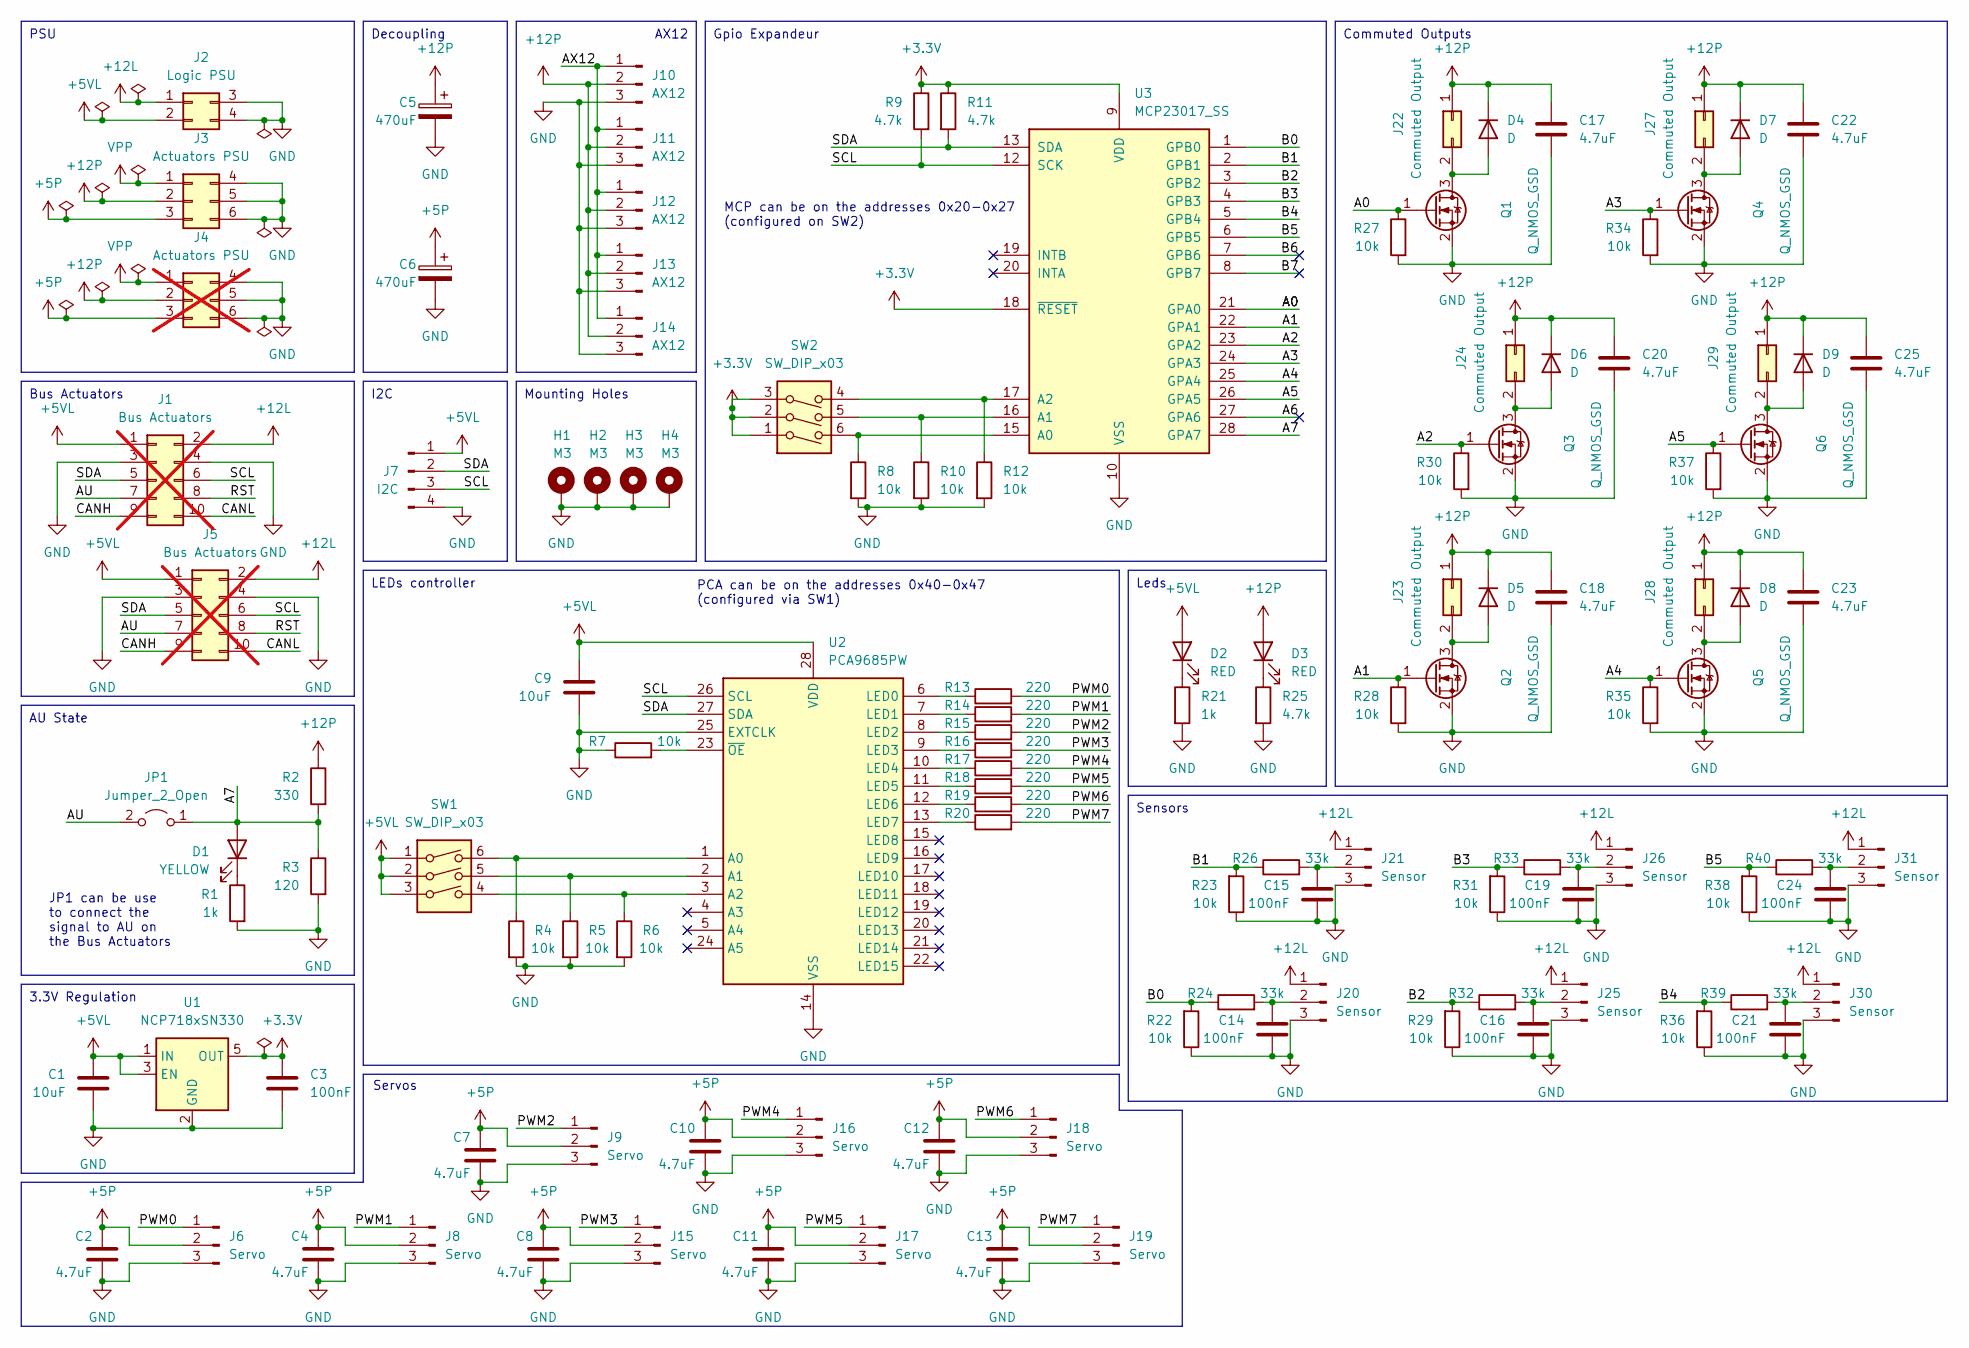
[picture p57: schematic carte-actionneurs.kicad_sch, Carte Actionneurs]

Parts:
C1, C9: 10uF; C_0603_1608Metric
C2, C4, C7, C8, C10, C11, C12, C13, C17, C18, C20, C22, C23, C25: 4.7uF; C_0603_1608Metric
C3, C14, C15, C16, C19, C21, C24: 100nF; C_0603_1608Metric
C5, C6: 470uF; CP_Radial_D10.0mm_P5.00mm
D1: YELLOW; LED_0805_2012Metric
D2, D3: RED; LED_0805_2012Metric
D4, D5, D6, D7, D8, D9: D; D_SMB
H1, H2, H3, H4: M3; MountingHole_3.2mm_M3_Pad_Via
J1, J5: Bus Actuators; 690367281076; not fitted
J2: Logic PSU; 66200421022
J3: Actuators PSU; 649006227222
J4: Actuators PSU; 649006227222; not fitted
J6, J8, J9, J15, J16, J17, J18, J19: Servo; PinHeader_1x03_P2.54mm_Vertical
J7: I2C; S04B-PASK
J10, J11, J12, J13, J14: AX12; 22-03-5035
J20, J21, J25, J26, J30, J31: Sensor; B03B-PASK
J22, J23, J24, J27, J28, J29: Commuted Output; 66200221124
JP1: Jumper_2_Open; PinHeader_1x02_P2.54mm_Vertical
Q1, Q2, Q3, Q4, Q5, Q6: Q_NMOS_GSD; SOT-23
R1, R21: 1k; R_0603_1608Metric
R2: 330; R_0603_1608Metric
R3: 120; R_0603_1608Metric
R4, R5, R6, R7, R8, R10, R12, R22, R23, R27, R28, R29, R30, R31, R34, R35, R36, R37, R38: 10k; R_0603_1608Metric
R9, R11, R25: 4.7k; R_0603_1608Metric
R13, R14, R15, R16, R17, R18, R19, R20: 220; R_0603_1608Metric
R24, R26, R32, R33, R39, R40: 33k; R_0603_1608Metric
SW1, SW2: SW_DIP_x03; SW_DIP_SPSTx03_Slide_KingTek_DSHP03TS_W7.62mm_P1.27mm
U1: NCP718xSN330; SOT-23-5
U2: PCA9685PW; TSSOP-28_4.4x9.7mm_P0.65mm
U3: MCP23017_SS; SSOP-28_5.3x10.2mm_P0.65mm

Connections:
+3.3V: C3.1, R9.1, R11.1, SW2.1, SW2.2, SW2.3, U1.5 (OUT), U3.9 (VDD), U3.18 (~RESET)
+5P: C2.1, C4.1, C6.1, C7.1, C8.1, C10.1, C11.1, C12.1, C13.1, J3.3, J4.3, J6.2, J8.2, J9.2, J15.2, J16.2, J17.2, J18.2, J19.2
+5VL: C1.1, C9.2, D2.2 (A), J1.1, J2.2, J5.1, J7.1, SW1.1, SW1.2, SW1.3, U1.1 (IN), U1.3 (EN), U2.28 (VDD)
+12L: J1.2, J2.1, J5.2, J20.1, J21.1, J25.1, J26.1, J30.1, J31.1
+12P: C5.1, C17.1, C18.1, C20.1, C22.1, C23.1, C25.1, D3.2 (A), D4.1 (K), D5.1 (K), D6.1 (K), D7.1 (K), D8.1 (K), D9.1 (K), J3.2, J4.2, J10.2, J11.2, J12.2, J13.2, J14.2, J22.1, J23.1, J24.1, J27.1, J28.1, J29.1, R2.1
/A0: Q1.1 (G), R27.1, U3.21 (GPA0)
/A1: Q2.1 (G), R28.1, U3.22 (GPA1)
/A2: Q3.1 (G), R30.1, U3.23 (GPA2)
/A3: Q4.1 (G), R34.1, U3.24 (GPA3)
/A4: Q5.1 (G), R35.1, U3.25 (GPA4)
/A5: Q6.1 (G), R37.1, U3.26 (GPA5)
/A6: U3.27 (GPA6)
/A7: D1.2 (A), JP1.1 (A), R2.2, R3.1, U3.28 (GPA7)
/AU: J1.7, J5.7, JP1.2 (B)
/AX12: J10.1, J11.1, J12.1, J13.1, J14.1
/B0: R22.2, R24.1, U3.1 (GPB0)
/B1: R23.2, R26.1, U3.2 (GPB1)
/B2: R29.2, R32.1, U3.3 (GPB2)
/B3: R31.2, R33.1, U3.4 (GPB3)
/B4: R36.2, R39.1, U3.5 (GPB4)
/B5: R38.2, R40.1, U3.6 (GPB5)
/B6: U3.7 (GPB6)
/B7: U3.8 (GPB7)
/CANH: J1.9, J5.9
/CANL: J1.10, J5.10
/PWM0: J6.1, R13.2
/PWM1: J8.1, R14.2
/PWM2: J9.1, R15.2
/PWM3: J15.1, R16.2
/PWM4: J16.1, R17.2
/PWM5: J17.1, R18.2
/PWM6: J18.1, R19.2
/PWM7: J19.1, R20.2
/RST: J1.8, J5.8
/SCL: J1.6, J5.6, J7.3, R9.2, U2.26 (SCL), U3.12 (SCK)
/SDA: J1.5, J5.5, J7.2, R11.2, U2.27 (SDA), U3.13 (SDA)
GND: C1.2, C2.2, C3.2, C4.2, C5.2, C6.2, C7.2, C8.2, C9.1, C10.2, C11.2, C12.2, C13.2, C14.1, C15.1, C16.1, C17.2, C18.2, C19.1, C20.2, C21.1, C22.2, C23.2, C24.1, C25.2, H1.1, H2.1, H3.1, H4.1, J1.3, J1.4, J2.3, J2.4, J3.4, J3.5, J3.6, J4.4, J4.5, J4.6, J5.3, J5.4, J6.3, J7.4, J8.3, J9.3, J10.3, J11.3, J12.3, J13.3, J14.3, J15.3, J16.3, J17.3, J18.3, J19.3, J20.3, J21.3, J25.3, J26.3, J30.3, J31.3, Q1.2 (S), Q2.2 (S), Q3.2 (S), Q4.2 (S), Q5.2 (S), Q6.2 (S), R1.2, R3.2, R4.2, R5.2, R6.2, R7.1, R8.2, R10.2, R12.2, R21.2, R22.1, R23.1, R25.2, R27.2, R28.2, R29.1, R30.2, R31.1, R34.2, R35.2, R36.1, R37.2, R38.1, U1.2 (GND), U2.14 (VSS), U2.25 (EXTCLK), U3.10 (VSS)
unnamed: D1.1 (K), R1.1
unnamed: D2.1 (K), R21.1
unnamed: D3.1 (K), R25.1
unnamed: D4.2 (A), J22.2, Q1.3 (D)
unnamed: D5.2 (A), J23.2, Q2.3 (D)
unnamed: D6.2 (A), J24.2, Q3.3 (D)
unnamed: D7.2 (A), J27.2, Q4.3 (D)
unnamed: D8.2 (A), J28.2, Q5.3 (D)
unnamed: D9.2 (A), J29.2, Q6.3 (D)
unnamed: C14.2, J20.2, R24.2
unnamed: C15.2, J21.2, R26.2
unnamed: C16.2, J25.2, R32.2
unnamed: C19.2, J26.2, R33.2
unnamed: C21.2, J30.2, R39.2
unnamed: C24.2, J31.2, R40.2
unnamed: R4.1, SW1.6, U2.1 (A0)
unnamed: R5.1, SW1.5, U2.2 (A1)
unnamed: R6.1, SW1.4, U2.3 (A2)
unnamed: R13.1, U2.6 (LED0)
unnamed: R14.1, U2.7 (LED1)
unnamed: R15.1, U2.8 (LED2)
unnamed: R16.1, U2.9 (LED3)
unnamed: R17.1, U2.10 (LED4)
unnamed: R18.1, U2.11 (LED5)
unnamed: R19.1, U2.12 (LED6)
unnamed: R20.1, U2.13 (LED7)
unnamed: R7.2, U2.23 (~OE)
unnamed: R8.1, SW2.6, U3.15 (A0)
unnamed: R10.1, SW2.5, U3.16 (A1)
unnamed: R12.1, SW2.4, U3.17 (A2)
VPP: J3.1, J4.1

Notes on the sheet:
Decoupling
LEDs controller
AU State
3.3V Regulation
AX12
Gpio Expandeur
Bus Actuators
PSU
Sensors
Commuted Outputs
I2C
Leds
Mounting Holes
JP1 can be use to connect the signal to AU on the Bus Actuators
MCP can be on the addresses 0x20-0x27 (configured on SW2)
PCA can be on the addresses 0x40-0x47 (configured via SW1)
Servos

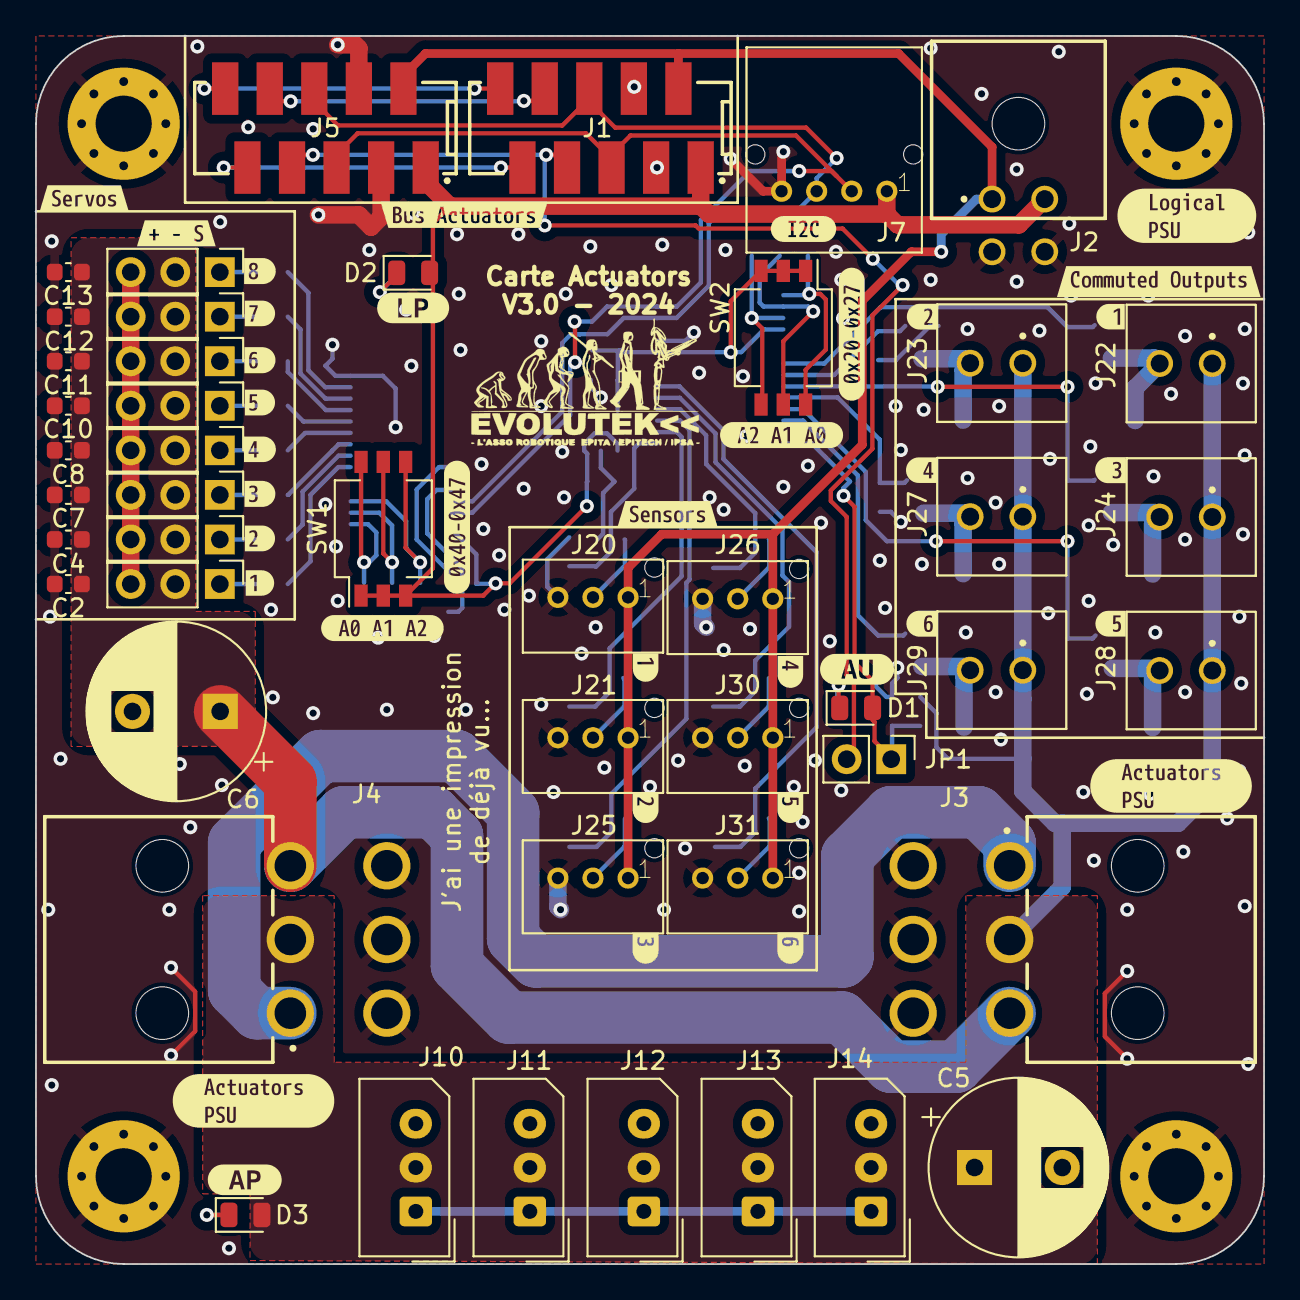
[picture p58: board V3/carte-actionneurs.kicad_pcb from above]

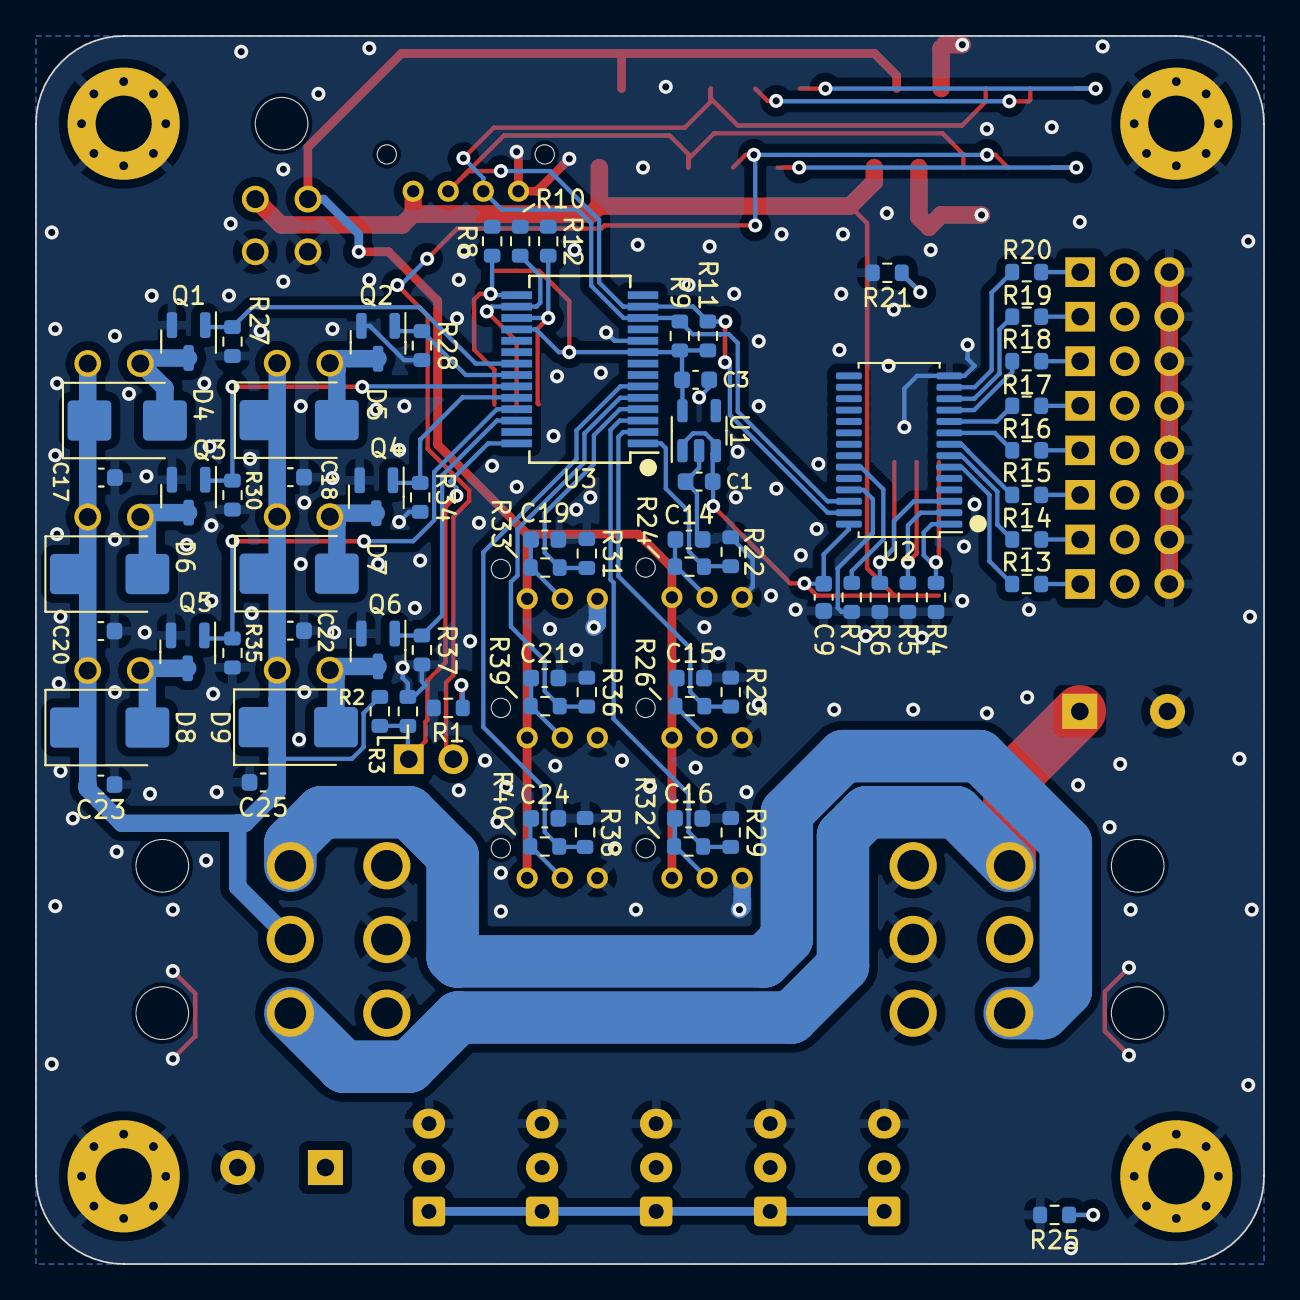
[picture p59: board V3/carte-actionneurs.kicad_pcb from below]

Board: 2 copper layers, 70.0 x 70.0 mm, 157 parts (70 on the bottom side), 65 nets.

Other parts of the board:
kibuzzard-660640BC: G***; kibuzzard-660640BC
kibuzzard-660640D0, kibuzzard-660640D0#2: G***; kibuzzard-660640D0
kibuzzard-660641A3: G***; kibuzzard-660641A3
kibuzzard-660641AA: G***; kibuzzard-660641AA
kibuzzard-660641B1: G***; kibuzzard-660641B1
kibuzzard-660642A2: G***; kibuzzard-660642A2
kibuzzard-660642AA: G***; kibuzzard-660642AA
kibuzzard-660642B1: G***; kibuzzard-660642B1
kibuzzard-660642BD: G***; kibuzzard-660642BD
kibuzzard-660642C9: G***; kibuzzard-660642C9
kibuzzard-660642D5: G***; kibuzzard-660642D5
kibuzzard-660643A8: G***; kibuzzard-660643A8
kibuzzard-660643B2: G***; kibuzzard-660643B2
kibuzzard-660643BA: G***; kibuzzard-660643BA
kibuzzard-660643C5: G***; kibuzzard-660643C5
kibuzzard-660644AE: G***; kibuzzard-660644AE
kibuzzard-660644C2: G***; kibuzzard-660644C2
kibuzzard-660644DA: G***; kibuzzard-660644DA
kibuzzard-660644F6: G***; kibuzzard-660644F6
kibuzzard-6606413C: G***; kibuzzard-6606413C
kibuzzard-6606417C: G***; kibuzzard-6606417C
kibuzzard-6606419C: G***; kibuzzard-6606419C
kibuzzard-6606427D: G***; kibuzzard-6606427D
kibuzzard-6606439F: G***; kibuzzard-6606439F
kibuzzard-6606460E: G***; kibuzzard-6606460E
kibuzzard-66064069: G***; kibuzzard-66064069
kibuzzard-66064080: G***; kibuzzard-66064080
kibuzzard-66064088: G***; kibuzzard-66064088
kibuzzard-66064160: G***; kibuzzard-66064160
kibuzzard-66064190: G***; kibuzzard-66064190
kibuzzard-66064268: G***; kibuzzard-66064268
kibuzzard-66064292: G***; kibuzzard-66064292
kibuzzard-66064322: G***; kibuzzard-66064322
kibuzzard-66064381: G***; kibuzzard-66064381
kibuzzard-66064500: G***; kibuzzard-66064500
