evolutek/carte-actionneurs/V2/V2.kicad_pcb

## KiCad design V2/V2.kicad_pcb (2023-05-09, an earlier design)

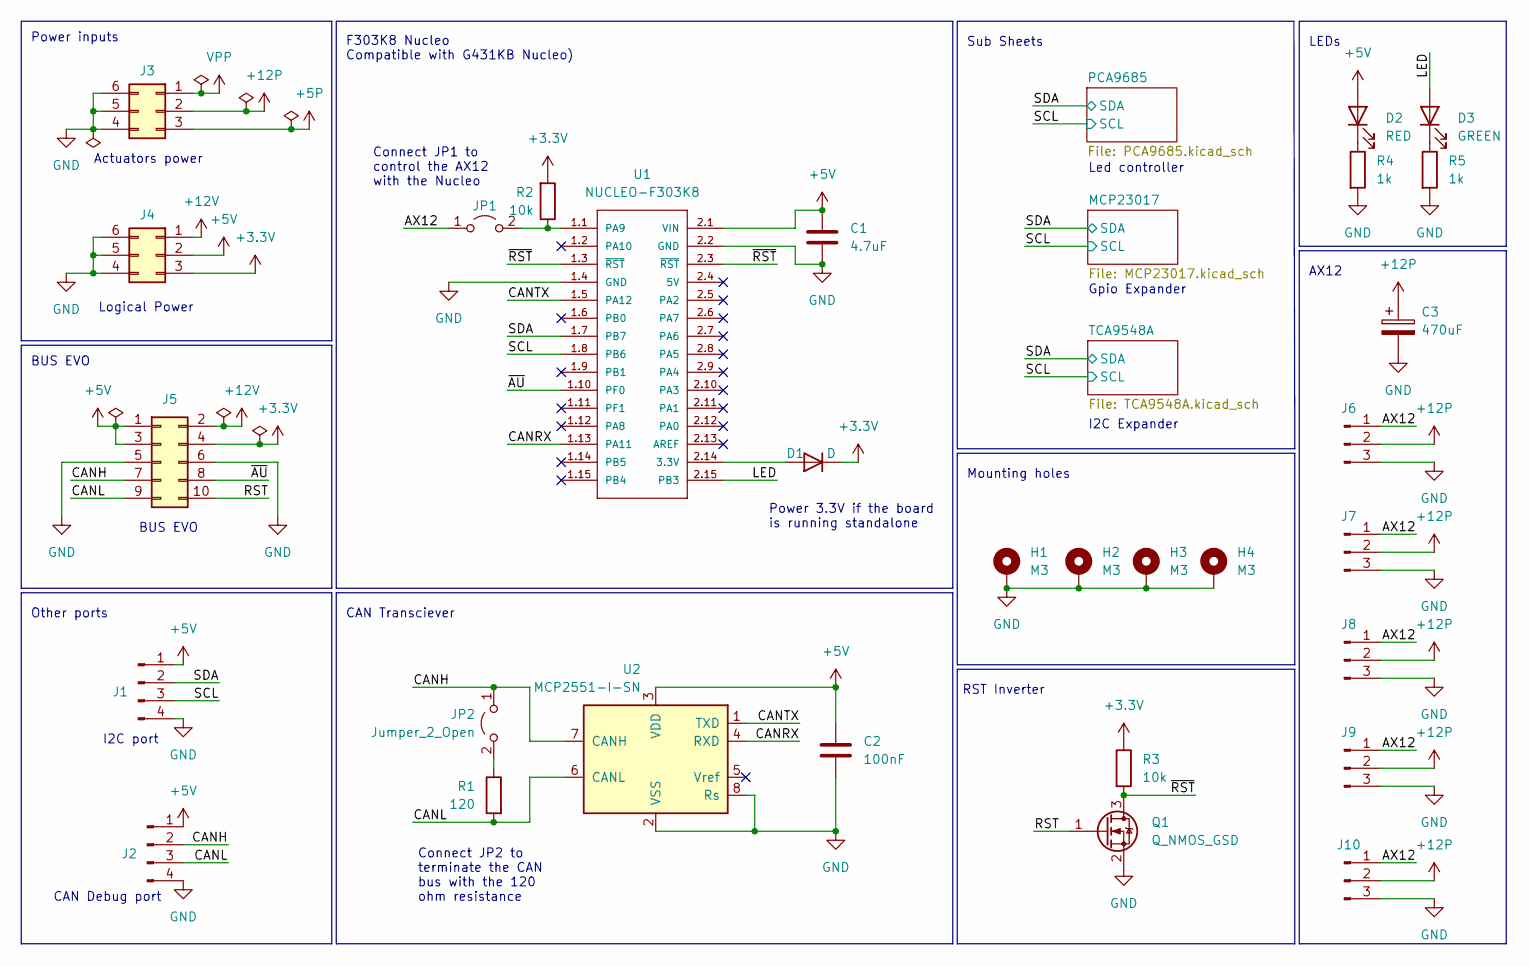
[picture p60: schematic V2.kicad_sch, Carte Actuators]

Parts:
C1: 4.7uF; C_0603_1608Metric
C2: 100nF; C_0603_1608Metric
C3: 470uF; CP_Radial_D10.0mm_P5.00mm
D1: D; D_SOD-523
D2: RED; LED_0805_2012Metric
D3: GREEN; LED_0805_2012Metric
H1, H2, H3, H4: M3; MountingHole_3.2mm_M3_Pad_Via
J1, J2: Conn_01x04_Male; B04B-PASK
J3, J4: Conn_02x03_Counter_Clockwise; 66200621122
J5: Conn_02x05_Odd_Even; 690367281076
J6, J7, J8, J9, J10: Conn_01x03_Male; 22-03-5035
JP1, JP2: Jumper_2_Open; PinHeader_1x02_P2.54mm_Vertical
Q1: Q_NMOS_GSD; SOT-23
R1: 120; R_0603_1608Metric
R2, R3: 10k; R_0603_1608Metric
R4, R5: 1k; R_0603_1608Metric
U1: NUCLEO-F303K8; MODULE_NUCLEO-F303K8
U2: MCP2551-I-SN; SOIC-8_3.9x4.9mm_P1.27mm

Connections:
+3.3V: D1.1 (K), J4.3, J5.4, R2.2, R3.1; also elsewhere on the board
+5P: J3.3; also elsewhere on the board
+5V: C1.1, C2.2, D2.2 (A), J1.1, J2.1, J4.2, J5.1, J5.3, U1.2.1 (VIN), U2.3 (VDD); also elsewhere on the board
+12P: C3.1, J3.2, J6.2, J7.2, J8.2, J9.2, J10.2; also elsewhere on the board
+12V: J4.1, J5.2; also elsewhere on the board
/AX12: J6.1, J7.1, J8.1, J9.1, J10.1, JP1.1 (A)
/CANH: J2.2, J5.7, JP2.1 (A), U2.7 (CANH)
/CANL: J2.3, J5.9, R1.2, U2.6 (CANL)
/CANRX: U1.1.13 (PA11), U2.4 (RXD)
/CANTX: U1.1.5 (PA12), U2.1 (TXD)
/LED: D3.2 (A), U1.2.15 (PB3)
/RST: J5.10, Q1.1 (G)
/SCL: J1.3, U1.1.8 (PB6); also elsewhere on the board
/SDA: J1.2, U1.1.7 (PB7); also elsewhere on the board
/~AU: J5.8, U1.1.10 (PF0)
/~RST: Q1.3 (D), R3.2, U1.1.3 (~RST), U1.2.3 (~RST)
GND: C1.2, C2.1, C3.2, H1.1, H2.1, H3.1, H4.1, J1.4, J2.4, J3.4, J3.5, J3.6, J4.4, J4.5, J4.6, J5.5, J5.6, J6.3, J7.3, J8.3, J9.3, J10.3, Q1.2 (S), R4.2, R5.2, U1.1.4 (GND), U1.2.2 (GND), U2.2 (VSS), U2.8 (Rs); also elsewhere on the board
unnamed: D1.2 (A), U1.2.14 (3.3V)
unnamed: D2.1 (K), R4.1
unnamed: D3.1 (K), R5.1
unnamed: JP1.2 (B), R2.1, U1.1.1 (PA9)
unnamed: JP2.2 (B), R1.1
VPP: J3.1; also elsewhere on the board

Notes on the sheet:
CAN Debug port
Sub Sheets
BUS EVO
Connect JP1 to control the AX12 with the Nucleo
CAN Transciever
Power inputs
Actuators power
I2C Expander
Gpio Expander
RST Inverter
AX12
Led controller
Connect JP2 to terminate the CAN bus with the 120 ohm resistance
I2C port
Power 3.3V if the board is running standalone
Mounting holes
F303K8 Nucleo Compatible with G431KB Nucleo)
LEDs
Logical Power
Other ports

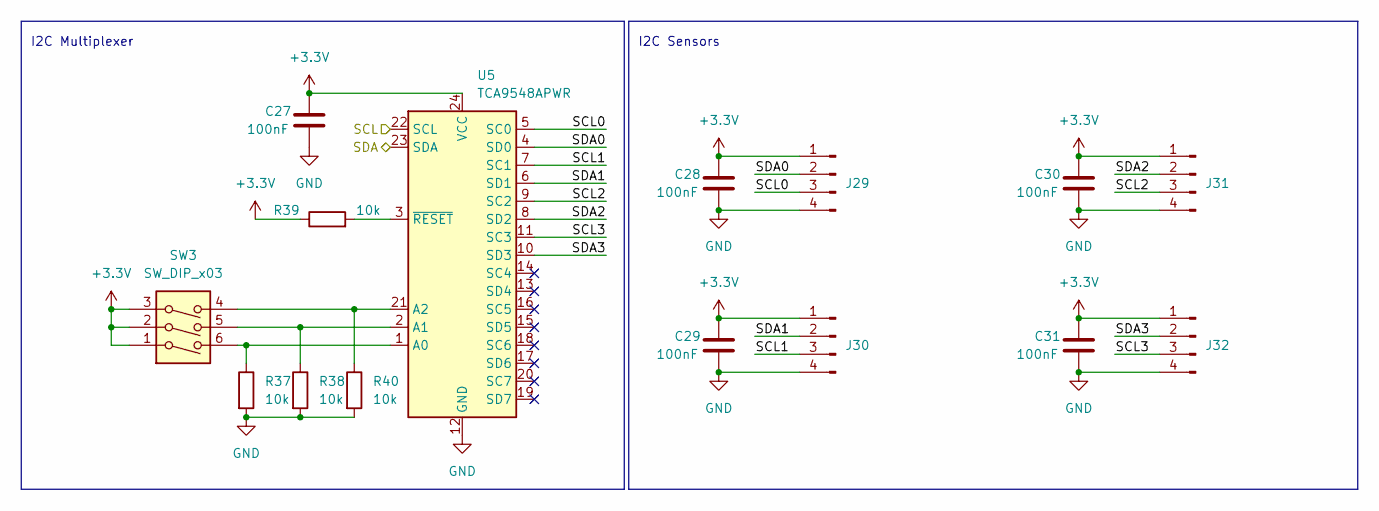
[picture p61: schematic TCA9548A.kicad_sch, Carte Actuators]

Parts:
C27, C28, C29, C30, C31: 100nF; C_0603_1608Metric
J29, J30, J31, J32: Conn_01x04_Male; B04B-PASK
R37, R38, R39, R40: 10k; R_0603_1608Metric
SW3: SW_DIP_x03; SW_DIP_SPSTx03_Slide_KingTek_DSHP03TS_W7.62mm_P1.27mm
U5: TCA9548APWR; TSSOP-24_4.4x7.8mm_P0.65mm

Connections:
+3.3V: C27.1, C28.1, C29.1, C30.1, C31.1, J29.1, J30.1, J31.1, J32.1, R39.1, SW3.1, SW3.2, SW3.3, U5.24 (VCC); also elsewhere on the board
/SCL: U5.22 (SCL); also elsewhere on the board
/SDA: U5.23 (SDA); also elsewhere on the board
/TCA9548A/SCL0: J29.3, U5.5 (SC0)
/TCA9548A/SCL1: J30.3, U5.7 (SC1)
/TCA9548A/SCL2: J31.3, U5.9 (SC2)
/TCA9548A/SCL3: J32.3, U5.11 (SC3)
/TCA9548A/SDA0: J29.2, U5.4 (SD0)
/TCA9548A/SDA1: J30.2, U5.6 (SD1)
/TCA9548A/SDA2: J31.2, U5.8 (SD2)
/TCA9548A/SDA3: J32.2, U5.10 (SD3)
GND: C27.2, C28.2, C29.2, C30.2, C31.2, J29.4, J30.4, J31.4, J32.4, R37.2, R38.2, R40.2, U5.12 (GND); also elsewhere on the board
unnamed: R37.1, SW3.6, U5.1 (A0)
unnamed: R38.1, SW3.5, U5.2 (A1)
unnamed: R39.2, U5.3 (~RESET)
unnamed: R40.1, SW3.4, U5.21 (A2)

Notes on the sheet:
I2C Multiplexer
I2C Sensors

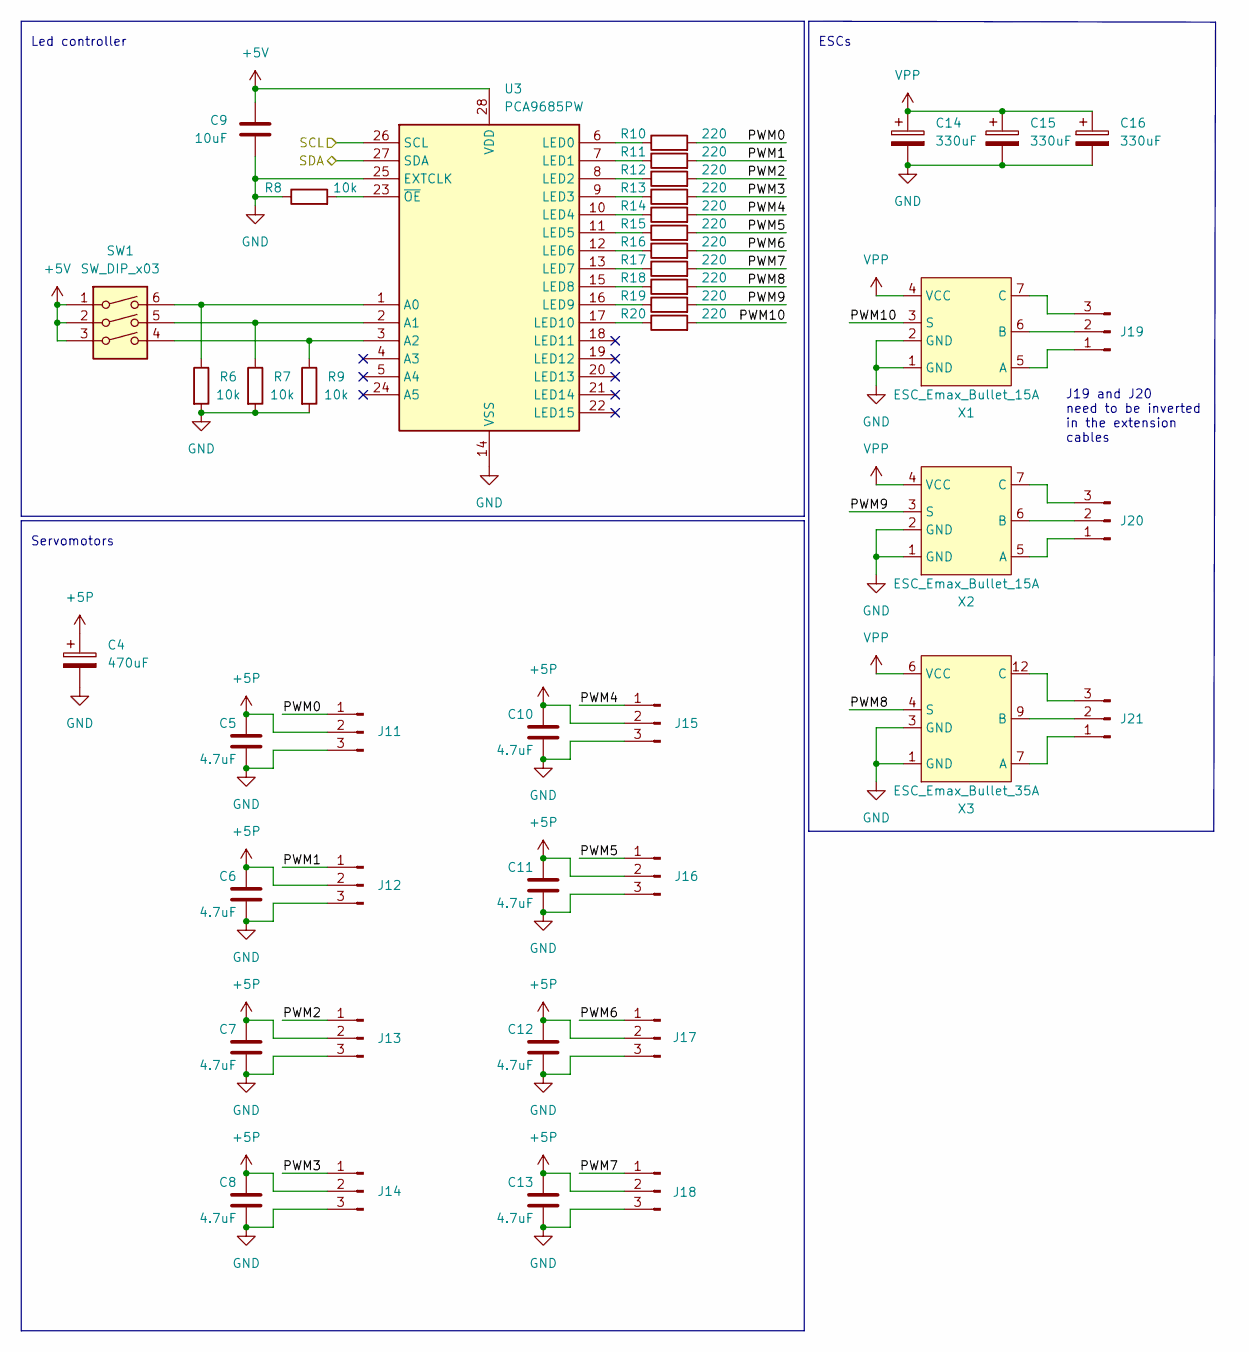
[picture p62: schematic PCA9685.kicad_sch, Carte Actuators]

Parts:
C4: 470uF; CP_Radial_D10.0mm_P5.00mm
C5, C6, C7, C8, C10, C11, C12, C13: 4.7uF; C_0603_1608Metric
C9: 10uF; C_0603_1608Metric
C14, C15, C16: 330uF; CP_Radial_D10.0mm_P5.00mm
J11, J12, J13, J14, J15, J16, J17, J18: Conn_01x03_Male; PinHeader_1x03_P2.54mm_Vertical
J19, J20, J21: Conn_01x03_Male; 64900311122
R6, R7, R8, R9: 10k; R_0603_1608Metric
R10, R11, R12, R13, R14, R15, R16, R17, R18, R19, R20: 220; R_0603_1608Metric
SW1: SW_DIP_x03; SW_DIP_SPSTx03_Slide_KingTek_DSHP03TS_W7.62mm_P1.27mm
U3: PCA9685PW; TSSOP-28_4.4x9.7mm_P0.65mm
X1, X2: ESC_Emax_Bullet_15A
X3: ESC_Emax_Bullet_35A

Connections:
+5P: C4.1, C5.1, C6.1, C7.1, C8.1, C10.1, C11.1, C12.1, C13.1, J11.2, J12.2, J13.2, J14.2, J15.2, J16.2, J17.2, J18.2; also elsewhere on the board
+5V: C9.2, SW1.1, SW1.2, SW1.3, U3.28 (VDD); also elsewhere on the board
/PCA9685/PWM0: J11.1, R10.2
/PCA9685/PWM1: J12.1, R11.2
/PCA9685/PWM2: J13.1, R12.2
/PCA9685/PWM3: J14.1, R13.2
/PCA9685/PWM4: J15.1, R14.2
/PCA9685/PWM5: J16.1, R15.2
/PCA9685/PWM6: J17.1, R16.2
/PCA9685/PWM7: J18.1, R17.2
/PCA9685/PWM8: R18.2, X3.4 (S)
/PCA9685/PWM9: R19.2, X2.3 (S)
/PCA9685/PWM10: R20.2, X1.3 (S)
/SCL: U3.26 (SCL); also elsewhere on the board
/SDA: U3.27 (SDA); also elsewhere on the board
GND: C4.2, C5.2, C6.2, C7.2, C8.2, C9.1, C10.2, C11.2, C12.2, C13.2, C14.2, C15.2, C16.2, J11.3, J12.3, J13.3, J14.3, J15.3, J16.3, J17.3, J18.3, R6.2, R7.2, R8.1, R9.2, U3.14 (VSS), U3.25 (EXTCLK), X1.1 (GND), X1.2 (GND), X2.1 (GND), X2.2 (GND), X3.1 (GND), X3.2 (GND), X3.3 (GND); also elsewhere on the board
unnamed: J20.1, X2.5 (A)
unnamed: J20.2, X2.6 (B)
unnamed: J20.3, X2.7 (C)
unnamed: J21.1, X3.7 (A), X3.8 (A)
unnamed: J21.2, X3.9 (B), X3.10 (B)
unnamed: J21.3, X3.11 (C), X3.12 (C)
unnamed: R6.1, SW1.6, U3.1 (A0)
unnamed: R7.1, SW1.5, U3.2 (A1)
unnamed: R8.2, U3.23 (~OE)
unnamed: R9.1, SW1.4, U3.3 (A2)
unnamed: R10.1, U3.6 (LED0)
unnamed: R11.1, U3.7 (LED1)
unnamed: R12.1, U3.8 (LED2)
unnamed: R13.1, U3.9 (LED3)
unnamed: R14.1, U3.10 (LED4)
unnamed: R15.1, U3.11 (LED5)
unnamed: R16.1, U3.12 (LED6)
unnamed: R17.1, U3.13 (LED7)
unnamed: R18.1, U3.15 (LED8)
unnamed: R19.1, U3.16 (LED9)
unnamed: R20.1, U3.17 (LED10)
unnamed: J19.1, X1.5 (A)
unnamed: J19.2, X1.6 (B)
unnamed: J19.3, X1.7 (C)
VPP: C14.1, C15.1, C16.1, X1.4 (VCC), X2.4 (VCC), X3.5 (VCC), X3.6 (VCC); also elsewhere on the board

Notes on the sheet:
ESCs
J19 and J20 need to be inverted in the extension cables
Led controller
Servomotors

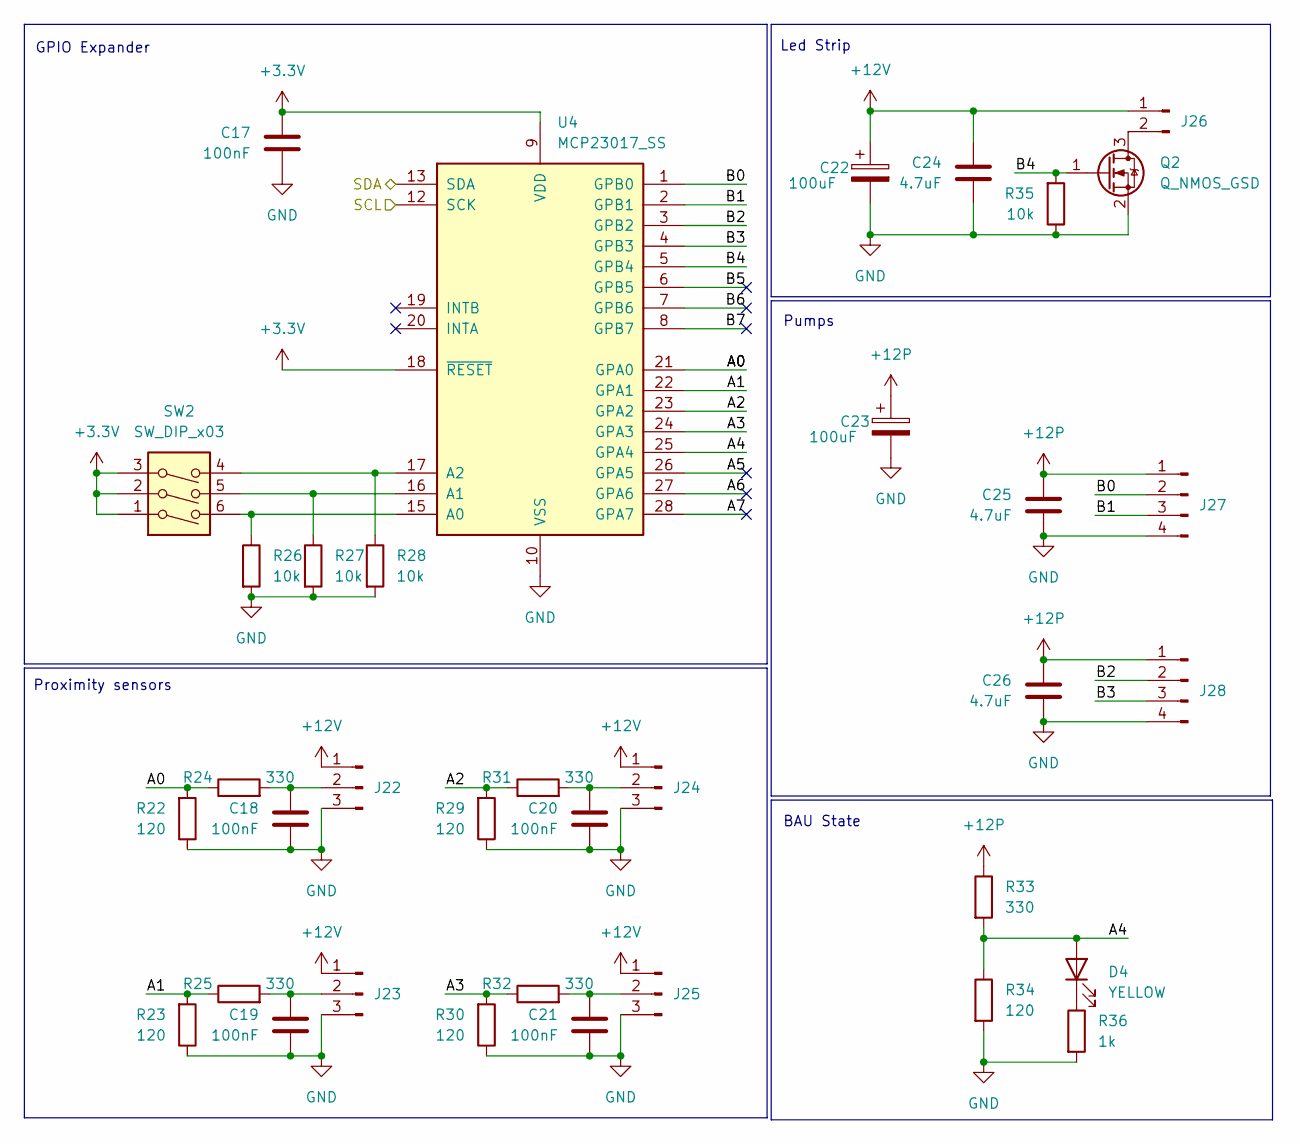
[picture p63: schematic MCP23017.kicad_sch, Carte Actuators]

Parts:
C17, C18, C19, C20, C21: 100nF; C_0603_1608Metric
C22, C23: 100uF; CP_Elec_6.3x7.7
C24, C25, C26: 4.7uF; C_0603_1608Metric
D4: YELLOW; LED_0805_2012Metric
J22, J23, J24, J25: Conn_01x03_Male; B03B-PASK
J26: Conn_01x02_Male; 66200221122
J27, J28: Conn_01x04_Male; B04B-PASK
Q2: Q_NMOS_GSD; SOT-23
R22, R23, R29, R30, R34: 120; R_0603_1608Metric
R24, R25, R31, R32, R33: 330; R_0603_1608Metric
R26, R27, R28, R35: 10k; R_0603_1608Metric
R36: 1k; R_0603_1608Metric
SW2: SW_DIP_x03; SW_DIP_SPSTx03_Slide_KingTek_DSHP03TS_W7.62mm_P1.27mm
U4: MCP23017_SS; SSOP-28_5.3x10.2mm_P0.65mm

Connections:
+3.3V: C17.2, SW2.1, SW2.2, SW2.3, U4.9 (VDD), U4.18 (~RESET); also elsewhere on the board
+12P: C23.1, C25.2, C26.2, J27.1, J28.1, R33.1; also elsewhere on the board
+12V: C22.1, C24.2, J22.1, J23.1, J24.1, J25.1, J26.1; also elsewhere on the board
/MCP23017/A0: R22.2, R24.1, U4.21 (GPA0)
/MCP23017/A1: R23.2, R25.1, U4.22 (GPA1)
/MCP23017/A2: R29.2, R31.1, U4.23 (GPA2)
/MCP23017/A3: R30.2, R32.1, U4.24 (GPA3)
/MCP23017/A4: D4.2 (A), R33.2, R34.1, U4.25 (GPA4)
/MCP23017/A5: U4.26 (GPA5)
/MCP23017/A6: U4.27 (GPA6)
/MCP23017/A7: U4.28 (GPA7)
/MCP23017/B0: J27.2, U4.1 (GPB0)
/MCP23017/B1: J27.3, U4.2 (GPB1)
/MCP23017/B2: J28.2, U4.3 (GPB2)
/MCP23017/B3: J28.3, U4.4 (GPB3)
/MCP23017/B4: Q2.1 (G), R35.2, U4.5 (GPB4)
/MCP23017/B5: U4.6 (GPB5)
/MCP23017/B6: U4.7 (GPB6)
/MCP23017/B7: U4.8 (GPB7)
/SCL: U4.12 (SCK); also elsewhere on the board
/SDA: U4.13 (SDA); also elsewhere on the board
GND: C17.1, C18.1, C19.1, C20.1, C21.1, C22.2, C23.2, C24.1, C25.1, C26.1, J22.3, J23.3, J24.3, J25.3, J27.4, J28.4, Q2.2 (S), R22.1, R23.1, R26.2, R27.2, R28.2, R29.1, R30.1, R34.2, R35.1, R36.2, U4.10 (VSS); also elsewhere on the board
unnamed: C18.2, J22.2, R24.2
unnamed: C19.2, J23.2, R25.2
unnamed: C20.2, J24.2, R31.2
unnamed: C21.2, J25.2, R32.2
unnamed: D4.1 (K), R36.1
unnamed: J26.2, Q2.3 (D)
unnamed: R26.1, SW2.6, U4.15 (A0)
unnamed: R27.1, SW2.5, U4.16 (A1)
unnamed: R28.1, SW2.4, U4.17 (A2)

Notes on the sheet:
BAU State
GPIO Expander
Led Strip
Pumps
Proximity sensors

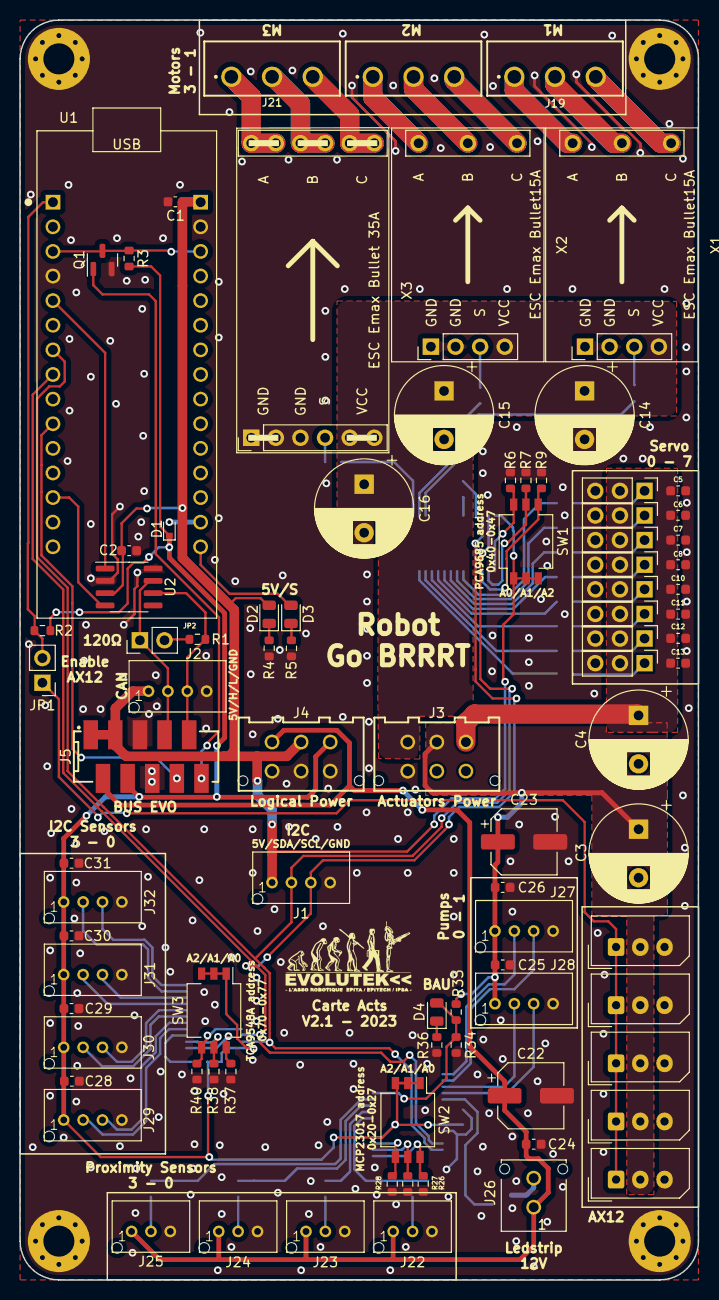
[picture p64: board V2.kicad_pcb from above]

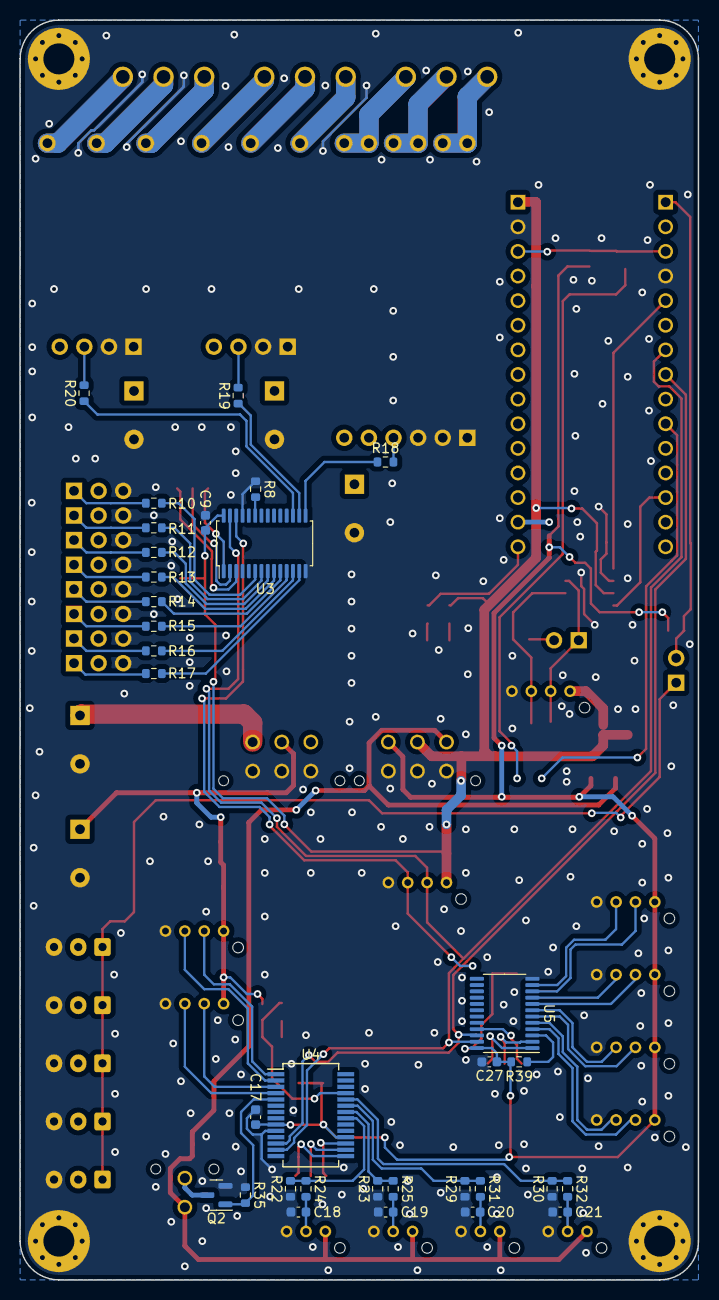
[picture p65: board V2.kicad_pcb from below]

Board: 2 copper layers, 70.0 x 130.0 mm, 125 parts (33 on the bottom side), 89 nets.
