evolutek/carte-actionneurs/CarteRallongeActionneurs2022/CarteRallongeActionneurs2022.kicad_pcb

## KiCad design CarteRallongeActionneurs2022/CarteRallongeActionneurs2022.kicad_pcb (2022-05-01)

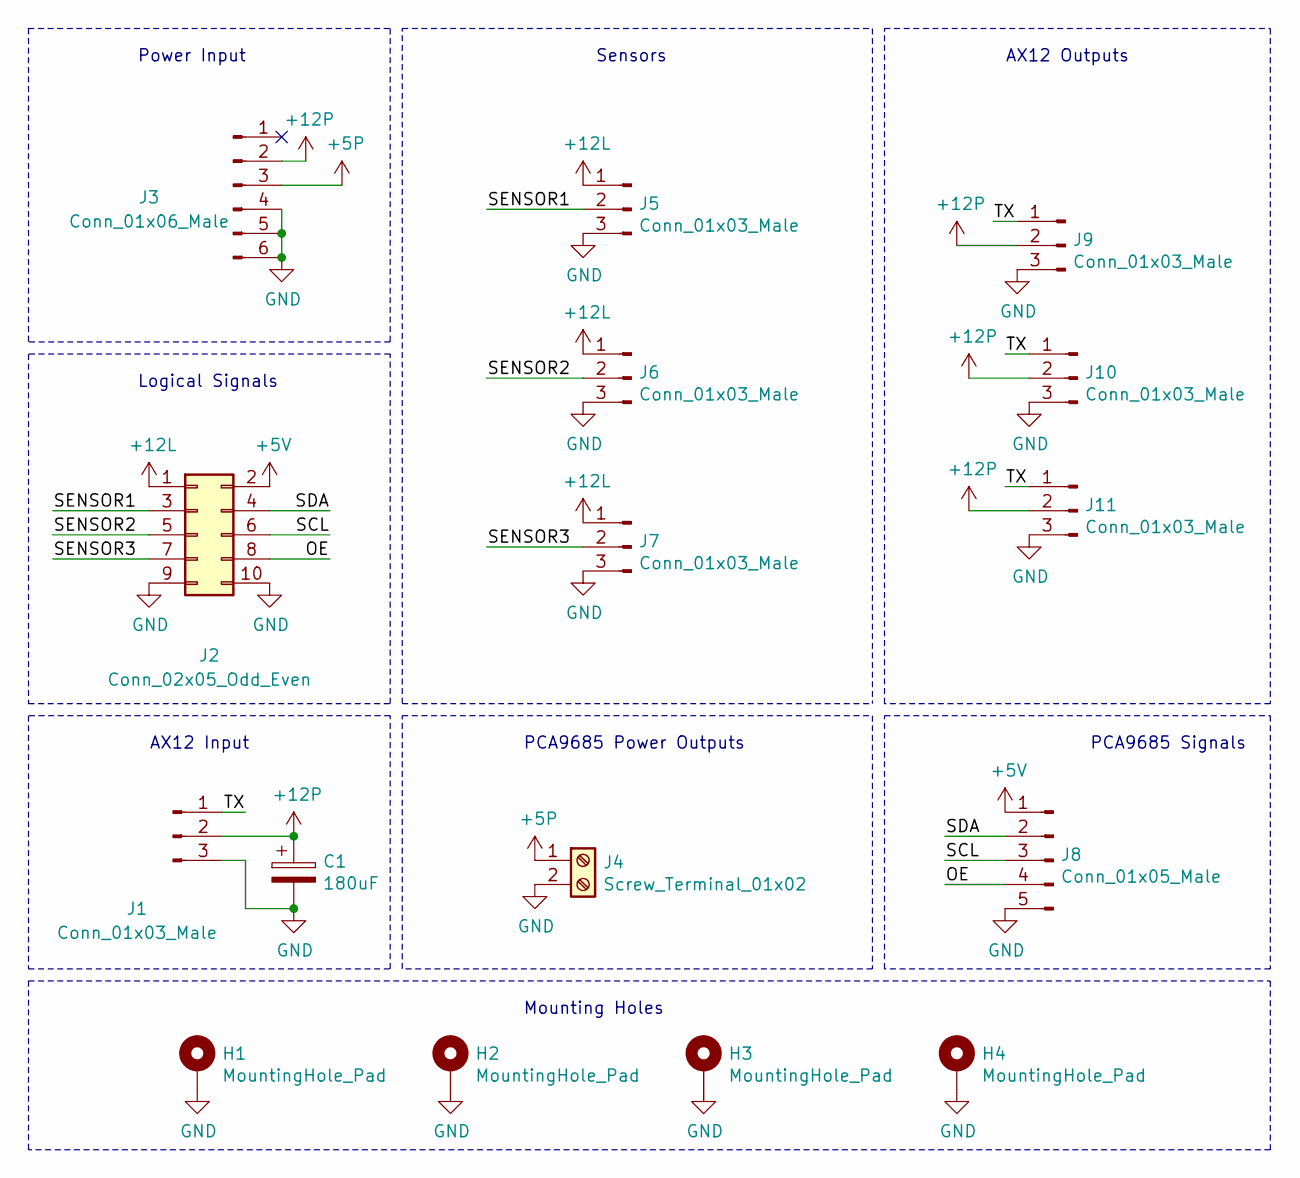
[picture p66: schematic CarteRallongeActionneurs2022.sch, Carte Rallonge Actionneurs 2022]

Parts:
C1: 180uF; CP_Radial_D10.0mm_P5.00mm
H1, H2, H3, H4: MountingHole_Pad; MountingHole_3.2mm_M3_Pad_Via
J1, J9, J10, J11: Conn_01x03_Male; 22-03-5035
J2: Conn_02x05_Odd_Even; 690367181072
J3: Conn_01x06_Male; 66200621122
J4: Screw_Terminal_01x02; TerminalBlock_Phoenix_MKDS-1,5-2_1x02_P5.00mm_Horizontal
J5, J6, J7: Conn_01x03_Male; B03B-PASK
J8: Conn_01x05_Male; PinHeader_1x05_P2.54mm_Vertical

Connections:
+5P: J3.3, J4.1
+5V: J2.2, J8.1
+12L: J2.1, J5.1, J6.1, J7.1
+12P: C1.1, J1.2, J3.2, J9.2, J10.2, J11.2
/OE: J2.8, J8.4
/SCL: J2.6, J8.3
/SDA: J2.4, J8.2
/SENSOR1: J2.3, J5.2
/SENSOR2: J2.5, J6.2
/SENSOR3: J2.7, J7.2
/TX: J1.1, J9.1, J10.1, J11.1
GND: C1.2, H1.1, H2.1, H3.1, H4.1, J1.3, J2.9, J2.10, J3.4, J3.5, J3.6, J4.2, J5.3, J6.3, J7.3, J8.5, J9.3, J10.3, J11.3

Notes on the sheet:
Power Input
Logical Signals
AX12 Input
Sensors
PCA9685 Power Outputs
PCA9685 Signals
AX12 Outputs
Mounting Holes

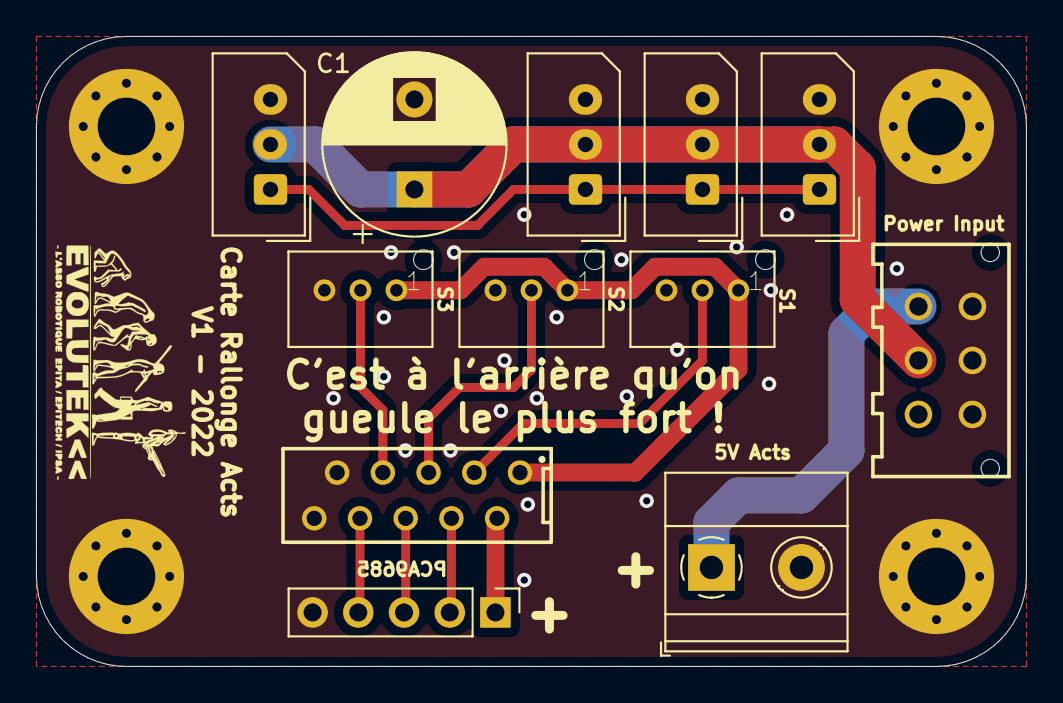
[picture p67: board CarteRallongeActionneurs2022.kicad_pcb from above]

Board: 2 copper layers, 55.0 x 35.0 mm, 16 parts (0 on the bottom side), 12 nets.
