evolutek/carte-actionneurs/Carte Test Pont en H/Carte Test Pont en H.kicad_pcb

## KiCad design Carte Test Pont en H/Carte Test Pont en H.kicad_pcb (2021-12-27)

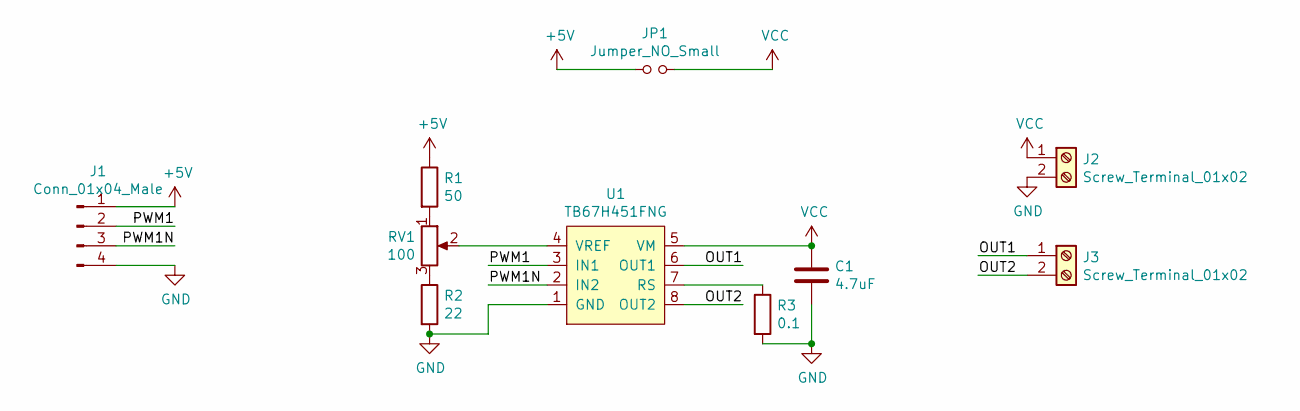
[picture p68: schematic Carte Test Pont en H.sch]

Parts:
C1: 4.7uF; C_0603_1608Metric
J1: Conn_01x04_Male; PinHeader_1x04_P2.54mm_Vertical
J2, J3: Screw_Terminal_01x02; TerminalBlock_Altech_AK300-2_P5.00mm
JP1: Jumper_NO_Small; PinHeader_1x02_P2.54mm_Vertical
R1: 50; R_0603_1608Metric
R2: 22; R_0603_1608Metric
R3: 0.1; R_0603_1608Metric
RV1: 100; Potentiometer_Bourns_3314J_Vertical
U1: TB67H451FNG; HSOP-8-1EP_3.9x4.9mm_P1.27mm_EP2.41x3.1mm_ThermalVias

Connections:
+5V: J1.1, JP1.1, R1.1
/OUT1: J3.1, U1.6 (OUT1)
/OUT2: J3.2, U1.8 (OUT2)
/PWM1: J1.2, U1.3 (IN1)
/PWM1N: J1.3, U1.2 (IN2)
GND: C1.2, J1.4, J2.2, R2.2, R3.2, U1.1 (GND)
unnamed: R1.2, RV1.1
unnamed: R2.1, RV1.3
unnamed: R3.1, U1.7 (RS)
unnamed: RV1.2, U1.4 (VREF)
VCC: C1.1, J2.1, JP1.2, U1.5 (VM)

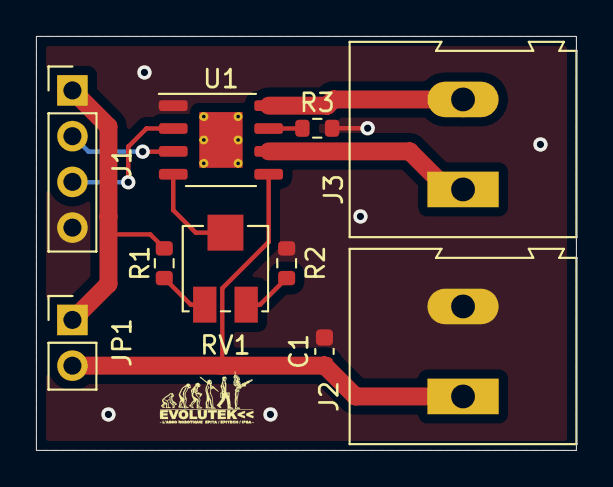
[picture p69: board Carte Test Pont en H.kicad_pcb from above]

Board: 2 copper layers, 30.0 x 23.0 mm, 10 parts (0 on the bottom side), 11 nets.
