evolutek/carte-actionneurs/V1/Carte Actionneurs.kicad_pcb

## KiCad design V1/Carte Actionneurs.kicad_pcb (2021-05-02, an earlier design)

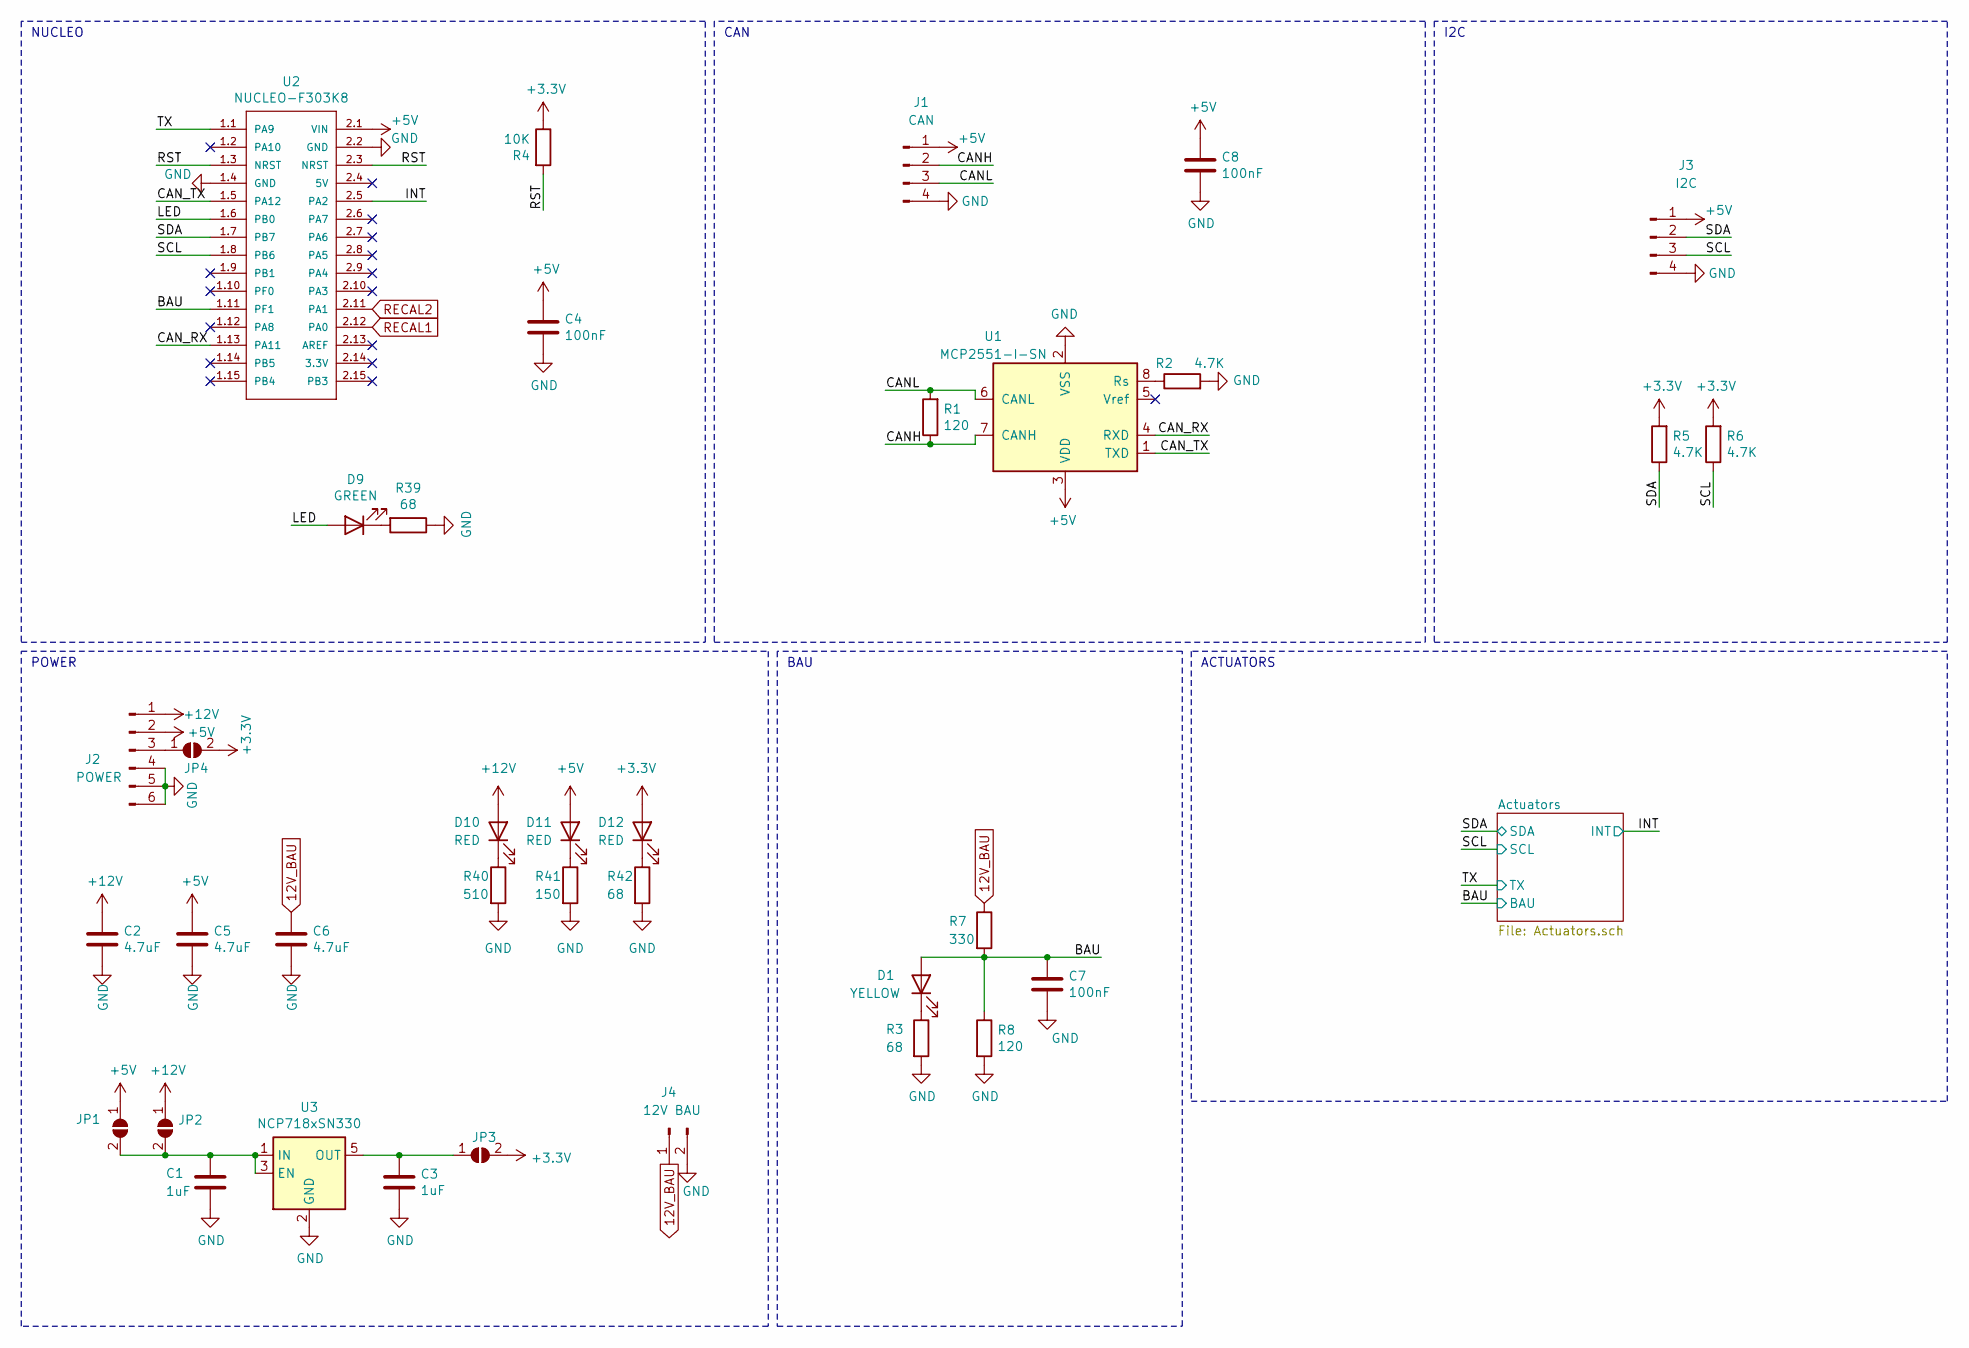
[picture p70: schematic Carte Actionneurs.sch]

Parts:
C1, C3: 1uF; C_0603_1608Metric
C2, C5, C6: 4.7uF; C_0603_1608Metric
C4, C7, C8: 100nF; C_0603_1608Metric
D1: YELLOW; LED_0805_2012Metric
D9: GREEN; LED_0805_2012Metric
D10, D11, D12: RED; LED_0805_2012Metric
J1: CAN; B04B-PASK
J2: POWER; 66200621022
J3: I2C; B04B-PASK
J4: 12V BAU; 649002227222
JP1, JP2, JP3, JP4: SolderJumper_2_Open; SolderJumper-2_P1.3mm_Open_TrianglePad1.0x1.5mm
R1, R8: 120; R_0603_1608Metric
R2, R5, R6: 4.7K; R_0603_1608Metric
R3, R39, R42: 68; R_0603_1608Metric
R4: 10K; R_0603_1608Metric
R7: 330; R_0603_1608Metric
R40: 510; R_0603_1608Metric
R41: 150; R_0603_1608Metric
U1: MCP2551-I-SN; SOIC-8_3.9x4.9mm_P1.27mm
U2: NUCLEO-F303K8; MODULE_NUCLEO-F303K8
U3: NCP718xSN330; SOT-23-5

Connections:
12V_BAU: C6.1, J4.1, R7.1; also elsewhere on the board
+3V3: D12.2 (A), JP3.2 (B), JP4.2 (B), R4.1, R5.2, R6.2; also elsewhere on the board
+5V: C4.1, C5.1, C8.1, D11.2 (A), J1.1, J2.2, J3.1, JP1.1 (A), U1.3 (VDD), U2.2.1 (VIN)
+12V: C2.1, D10.2 (A), J2.1, JP2.1 (A); also elsewhere on the board
/BAU: C7.1, D1.2 (A), R7.2, R8.1, U2.1.11 (PF1); also elsewhere on the board
/CANH: J1.2, R1.1, U1.7 (CANH)
/CANL: J1.3, R1.2, U1.6 (CANL)
/CAN_RX: U1.4 (RXD), U2.1.13 (PA11)
/CAN_TX: U1.1 (TXD), U2.1.5 (PA12)
/INT: U2.2.5 (PA2); also elsewhere on the board
/LED: D9.2 (A), U2.1.6 (PB0)
/RST: R4.2, U2.1.3 (NRST), U2.2.3 (NRST)
/SCL: J3.3, R6.1, U2.1.8 (PB6); also elsewhere on the board
/SDA: J3.2, R5.1, U2.1.7 (PB7); also elsewhere on the board
/TX: U2.1.1 (PA9); also elsewhere on the board
GND: C1.2, C2.2, C3.2, C4.2, C5.2, C6.2, C7.2, C8.2, J1.4, J2.4, J2.5, J2.6, J3.4, J4.2, R2.2, R3.2, R8.2, R39.1, R40.2, R41.2, R42.2, U1.2 (VSS), U2.1.4 (GND), U2.2.2 (GND), U3.2 (GND); also elsewhere on the board
unnamed: C1.1, JP1.2 (B), JP2.2 (B), U3.1 (IN), U3.3 (EN)
unnamed: C3.1, JP3.1 (A), U3.5 (OUT)
unnamed: D1.1 (K), R3.1
unnamed: D9.1 (K), R39.2
unnamed: D10.1 (K), R40.1
unnamed: D11.1 (K), R41.1
unnamed: D12.1 (K), R42.1
unnamed: J2.3, JP4.1 (A)
unnamed: R2.1, U1.8 (Rs)
RECAL1: U2.2.12 (PA0); also elsewhere on the board
RECAL2: U2.2.11 (PA1); also elsewhere on the board

Notes on the sheet:
I2C
CAN
NUCLEO
POWER
ACTUATORS
BAU
