evolutek/carte-actionneurs/V1/Carte Actionneurs.kicad_pcb

## KiCad design V1/Carte Actionneurs.kicad_pcb (continued)

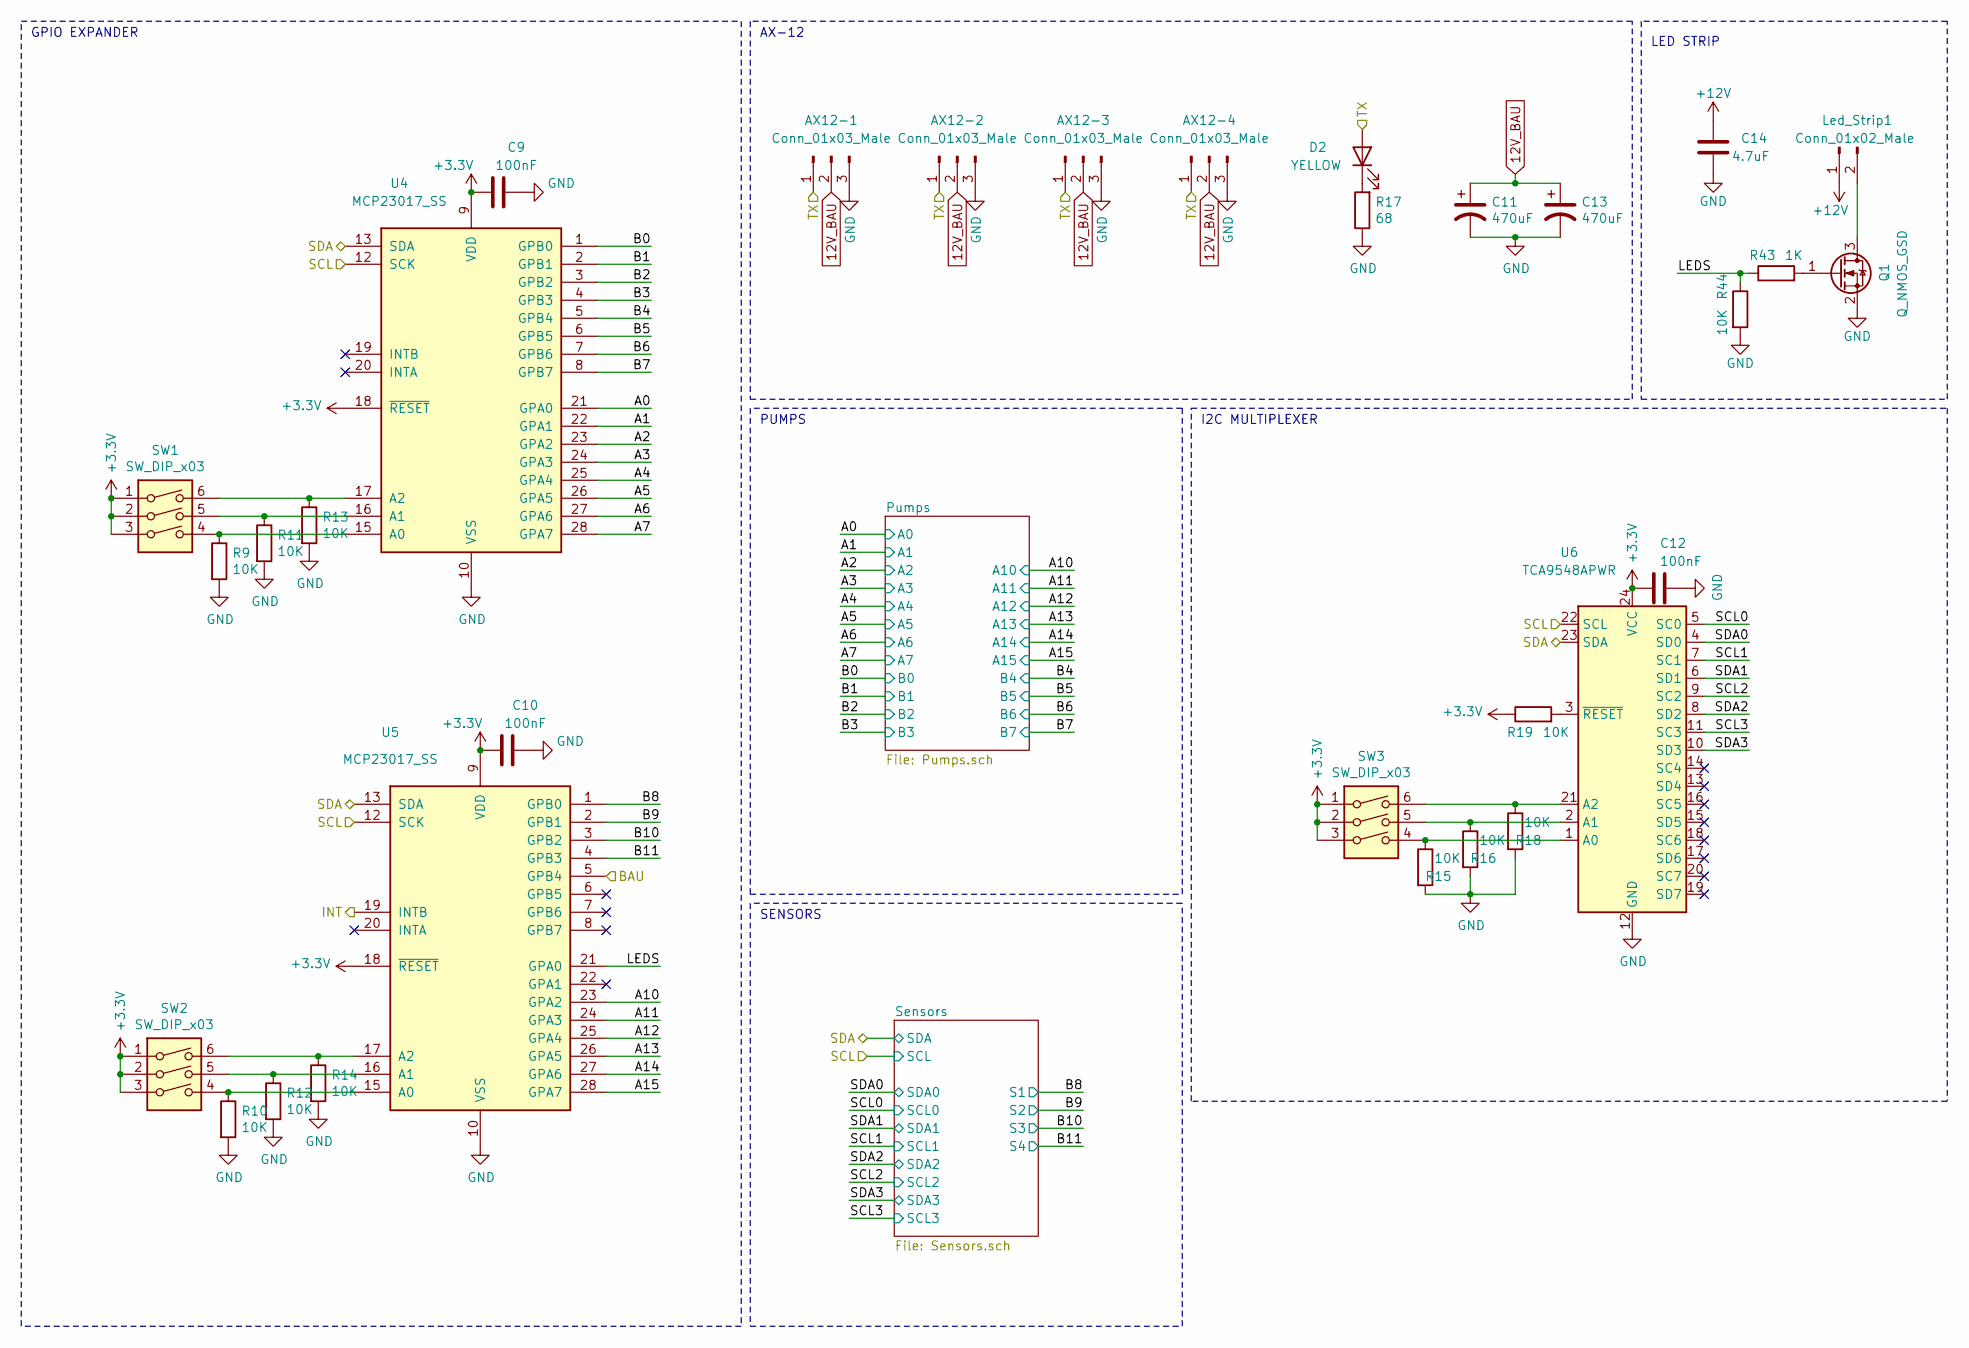
[picture p71: schematic Actuators.sch, Carte Actionneurs]

Parts:
AX12-1, AX12-2, AX12-3, AX12-4: Conn_01x03_Male; 22-03-5035
C9, C10, C12: 100nF; C_0603_1608Metric
C11, C13: 470uF; CP_Radial_D10.0mm_P5.00mm
C14: 4.7uF; C_0603_1608Metric
D2: YELLOW; LED_0805_2012Metric
Led_Strip1: Conn_01x02_Male; B02B-PASK
Q1: Q_NMOS_GSD; SOT-23
R9, R10, R11, R12, R13, R14, R15, R16, R18, R19, R44: 10K; R_0603_1608Metric
R17: 68; R_0603_1608Metric
R43: 1K; R_0603_1608Metric
SW1, SW2, SW3: SW_DIP_x03; SW_DIP_SPSTx03_Slide_6.7x9.18mm_W7.62mm_P2.54mm_LowProfile
U4, U5: MCP23017_SS; SSOP-28_5.3x10.2mm_P0.65mm
U6: TCA9548APWR; TSSOP-24_4.4x7.8mm_P0.65mm

Connections:
12V_BAU: AX12-1.2, AX12-2.2, AX12-3.2, AX12-4.2, C11.1, C13.1; also elsewhere on the board
+3V3: C9.2, C10.2, C12.1, R19.1, SW1.1, SW1.2, SW1.3, SW2.1, SW2.2, SW2.3, SW3.1, SW3.2, SW3.3, U4.9 (VDD), U4.18 (~RESET~), U5.9 (VDD), U5.18 (~RESET~), U6.24 (VCC); also elsewhere on the board
+12V: C14.1, Led_Strip1.1; also elsewhere on the board
/Actuators/A0: U4.21 (GPA0); also elsewhere on the board
/Actuators/A1: U4.22 (GPA1); also elsewhere on the board
/Actuators/A2: U4.23 (GPA2); also elsewhere on the board
/Actuators/A3: U4.24 (GPA3); also elsewhere on the board
/Actuators/A4: U4.25 (GPA4); also elsewhere on the board
/Actuators/A5: U4.26 (GPA5); also elsewhere on the board
/Actuators/A6: U4.27 (GPA6); also elsewhere on the board
/Actuators/A7: U4.28 (GPA7); also elsewhere on the board
/Actuators/A10: U5.23 (GPA2); also elsewhere on the board
/Actuators/A11: U5.24 (GPA3); also elsewhere on the board
/Actuators/A12: U5.25 (GPA4); also elsewhere on the board
/Actuators/A13: U5.26 (GPA5); also elsewhere on the board
/Actuators/A14: U5.27 (GPA6); also elsewhere on the board
/Actuators/A15: U5.28 (GPA7); also elsewhere on the board
/Actuators/B0: U4.1 (GPB0); also elsewhere on the board
/Actuators/B1: U4.2 (GPB1); also elsewhere on the board
/Actuators/B2: U4.3 (GPB2); also elsewhere on the board
/Actuators/B3: U4.4 (GPB3); also elsewhere on the board
/Actuators/B4: U4.5 (GPB4); also elsewhere on the board
/Actuators/B5: U4.6 (GPB5); also elsewhere on the board
/Actuators/B6: U4.7 (GPB6); also elsewhere on the board
/Actuators/B7: U4.8 (GPB7); also elsewhere on the board
/Actuators/B8: U5.1 (GPB0); also elsewhere on the board
/Actuators/B9: U5.2 (GPB1); also elsewhere on the board
/Actuators/B10: U5.3 (GPB2); also elsewhere on the board
/Actuators/B11: U5.4 (GPB3); also elsewhere on the board
/Actuators/LEDS: R43.1, R44.1, U5.21 (GPA0)
/Actuators/SCL0: U6.5 (SC0); also elsewhere on the board
/Actuators/SCL1: U6.7 (SC1); also elsewhere on the board
/Actuators/SCL2: U6.9 (SC2); also elsewhere on the board
/Actuators/SCL3: U6.11 (SC3); also elsewhere on the board
/Actuators/SDA0: U6.4 (SD0); also elsewhere on the board
/Actuators/SDA1: U6.6 (SD1); also elsewhere on the board
/Actuators/SDA2: U6.8 (SD2); also elsewhere on the board
/Actuators/SDA3: U6.10 (SD3); also elsewhere on the board
/BAU: U5.5 (GPB4); also elsewhere on the board
/INT: U5.19 (INTB); also elsewhere on the board
/SCL: U4.12 (SCK), U5.12 (SCK), U6.22 (SCL); also elsewhere on the board
/SDA: U4.13 (SDA), U5.13 (SDA), U6.23 (SDA); also elsewhere on the board
/TX: AX12-1.1, AX12-2.1, AX12-3.1, AX12-4.1, D2.2 (A); also elsewhere on the board
GND: AX12-1.3, AX12-2.3, AX12-3.3, AX12-4.3, C9.1, C10.1, C11.2, C12.2, C13.2, C14.2, Q1.2 (S), R9.2, R10.2, R11.2, R12.2, R13.2, R14.2, R15.2, R16.2, R17.1, R18.2, R44.2, U4.10 (VSS), U5.10 (VSS), U6.12 (GND); also elsewhere on the board
unnamed: D2.1 (K), R17.2
unnamed: Led_Strip1.2, Q1.3 (D)
unnamed: Q1.1 (G), R43.2
unnamed: R9.1, SW1.4, U4.15 (A0)
unnamed: R10.1, SW2.4, U5.15 (A0)
unnamed: R11.1, SW1.5, U4.16 (A1)
unnamed: R12.1, SW2.5, U5.16 (A1)
unnamed: R13.1, SW1.6, U4.17 (A2)
unnamed: R14.1, SW2.6, U5.17 (A2)
unnamed: R15.1, SW3.4, U6.1 (A0)
unnamed: R16.1, SW3.5, U6.2 (A1)
unnamed: R18.1, SW3.6, U6.21 (A2)
unnamed: R19.2, U6.3 (~RESET)

Notes on the sheet:
GPIO EXPANDER
I2C MULTIPLEXER
AX-12
SENSORS
PUMPS
LED STRIP

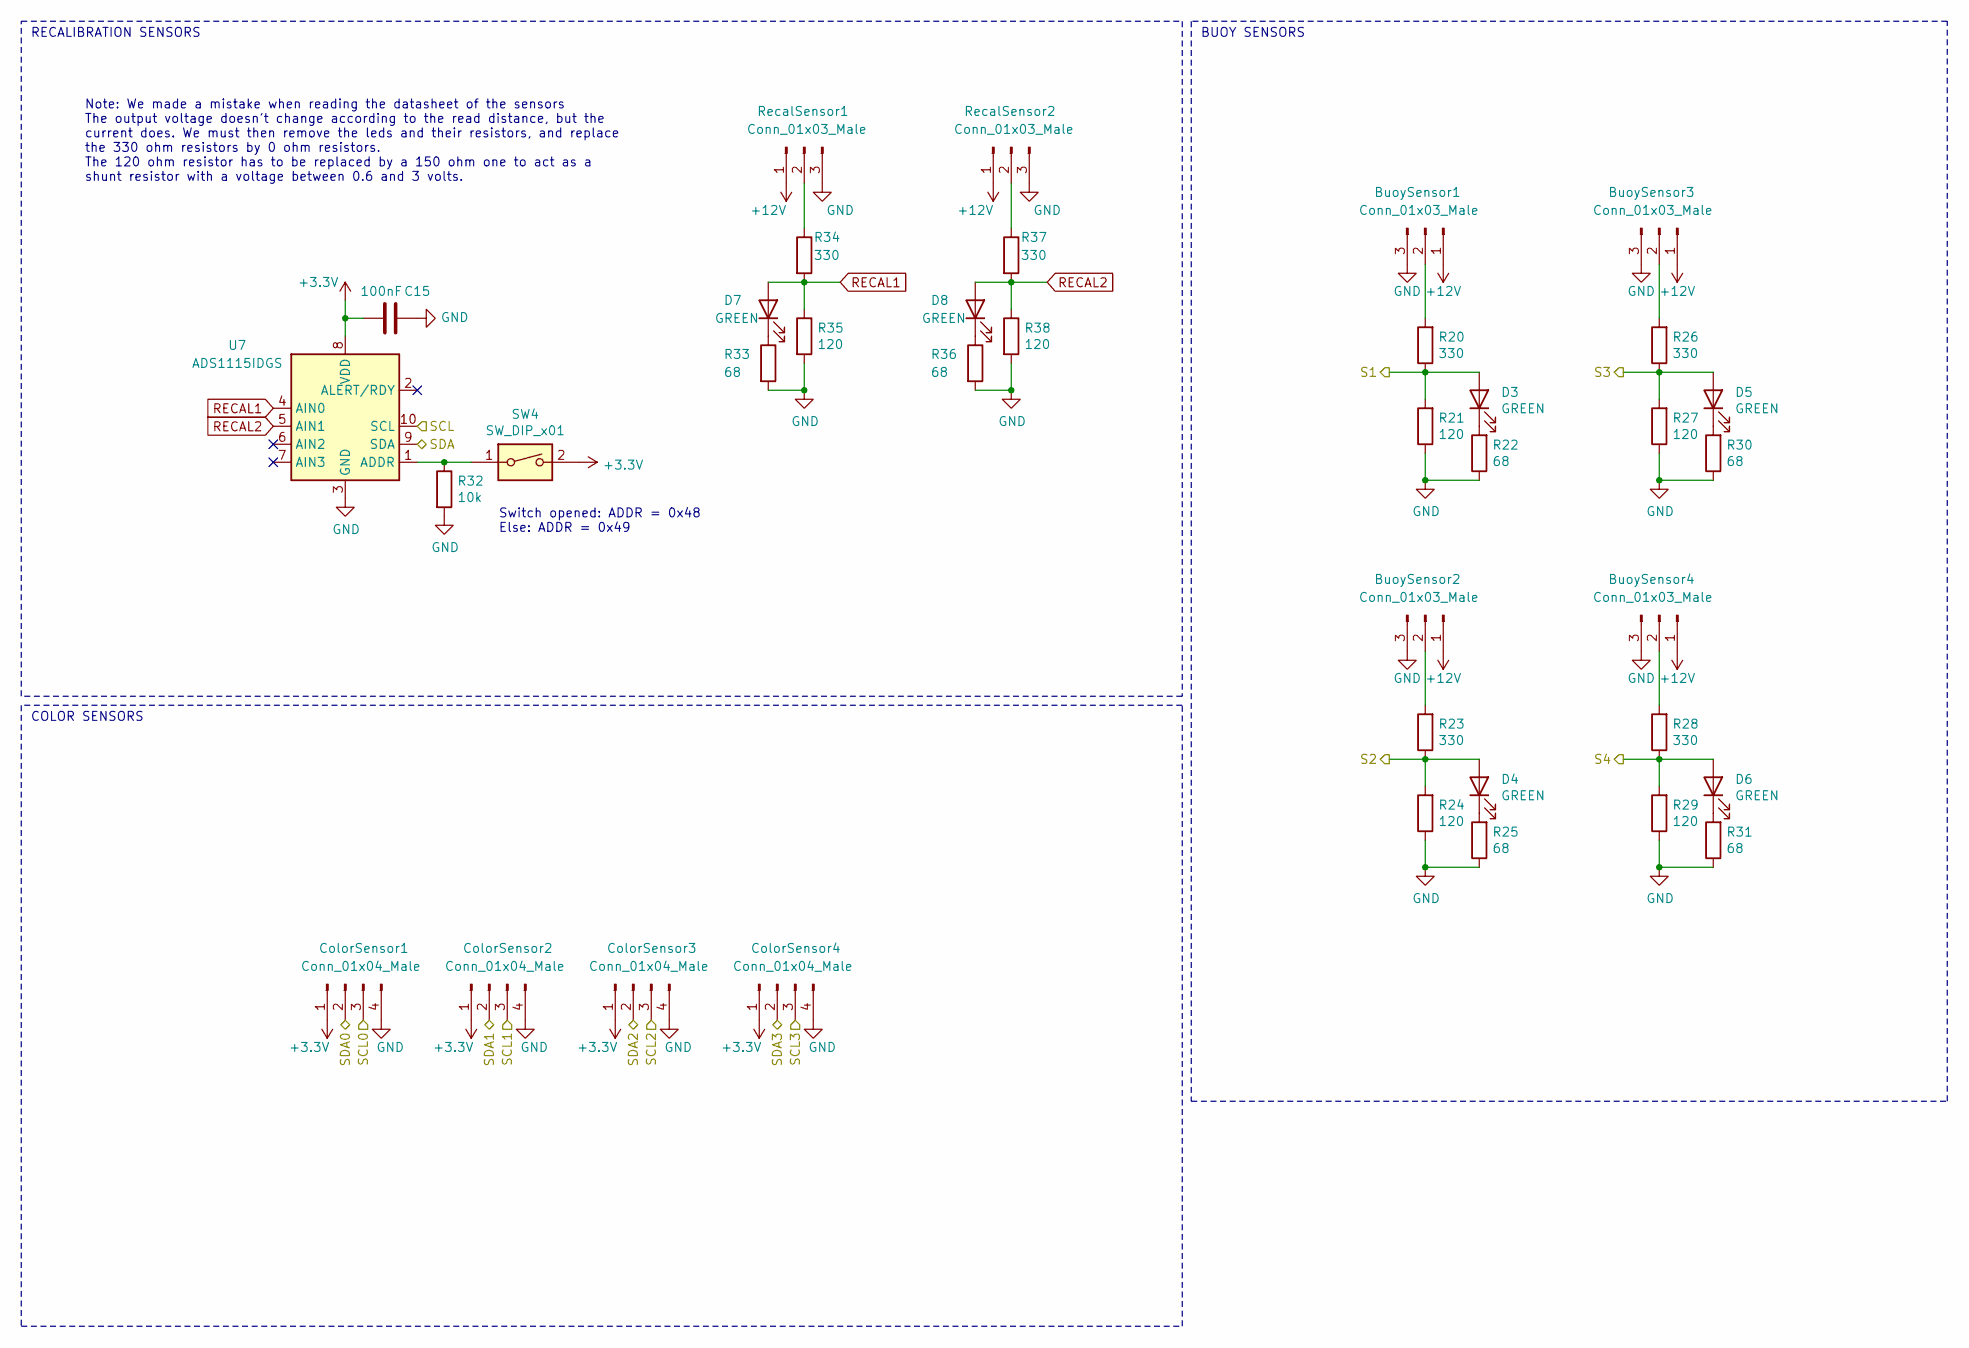
[picture p72: schematic Sensors.sch, Carte Actionneurs]

Parts:
BuoySensor1, BuoySensor2, BuoySensor3, BuoySensor4: Conn_01x03_Male; B03B-PASK
C15: 100nF; C_0603_1608Metric
ColorSensor1, ColorSensor2, ColorSensor3, ColorSensor4: Conn_01x04_Male; B04B-PASK
D3, D4, D5, D6, D7, D8: GREEN; LED_0805_2012Metric
R20, R23, R26, R28, R34, R37: 330; R_0603_1608Metric
R21, R24, R27, R29, R35, R38: 120; R_0603_1608Metric
R22, R25, R30, R31, R33, R36: 68; R_0603_1608Metric
R32: 10k; R_0603_1608Metric
RecalSensor1, RecalSensor2: Conn_01x03_Male; B03B-PASK
SW4: SW_DIP_x01; SW_DIP_SPSTx01_Slide_6.7x4.1mm_W7.62mm_P2.54mm_LowProfile
U7: ADS1115IDGS; TSSOP-10_3x3mm_P0.5mm

Connections:
+3V3: C15.2, ColorSensor1.1, ColorSensor2.1, ColorSensor3.1, ColorSensor4.1, SW4.2, U7.8 (VDD); also elsewhere on the board
+12V: BuoySensor1.1, BuoySensor2.1, BuoySensor3.1, BuoySensor4.1, RecalSensor1.1, RecalSensor2.1; also elsewhere on the board
/Actuators/B8: D3.2 (A), R20.1, R21.2; also elsewhere on the board
/Actuators/B9: D4.2 (A), R23.1, R24.2; also elsewhere on the board
/Actuators/B10: D5.2 (A), R26.1, R27.2; also elsewhere on the board
/Actuators/B11: D6.2 (A), R28.1, R29.2; also elsewhere on the board
/Actuators/SCL0: ColorSensor1.3; also elsewhere on the board
/Actuators/SCL1: ColorSensor2.3; also elsewhere on the board
/Actuators/SCL2: ColorSensor3.3; also elsewhere on the board
/Actuators/SCL3: ColorSensor4.3; also elsewhere on the board
/Actuators/SDA0: ColorSensor1.2; also elsewhere on the board
/Actuators/SDA1: ColorSensor2.2; also elsewhere on the board
/Actuators/SDA2: ColorSensor3.2; also elsewhere on the board
/Actuators/SDA3: ColorSensor4.2; also elsewhere on the board
/SCL: U7.10 (SCL); also elsewhere on the board
/SDA: U7.9 (SDA); also elsewhere on the board
GND: BuoySensor1.3, BuoySensor2.3, BuoySensor3.3, BuoySensor4.3, C15.1, ColorSensor1.4, ColorSensor2.4, ColorSensor3.4, ColorSensor4.4, R21.1, R22.1, R24.1, R25.1, R27.1, R29.1, R30.1, R31.1, R32.2, R33.2, R35.2, R36.2, R38.2, RecalSensor1.3, RecalSensor2.3, U7.3 (GND); also elsewhere on the board
unnamed: BuoySensor1.2, R20.2
unnamed: BuoySensor2.2, R23.2
unnamed: BuoySensor3.2, R26.2
unnamed: BuoySensor4.2, R28.2
unnamed: D3.1 (K), R22.2
unnamed: D4.1 (K), R25.2
unnamed: D5.1 (K), R30.2
unnamed: D6.1 (K), R31.2
unnamed: D7.1 (K), R33.1
unnamed: D8.1 (K), R36.1
unnamed: R32.1, SW4.1, U7.1 (ADDR)
unnamed: R34.1, RecalSensor1.2
unnamed: R37.1, RecalSensor2.2
RECAL1: D7.2 (A), R34.2, R35.1, U7.4 (AIN0); also elsewhere on the board
RECAL2: D8.2 (A), R37.2, R38.1, U7.5 (AIN1); also elsewhere on the board

Notes on the sheet:
Switch opened: ADDR = 0x48 Else: ADDR = 0x49
RECALIBRATION SENSORS
BUOY SENSORS
COLOR SENSORS
Note: We made a mistake when reading the datasheet of the sensors The output voltage doesn't change according to the read distance, but the current does. We must then remove the leds and their resistors, and replace the 330 ohm resistors by 0 ohm resistors. The 120 ohm resistor has to be replaced b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

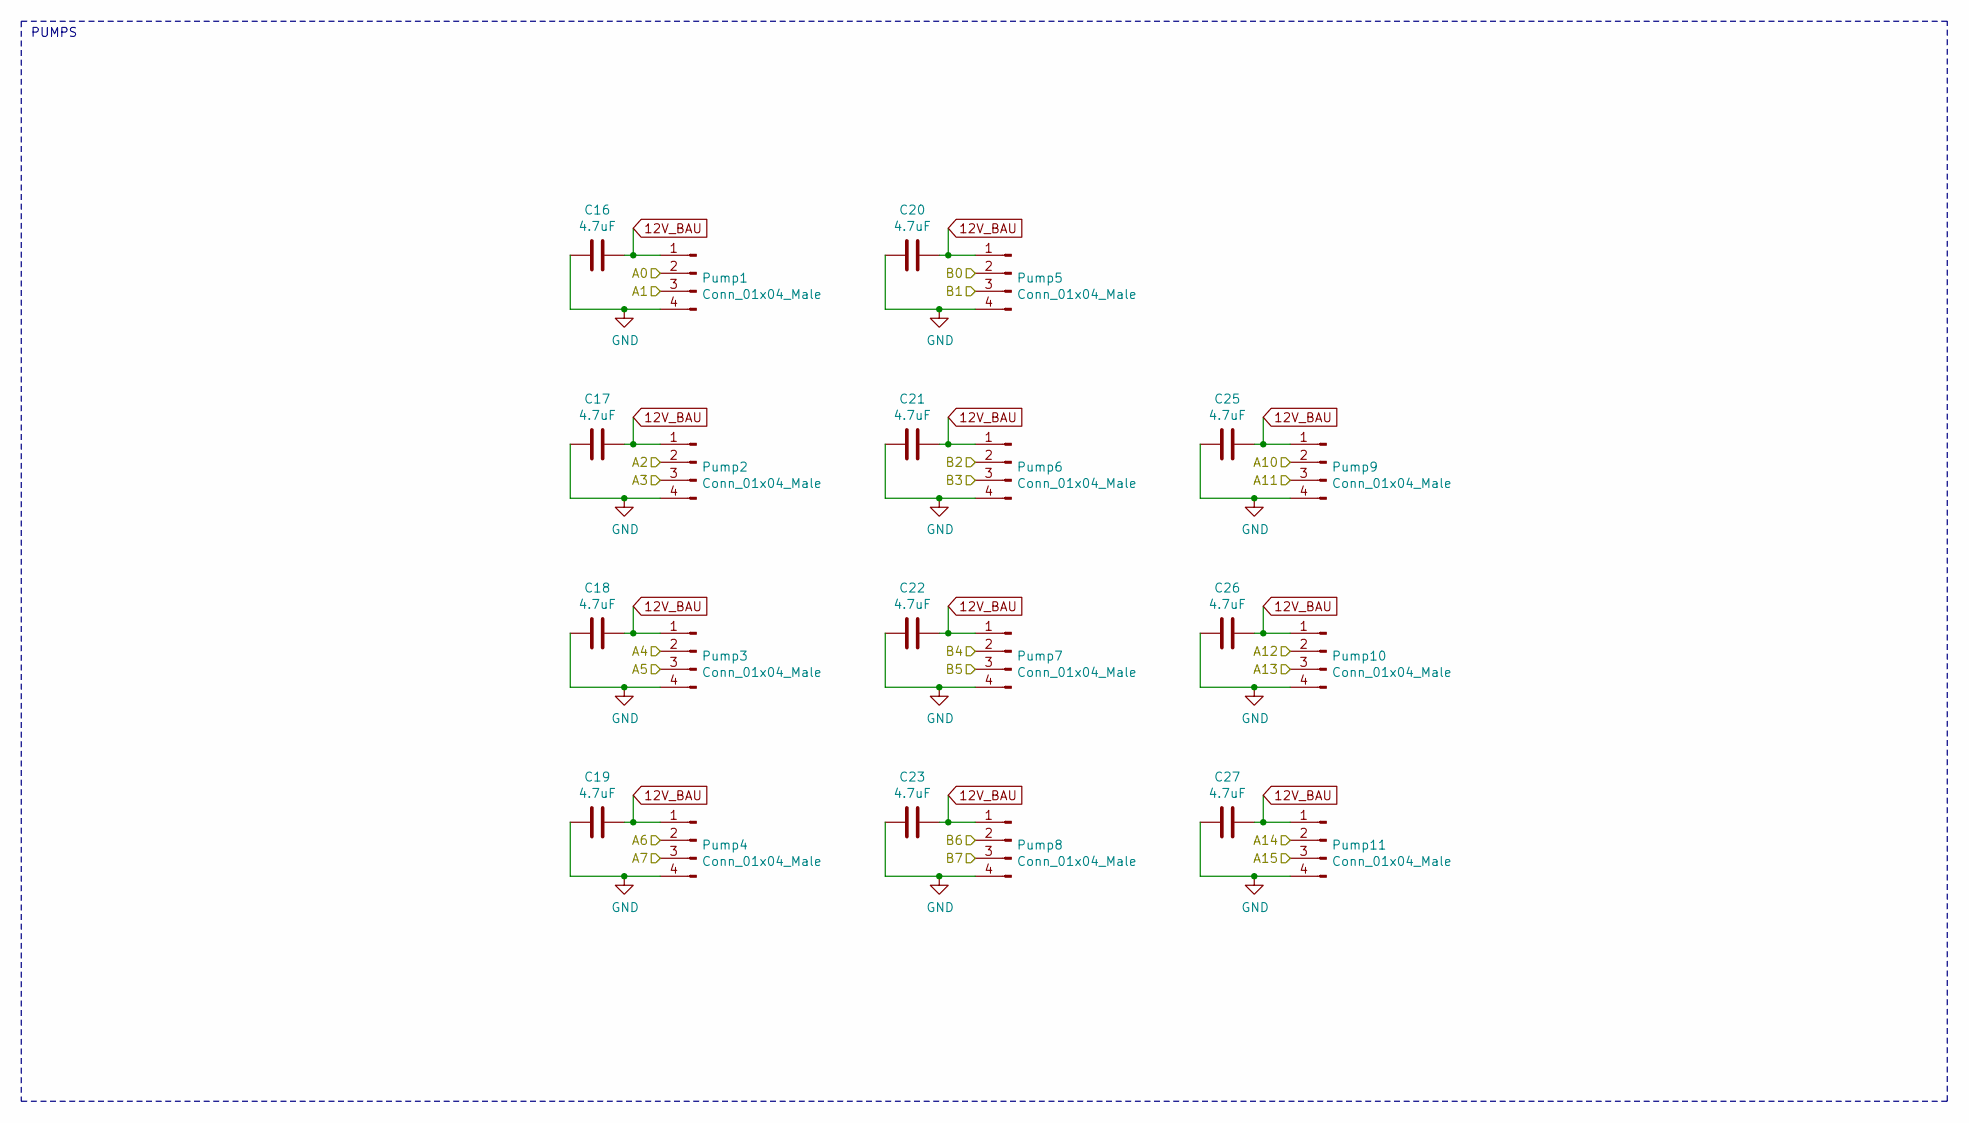
[picture p73: schematic Pumps.sch, Carte Actionneurs]

Parts:
C16, C17, C18, C19, C20, C21, C22, C23, C25, C26, C27: 4.7uF; C_0603_1608Metric
Pump1, Pump2, Pump3, Pump4, Pump5, Pump6, Pump7, Pump8, Pump9, Pump10, Pump11: Conn_01x04_Male; B04B-PASK

Connections:
12V_BAU: C16.1, C17.1, C18.1, C19.1, C20.1, C21.1, C22.1, C23.1, C25.1, C26.1, C27.1, Pump1.1, Pump2.1, Pump3.1, Pump4.1, Pump5.1, Pump6.1, Pump7.1, Pump8.1, Pump9.1, Pump10.1, Pump11.1; also elsewhere on the board
/Actuators/A0: Pump1.2; also elsewhere on the board
/Actuators/A1: Pump1.3; also elsewhere on the board
/Actuators/A2: Pump2.2; also elsewhere on the board
/Actuators/A3: Pump2.3; also elsewhere on the board
/Actuators/A4: Pump3.2; also elsewhere on the board
/Actuators/A5: Pump3.3; also elsewhere on the board
/Actuators/A6: Pump4.2; also elsewhere on the board
/Actuators/A7: Pump4.3; also elsewhere on the board
/Actuators/A10: Pump9.2; also elsewhere on the board
/Actuators/A11: Pump9.3; also elsewhere on the board
/Actuators/A12: Pump10.2; also elsewhere on the board
/Actuators/A13: Pump10.3; also elsewhere on the board
/Actuators/A14: Pump11.2; also elsewhere on the board
/Actuators/A15: Pump11.3; also elsewhere on the board
/Actuators/B0: Pump5.2; also elsewhere on the board
/Actuators/B1: Pump5.3; also elsewhere on the board
/Actuators/B2: Pump6.2; also elsewhere on the board
/Actuators/B3: Pump6.3; also elsewhere on the board
/Actuators/B4: Pump7.2; also elsewhere on the board
/Actuators/B5: Pump7.3; also elsewhere on the board
/Actuators/B6: Pump8.2; also elsewhere on the board
/Actuators/B7: Pump8.3; also elsewhere on the board
GND: C16.2, C17.2, C18.2, C19.2, C20.2, C21.2, C22.2, C23.2, C25.2, C26.2, C27.2, Pump1.4, Pump2.4, Pump3.4, Pump4.4, Pump5.4, Pump6.4, Pump7.4, Pump8.4, Pump9.4, Pump10.4, Pump11.4; also elsewhere on the board

Notes on the sheet:
PUMPS

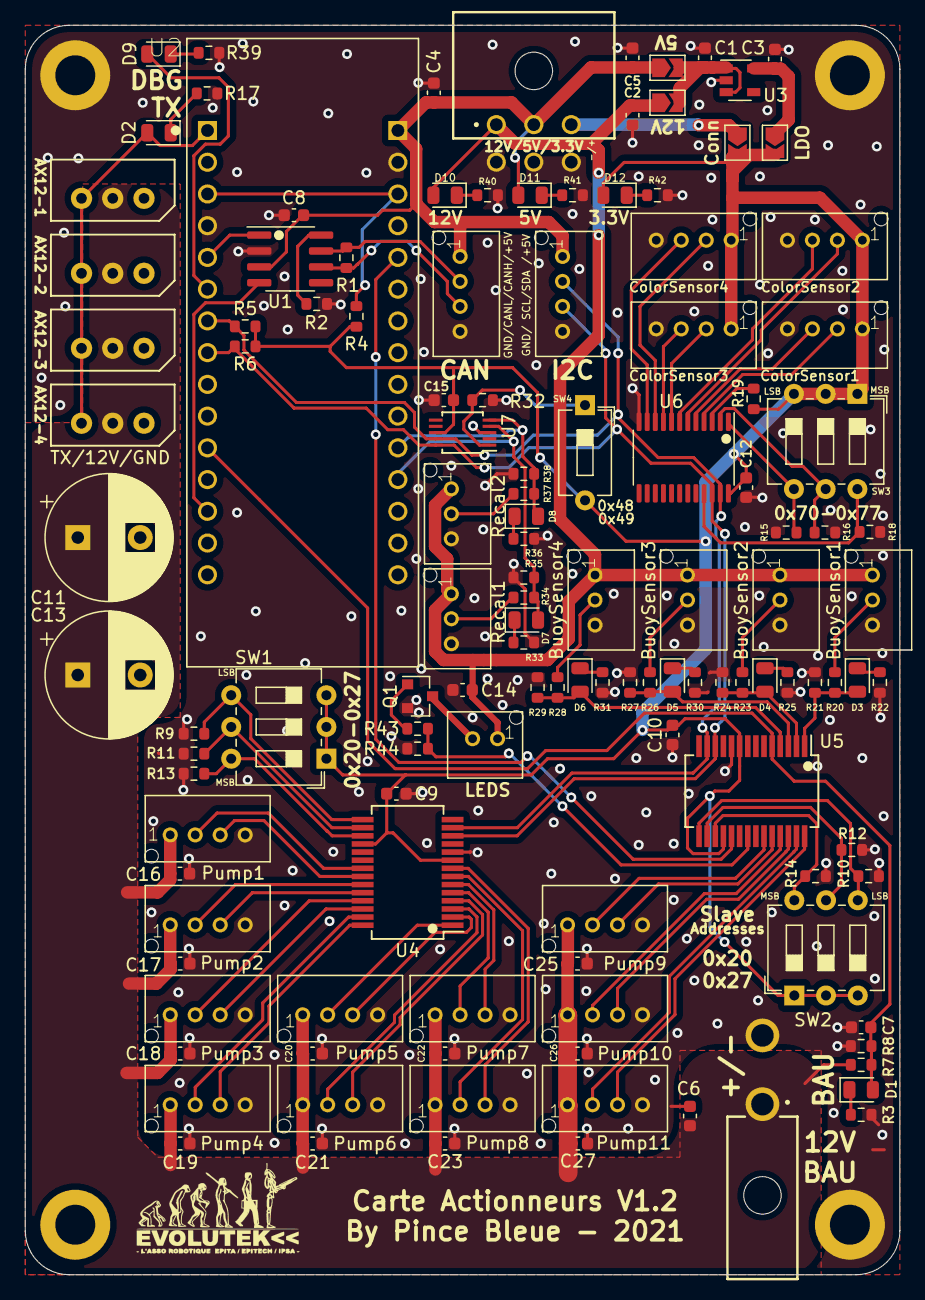
[picture p74: board Carte Actionneurs.kicad_pcb from above]

Board: 2 copper layers, 70.0 x 100.0 mm, 128 parts (0 on the bottom side), 88 nets.
