evolutek/carte-actionneurs/Cartes PAL 2026/Carte Mobile/carte-mobile.kicad_pcb

## KiCad design Cartes PAL 2026/Carte Mobile/carte-mobile.kicad_pcb (2026-10-21)

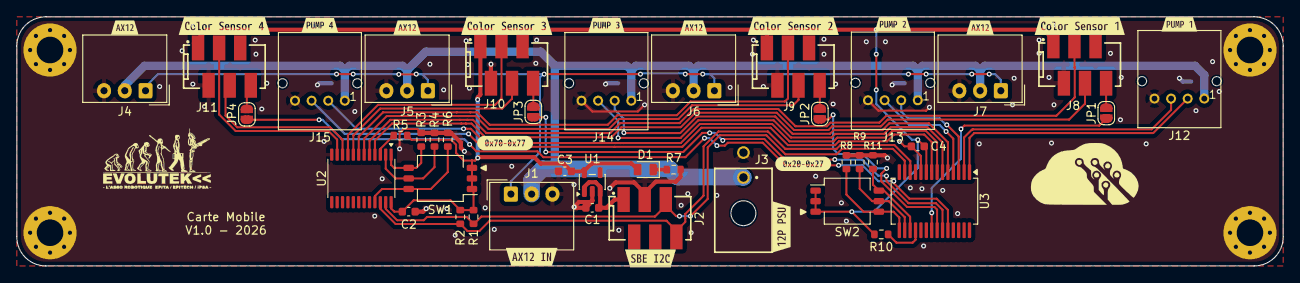
[picture p77: board carte-mobile.kicad_pcb from above]

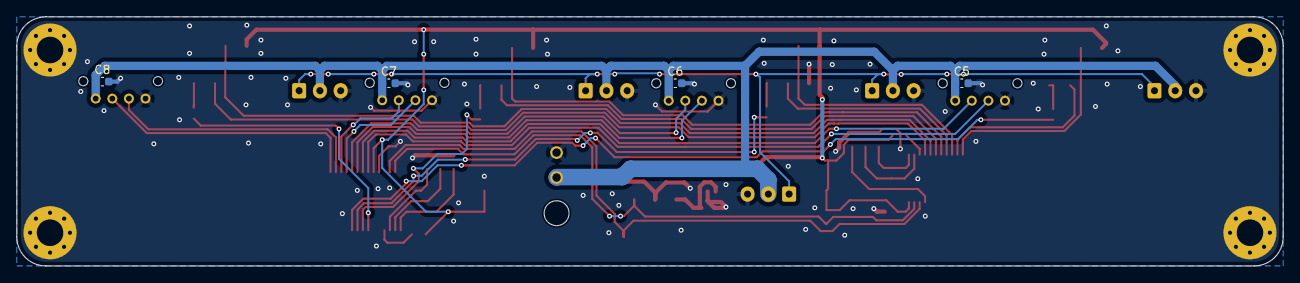
[picture p78: board carte-mobile.kicad_pcb from below]

Board: 2 copper layers, 152.5 x 30.0 mm, 67 parts (4 on the bottom side), 40 nets.

Parts:
C1, C3: 10uF; C_0603_1608Metric
C2, C4: 100nF; C_0603_1608Metric
C5, C6, C7, C8: 4.7uF; C_0603_1608Metric
D1: RED; LED_0805_2012Metric
H1, H2, H3, H4: M3; MountingHole_3.2mm_M3_Pad_Via
J1: AX12 IN; 22-05-7035
J2: SBE I2C; 690367280676
J3: 12P PSU; 66200221022
J4, J5, J6, J7: AX12; 22-05-7035
J8, J9, J10, J11: Color Sensor; 690367280676
J12, J13, J14, J15: Pump; S04B-PASK
JP1, JP2, JP3, JP4: SolderJumper_2_Open; SolderJumper-2_P1.3mm_Open_RoundedPad1.0x1.5mm
LB1: LOGO; logo-evo-min
LB2: LOGO; Logo Aisler Min
R1, R2: 4.7k; R_0603_1608Metric
R3, R4, R5, R6, R7, R8, R9, R10, R11: 10k; R_0603_1608Metric
SW1, SW2: SW_DIP_x03; SW_DIP_SPSTx03_Slide_KingTek_DSHP03TS_W7.62mm_P1.27mm
U1: NCP718xSN330; SOT-23-5
U2: TCA9548APWR; TSSOP-24_4.4x7.8mm_P0.65mm
U3: MCP23017_SS; SSOP-28_5.3x10.2mm_P0.65mm
kibuzzard-69CA1A14: G***; kibuzzard-69CA1A14
kibuzzard-69CA1B5C: G***; kibuzzard-69CA1B5C
kibuzzard-69CA18C1: G***; kibuzzard-69CA18C1
kibuzzard-69CA18D8: G***; kibuzzard-69CA18D8
kibuzzard-69CA18E8: G***; kibuzzard-69CA18E8
kibuzzard-69CA191C: G***; kibuzzard-69CA191C
kibuzzard-69CA194B: G***; kibuzzard-69CA194B
kibuzzard-69CA198F: G***; kibuzzard-69CA198F
kibuzzard-69CA1904: G***; kibuzzard-69CA1904
kibuzzard-69CA1929: G***; kibuzzard-69CA1929
kibuzzard-69CA1933: G***; kibuzzard-69CA1933
kibuzzard-69CA1962: G***; kibuzzard-69CA1962
kibuzzard-69CA1972: G***; kibuzzard-69CA1972
kibuzzard-69CA1993, kibuzzard-69CA1993#2, kibuzzard-69CA1993#3, kibuzzard-69CA1993#4: G***; kibuzzard-69CA1993

Connections:
+3.3V: C2.1, C3.1, C4.1, D1.2 (A), J8.1, J9.1, J10.1, J11.1, R1.1, R2.1, R5.1, R10.1, SW1.1, SW1.2, SW1.3, SW2.1, SW2.2, SW2.3, U1.5 (OUT), U2.24 (VCC), U3.9 (VDD)
+5VL: C1.1, J2.1, U1.1 (IN), U1.3 (EN)
+12P: C5.1, C6.1, C7.1, C8.1, J1.2, J3.1, J4.2, J5.2, J6.2, J7.2, J12.1, J13.1, J14.1, J15.1
/AX12: J1.1, J4.1, J5.1, J6.1, J7.1
/EV1: J12.3, U3.2 (GPB1)
/EV2: J13.3, U3.4 (GPB3)
/EV3: J14.3, U3.6 (GPB5)
/EV4: J15.3, U3.8 (GPB7)
/LED0: J8.6, JP1.2 (B)
/LED1: J9.6, JP2.2 (B)
/LED2: J10.6, JP3.2 (B)
/LED3: J11.6, JP4.2 (B)
/PUMP1: J12.2, U3.1 (GPB0)
/PUMP2: J13.2, U3.3 (GPB2)
/PUMP3: J14.2, U3.5 (GPB4)
/PUMP4: J15.2, U3.7 (GPB6)
/SCL: J2.6, R2.2, U2.22 (SCL), U3.12 (SCK)
/SCL0: J8.3, U2.5 (SC0)
/SCL1: J9.3, U2.7 (SC1)
/SCL2: J10.3, U2.9 (SC2)
/SCL3: J11.3, U2.11 (SC3)
/SDA: J2.5, R1.2, U2.23 (SDA), U3.13 (SDA)
/SDA0: J8.4, U2.4 (SD0)
/SDA1: J9.4, U2.6 (SD1)
/SDA2: J10.4, U2.8 (SD2)
/SDA3: J11.4, U2.10 (SD3)
GND: C1.2, C2.2, C3.2, C4.2, C5.2, C6.2, C7.2, C8.2, H1.1, H2.1, H3.1, H4.1, J1.3, J2.3, J3.2, J4.3, J5.3, J6.3, J7.3, J8.2, J9.2, J10.2, J11.2, J12.4, J13.4, J14.4, J15.4, R3.2, R4.2, R6.2, R7.1, R8.2, R9.2, R11.2, U1.2 (GND), U2.12 (GND), U3.10 (VSS)
unnamed: D1.1 (K), R7.2
unnamed: JP1.1 (A), U3.21 (GPA0)
unnamed: JP2.1 (A), U3.22 (GPA1)
unnamed: JP3.1 (A), U3.23 (GPA2)
unnamed: JP4.1 (A), U3.24 (GPA3)
unnamed: R3.1, SW1.4, U2.1 (A0)
unnamed: R4.1, SW1.5, U2.2 (A1)
unnamed: R6.1, SW1.6, U2.21 (A2)
unnamed: R5.2, U2.3 (~RESET)
unnamed: R8.1, SW2.4, U3.15 (A0)
unnamed: R9.1, SW2.5, U3.16 (A1)
unnamed: R11.1, SW2.6, U3.17 (A2)
unnamed: R10.2, U3.18 (~RESET)
