evolutek/carte-actionneurs/Carte Stepper V1/firmware/Core/Src/main.c

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
/* Includes ------------------------------------------------------------------*/
#include "main.h"

/* USER CODE BEGIN Includes */
#include "stepper_control.h"
#include "stdbool.h"
#include "stdio.h"
/* USER CODE END Includes */

/* USER CODE BEGIN PD */

#define STEPPERS_AMNT 3

/* USER CODE END PD */

ADC_HandleTypeDef hadc2;

FDCAN_HandleTypeDef hfdcan2;

I2C_HandleTypeDef hi2c2;

TIM_HandleTypeDef htim1;
TIM_HandleTypeDef htim2;
TIM_HandleTypeDef htim3;

UART_HandleTypeDef huart2;

PCD_HandleTypeDef hpcd_USB_FS;

void SystemClock_Config(void);
static void MX_GPIO_Init(void);
static void MX_ADC2_Init(void);
static void MX_FDCAN2_Init(void);
static void MX_I2C2_Init(void);
static void MX_TIM1_Init(void);
static void MX_TIM2_Init(void);
static void MX_TIM3_Init(void);
static void MX_USART2_UART_Init(void);
static void MX_USB_PCD_Init(void);
/* USER CODE BEGIN 0 */

int __io_putchar(char c){
	HAL_UART_Transmit(&huart2, (uint8_t*)&c, 1, HAL_MAX_DELAY);
	return c;
}

stepper_config_t stepper_configs[STEPPERS_AMNT] = {
	{
		.handle = &htim1,
		.channel = TIM_CHANNEL_3,
		.channel_inverted = false,

		.dir_port = GPIOA,
		.dir_pin = GPIO_PIN_15,
		.dir_inverted = false,

		.clock = 168000000,
		.max_freq = 2000000,

		.kp = 30,
		.kd = 0,
		.ki = 10,
		.integral_max = 1000000,
	},{
		.handle = &htim2,
		.channel = TIM_CHANNEL_2,
		.channel_inverted = false,

		.dir_port = GPIOB,
		.dir_pin = GPIO_PIN_4,
		.dir_inverted = false,

		.clock = 168000000,
		.max_freq = 2000000,

		.kp = 30,
		.kd = 0,
		.ki = 10,
		.integral_max = 1000000,
	},{
		.handle = &htim3,
		.channel = TIM_CHANNEL_2,
		.channel_inverted = false,

		.dir_port = GPIOA,
		.dir_pin = GPIO_PIN_5,
		.dir_inverted = false,

		.clock = 168000000,
		.max_freq = 2000000,

		.kp = 30,
		.kd = 0,
		.ki = 10,
		.integral_max = 1000000,
	}
};

stepper_t steppers[STEPPERS_AMNT] = {0};


/* USER CODE END 0 */

/**
  * @brief  The application entry point.
  * @retval int
  */
int main(void)
{

  /* MCU Configuration--------------------------------------------------------*/

  /* Reset of all peripherals, Initializes the Flash interface and the Systick. */
  HAL_Init();

  /* Configure the system clock */
  SystemClock_Config();

  /* Initialize all configured peripherals */
  MX_GPIO_Init();
  MX_ADC2_Init();
  MX_FDCAN2_Init();
  MX_I2C2_Init();
  MX_TIM1_Init();
  MX_TIM2_Init();
  MX_TIM3_Init();
  MX_USART2_UART_Init();
  MX_USB_PCD_Init();
  /* USER CODE BEGIN 2 */
  printf("Init done\n\r");



  for (uint8_t stepper_i = 0; stepper_i < STEPPERS_AMNT; stepper_i++)
	  stepperInit(&steppers[stepper_i], &stepper_configs[stepper_i]);



  HAL_GPIO_WritePin(MOTOR_EN_GPIO_Port, MOTOR_EN_Pin, GPIO_PIN_SET);

  for (uint8_t stepper_i = 0; stepper_i < STEPPERS_AMNT; stepper_i++)
	  stepperSetFrequency(&steppers[stepper_i], 2000);


  printf("Code alive and running\n\r");
  /* USER CODE END 2 */

  /* Infinite loop */
  /* USER CODE BEGIN WHILE */
  while (1)
  {
	  HAL_GPIO_TogglePin(STATUS_GPIO_Port, STATUS_Pin);
	  HAL_Delay(1000);
    /* USER CODE END WHILE */

    /* USER CODE BEGIN 3 */
  }
  /* USER CODE END 3 */
}

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
