evolutek/carte-actionneurs/Carte Stepper V1/firmware/Core/Inc/main.h

#define MOTOR_EN_Pin GPIO_PIN_0
#define MOTOR_EN_GPIO_Port GPIOA
#define SENSOR1_Pin GPIO_PIN_1
#define SENSOR1_GPIO_Port GPIOA
#define VCP_TX_Pin GPIO_PIN_2
#define VCP_TX_GPIO_Port GPIOA
#define VCP_RX_Pin GPIO_PIN_3
#define VCP_RX_GPIO_Port GPIOA
#define MOTOR_STP_C_Pin GPIO_PIN_4
#define MOTOR_STP_C_GPIO_Port GPIOA
#define MOTOR_DIR_C_Pin GPIO_PIN_5
#define MOTOR_DIR_C_GPIO_Port GPIOA
#define SENSOR2_Pin GPIO_PIN_6
#define SENSOR2_GPIO_Port GPIOA
#define SENSOR3_Pin GPIO_PIN_7
#define SENSOR3_GPIO_Port GPIOA
#define AU_Pin GPIO_PIN_0
#define AU_GPIO_Port GPIOB
#define MOTOR_STP_A_Pin GPIO_PIN_10
#define MOTOR_STP_A_GPIO_Port GPIOA
#define MOTOR_DIR_A_Pin GPIO_PIN_15
#define MOTOR_DIR_A_GPIO_Port GPIOA
#define MOTOR_STP_B_Pin GPIO_PIN_3
#define MOTOR_STP_B_GPIO_Port GPIOB
#define MOTOR_DIR_B_Pin GPIO_PIN_4
#define MOTOR_DIR_B_GPIO_Port GPIOB
#define CAN_RX_Pin GPIO_PIN_5
#define CAN_RX_GPIO_Port GPIOB
#define CAN_TX_Pin GPIO_PIN_6
#define CAN_TX_GPIO_Port GPIOB
#define STATUS_Pin GPIO_PIN_7
#define STATUS_GPIO_Port GPIOB
