evolutek/carte-actionneurs/(commit log)

2021-01-08 Add actuators part of the new motherboard
    [Carte Actionneurs.sch, I2C-Sensors.sch, Pumps.sch, Sensors.sch, Servos.sch]
2021-01-11 Schematic almost done
    [Actuators.sch, Carte Actionneurs.sch, I2C-Sensors.sch, Pumps.sch, Sensors.sch, Servos.sch]
2021-01-11 Schematic done
    [Actuators.sch, Carte Actionneurs.sch, Pumps.sch, Sensors.sch]
2021-01-11 Schematic fixes
    [Actuators.sch, Carte Actionneurs.sch, Pumps.sch, Sensors.sch]
2021-01-13 Started PCB
    [Actuators.sch, Carte Actionneurs.kicad_pcb, Carte Actionneurs.sch, Sensors.sch]
2021-01-14 PCB almost done
    [Carte Actionneurs.kicad_pcb, Carte Actionneurs.sch]
2021-01-15 PCB done
    [Carte Actionneurs.kicad_pcb]
2021-01-20 2nd routing done
    [Carte Actionneurs.kicad_pcb, Carte Actionneurs.sch]
2021-01-20 PCB improvements
    [Carte Actionneurs.kicad_pcb]
2021-01-20 Release V1.0
    [Actuators.sch, Carte Actionneurs.kicad_pcb, Carte Actionneurs.sch, Pumps.sch, Sensors.sch]
2021-01-31 bom, step, pdf
    [Carte Actionneurs.kicad_pcb]
2021-02-14 V1.1 Removed Nucleo 5V, add LEDS mosfet
    [Actuators.sch, Carte Actionneurs.kicad_pcb, Carte Actionneurs.sch, Pumps.sch, Sensors.sch]
2021-02-14 Fixed unconnected GND + IC orientation helpers
    [Actuators.sch, Carte Actionneurs.kicad_pcb, Carte Actionneurs.sch, Pumps.sch, Sensors.sch]
2021-02-20 pdfs, step, gerber, bom
2021-02-22 Fabrication output for V1.1
    [Actuators.sch, Carte Actionneurs.kicad_pcb, Carte Actionneurs.sch, Sensors.sch]
2021-02-23 LEDS were on wrong GPIO bank
    [Actuators.sch, Carte Actionneurs.kicad_pcb, Carte Actionneurs.sch, Pumps.sch]
2021-02-24 Graphics fixes
    [Carte Actionneurs.kicad_pcb]
2021-03-07 Added recal sensors note
    [Sensors.sch]
2021-03-14 Updated schematics.pdf
2021-04-18 Replaced the ADS1114 by an ADS1115
    [Carte Actionneurs.kicad_pcb, Sensors.sch]
2021-05-02 Led strip mosfet gate pulldown
    [Actuators.sch, Carte Actionneurs.kicad_pcb]
2021-12-27 Add a test board for a h bridge component
    [Carte Test Pont en H.kicad_pcb, Carte Test Pont en H.sch]
2022-05-01 Add Carte Rallonge Actionneurs 2022 V1
    [CarteRallongeActionneurs2022.kicad_pcb, CarteRallongeActionneurs2022.sch]
2022-05-01 Fix gueule
    [CarteRallongeActionneurs2022.kicad_pcb]
2023-03-06 Wip Carte Acts V2
    [MCP23017.kicad_sch, PCA9685.kicad_sch, V2.kicad_sch]
2023-03-07 Wip V2.0
    [MCP23017.kicad_sch, PCA9685.kicad_sch, V2.kicad_pcb, V2.kicad_sch]
2023-03-13 Add TCA9548A on the schematics
    [MCP23017.kicad_sch, PCA9685.kicad_sch, TCA9548A.kicad_sch, V2.kicad_pcb, V2.kicad_sch]
2023-03-13 Wip pcb
    [PCA9685.kicad_sch, V2.kicad_pcb, V2.kicad_sch]
2023-03-15 Release V2.0
    [MCP23017.kicad_sch, PCA9685.kicad_sch, TCA9548A.kicad_sch, V2.kicad_pcb, V2.kicad_sch]
2023-04-03 Fix servos pinout and minor fixes
    [MCP23017.kicad_sch, PCA9685.kicad_sch, TCA9548A.kicad_sch, V2.kicad_pcb, V2.kicad_sch]
2023-04-03 Fix ESCs mapping
    [MCP23017.kicad_sch, PCA9685.kicad_sch, TCA9548A.kicad_sch, V2.kicad_pcb, V2.kicad_sch]
2024-03-29 Add V3.0
    [carte-actionneurs.kicad_pcb, carte-actionneurs.kicad_sch]
2024-03-29 Fix I2C mistake
    [carte-actionneurs.kicad_pcb, carte-actionneurs.kicad_sch]
2024-03-29 Fix schematics
    [carte-actionneurs.kicad_sch]
2025-03-19 WIP carte actionneurs V3-Bis
    [carte-actionneurs.kicad_pcb, carte-actionneurs.kicad_sch]
2025-03-19 WIP V3-Bis
    [carte-actionneurs.kicad_pcb, carte-actionneurs.kicad_sch]
2025-03-19 WIP V3 Bis
    [carte-actionneurs.kicad_pcb, carte-actionneurs.kicad_sch]
2025-03-20 Carte Actionneurs V3.0 Bis
    [carte-actionneurs.kicad_pcb, carte-actionneurs.kicad_sch]
2025-04-28 WIP carte stepper v1
    [carte-stepper.kicad_pcb, carte-stepper.kicad_sch]
2025-04-30 WIP Carte stepper V1.0
    [carte-stepper.kicad_sch]
2025-05-01 WIP Carte Stepper
    [carte-stepper.kicad_pcb, carte-stepper.kicad_sch]
2025-05-12 Release Hub Bus Actuators V1.0
    [hub-bus-actuators.kicad_pcb, hub-bus-actuators.kicad_sch]
2025-05-14 Release Carte Stepper V1.0
    [carte-stepper.kicad_pcb, carte-stepper.kicad_sch]
2025-05-20 basic functionnality test
    all 3 motors seem OK
2025-05-21 Release Carte ADC V1.0
    [carte-adc.kicad_pcb, carte-adc.kicad_sch]
2025-06-11 Swap I2C
    [carte-adc.kicad_pcb, carte-adc.kicad_sch, carte-adc.step]
2026-03-30 Regenerate Doigts Output
    [Doigts 1.0.step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]
2026-03-30 Regenerate output
    [Repartiteur 1.0.step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]
2026-03-30 Carte Mobile V1.0
    [carte-mobile V1.0.step, carte-mobile.kicad_pcb, carte-mobile.kicad_sch]
2026-05-03 WIP Carte Fixe
    [carte-fixe.kicad_pcb, carte-fixe.kicad_sch]
2026-05-05 Carte Fixe V1.0
    [carte-fixe V1.0.step, carte-fixe.kicad_pcb, carte-fixe.kicad_sch]
